HaoFengChenFu/X02X03X04_Casa_Domotica/README.md

# Proyecto de la Casa Domotica

***
**Pines usados**
***
| Pines | Funcionalidad |
|---|---|
| PE11  | Interrupción PIR |
| PD12  | Interrupción del mando a distancia 	|
| PC13  | Interrupción del botón de usuario |
| PC3 | ADC del LDR |
| PD15	| PWM LDR (TIM4_CH4)		|
| PB8 | SCL Temperatura y Humedad |
| PB9 | SDA Temperatura y Humedad |
| PC6	| Ventilador				|
| PB4 | Servomotor Ventilador 	|
| PF7  | Servomotor Puertas Garaje |
| PC0 | ADC Corriente |
| PA3 | ADC Sismo |

***
**Tareas pendientes**
***
Cuando se haya acabado una tarea hay que entrar en el README.md y añadir una x al [ ] --> [x]

| Tarea 	| Descripcion 							| Check	|
|---|---|---|
| Consumo LCD 	| Mostrar el consumo en el LCD 						|<ul><li>- [x] Acabado </li></ul>|
| Alimentacion	| Acabar la alimentacion de la placa y los sensores	|<ul><li>- [ ] Acabado </li></ul>|
| Servidor 	| Acabar el servidor 								|<ul><li>- [x] Acabado </li></ul>|
| Bajo consumo  | Gestionar el modo de bajo consumo					|<ul><li>- [ ] Acabado </li></ul>|
| Flash			| Gestionar el guardado de la Flash					|<ul><li>- [ ] Acabado </li></ul>|
