HaoFengChenFu/X02X03X04_Casa_Domotica/Memoria.docx

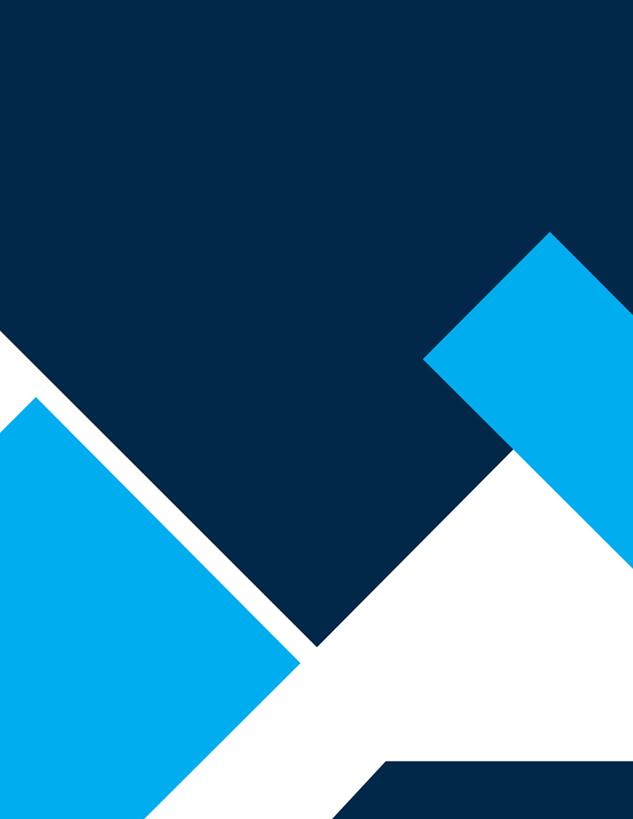
[picture p1: figure]

Ingeniería de Sistemas Electrónicos

Casa Domótica

Curso 2022-2023

Bloque 2

Autores:

Hao Feng Chen Fu

Álvaro Rodriguez Piñeiro

Jaime Ruiz López

Gonzalo Santa Cruz del Río

Valeriu Petre Stanca

# 1 Objetivos de la PRÁCTICA

T

## 1.1 Resumen de los objetivos de la práctica realizada

## 1.2 Acrónimos utilizados

PIR | Passive InfraRed
GPIO | General Purpose Input/Output
I2C | Inter-Integrated Circuit
SPI | Serial Peripherical Interface
ISR | Interrupt Service Routine
PWM | Pulse Width Modulation
LCD | Liquid Cristal Display
LED | Light-Emitting Diode
ADC | Analog-to-Digital Converter
SW | Software
HW | Hardware

## 1.3 Tiempo empleado en la realización de la práctica.

| [Tiempo empleado para realizar la práctica]: El tiempo total empleado ha sido de 400 horas aproximadamente.

## 1.4 Bibliografía utilizada

[RD1] Manual de usuario, Carmine Noviello – Mastering STM32
[RD2] Datasheet, SHT30
[RD3] Datasheet, HC-SR501
[RD4] Datasheet, HXYP-2S-A18 2S

## 1.5 Autoevaluación.

- Identificar en un documento de especificaciones técnicas de un sistema electrónico los requisitos técnicos necesarios para plantear diferentes alternativas tecnológicas para la implementación práctica del mismo.
- Desarrollar un sistema electrónico de mediana complejidad combinando diferentes tecnologías
- Construir sistemas electrónicos utilizando PCBs aplicando las técnicas de diseño adecuadas a la tipología del diseño
- Emplear la instrumentación de laboratorio, las herramientas de desarrollo y depuración comerciales para la integración y puesta a punto de circuitos y sistemas electrónicos.
- Saber generar documentación precisa y transferible sobre el sistema desarrollado.

EXPLICAR ALGUNA DIFICULTAD DEL PROYECTO

Una de las dificultades que hemos encontrado a la hora de realizar el proyecto es el tema de la alimentacion, ya que debiamos encontrar una manera de alimentar todos los subsistemas del proyecto haciendo uso de alimentacion externa. Para este proposito hemos elegido un par de baterias 18650 puestas en serie, ya que con esto obteniamos 7.4V de alimentacion (8.4V en vacio). Junto con esto hemos elgido una celula fotovoltaica para cargar dichas baterias, junto a un modulo de carga (HXYP-2S-A18 2S) para evitar tanto sobrecargas como sobredescargas. El problema real que encontramos es el de conseguir la tensión suficiente como para cargar dichas baterias, ya que la celula nos entregaba 5V y el modulo de carga demandaba 9V para cargar las baterias. Finalmente decidimos comprar un par de celulas mas y conectarlas en serie junto a la otra para conseguir la tensión minima necesaria.

Otra dificultad encontrada durante el desarrollo del proyecto ha sido a la hora del diseño y soldado de las placas de circuito impreso, ya que durante el diseño de estas se cometieron un par de errores como son el olvido a la hora de colocar un condensador en una placa y una pista necesaria en otra de las placas. Ambos errores fueron facilmente subsanables y no hubo mayor problema.

La mayor dificultad encontrada, por lo menos en la parte HW, fue el tema del acondicionamiento del sensor piezoelectrico, ya que era un componente poco trabajado y del que poseaimos pocos conocimientos. Tras unas intensas busquedas y despues de informarnos acerca del funcionamiento de estos, conseguimos acondicionarlo de manera adecuada y ponerlo a trabajar de la forma que queriamos.

# 2 RECURSOS UTILIZADOS DEL MICROCONTROLADOR

## 2.1 Diagrama de bloques hardware del sistema.

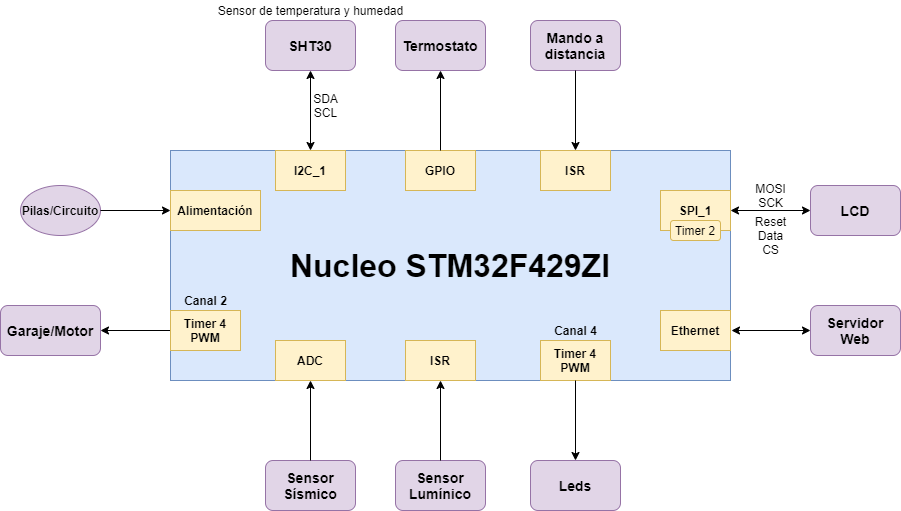
[picture p2: figure]

Figura 1: Conexión hardware

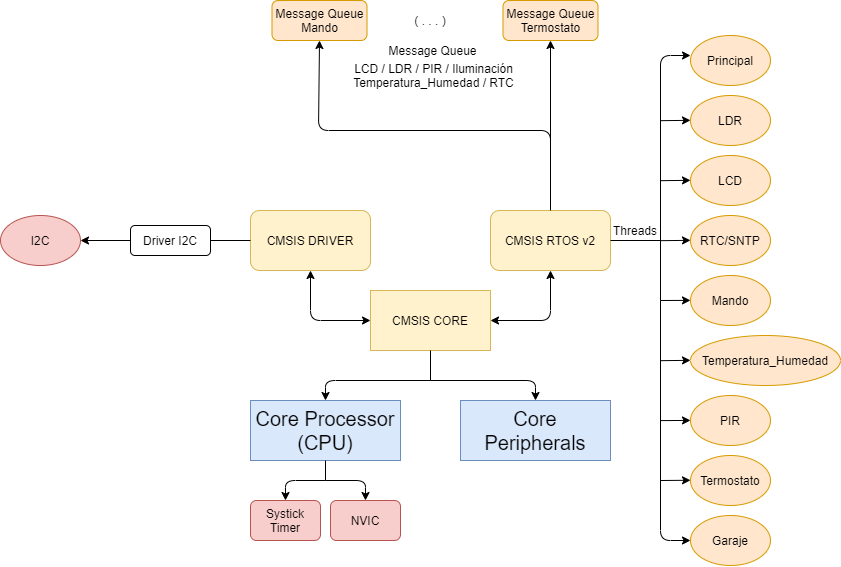
[picture p3: figure]

Figura 2: Conexiones del CMSIS

Pines STM32F429ZI | Funcionalidad
PE11 | Interrupción PIR
PD12 | Interrupción mando a distancia
PC13 | Interrupción del botón de usuario
PC3 | ADC del LDR
PD15 | Salida PWM para la iluminación
PB8 | Pin SCL para el sensor de temperatura y humedad
PB9 | Pin SDA para el sensor de temperatura y humedad
PC6 | Salida para encender el ventilador
PB4 | Servomotor del ventilador
PD13 | Servomotor de las puertas del garaje

Tabla 1: Conexión de los pines

Pines STM32F429ZI | Pines mbed | Funcionalidad
+ 3,3 V | DIP40 | Alimentación
GND | DIP1 | Masa
PB5 | DIP5 | MOSI
PA5 | DIP7 | SCK
PD14 | DIP11 | CS
PF13 | DIP8 | A0
PA6 | DIP6 | RESET

Tabla 2: Conexión entre la tarjeta NUCLEO STM32F429Zi y la mbed app board

AUMENTAR LA TABLA DE PINES

## 2.2 Cálculos realizados y justificación de la solución adoptada.

Módulo del sensor PIR:

El sensor PIR tiene 2 modos de funcionamiento: 1 solo disparo o disparos periodicos. Para el uso de la aplicación es mejor el modo de disparos periodicos.

A su vez, es posible configurar 2 parámetros con los potenciometros, uno para ajustar la distancia (3 metros a 7 metros) y otro para ajusta el tiempo de alarma activa (3 segundos a 5 minutos). Sin embargo, el ajuts de los potenciometros no importante para el resultado final.

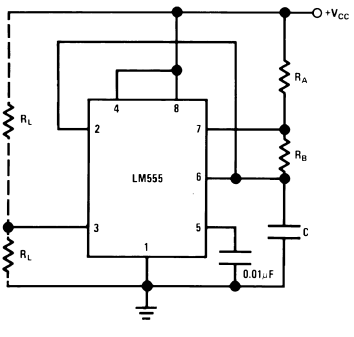
[picture p4: figure]

Módulo del mando a distancia: Frecuencia de funcionamiento del receptor

Módulo del LDR:

Módulo del Sensor Sísmico:

Módulo de Alimentación:

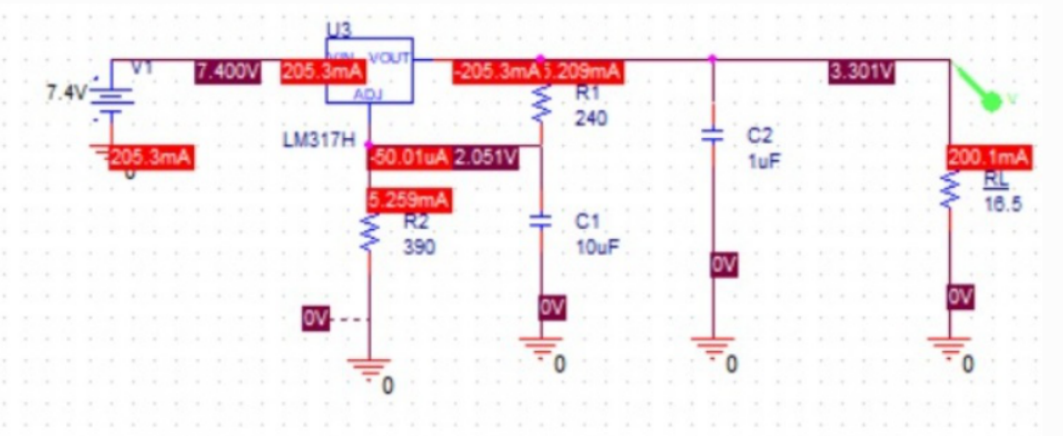
[picture p5: figure]

Para la tensión regulada de 3v3 se ha montado el anterior circuito utilizando un regulador LM317 y sus componentes indicados en la hoja de datos del fabricante. Se ha hecho uso de un potenciometro para regular la tensión de salida del circuito y poder asi llegar a la tensión deseada.

En dicho circuito, al pasar de una tensión de 8v4 a 3v3 considerabamos necesario al menos desarrollar los calculos de potencia para descartar o asegurar el uso de un disipador de calor para el regulador:

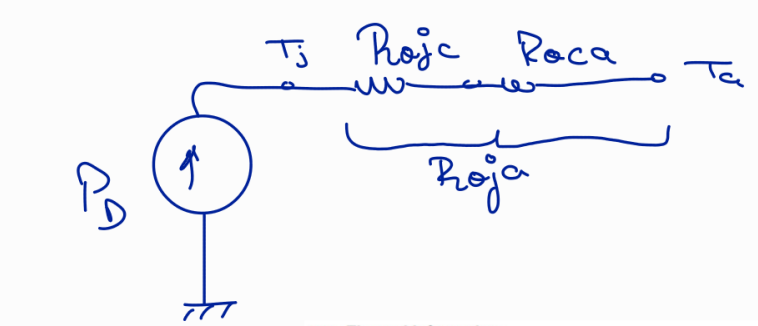
[picture p6: figure]

P_D =(V_(IN) -V_O )·I_O =(8-3.3)·0.2=0.94 W

Tj_(LM317) =P_D ·R_(θja) +T_a =0.94·23.5+30=52.09 ºC<Tj_(MAXLM317) (150ºC)→→No hay necesidad de disipador

# 3 SOFTWARE

## 3.1 Descripción de cada uno de los módulos del sistema

Módulo del sensor de temperatura y humedad:

Este módulo configura el sensor de temperatura y humedad relativa que funciona con el protocolo de comunicación I2C. Se configura en su modo de adquisición periodica para luego leer los datos de los registros de lectura. Tras eso, se realiza una conversión de los datos obtenidos, se envía a una cola de mensajes y espera 1 segundo para volver a leer los registros, esto se realiza sucesivamente.

Módulo del LCD:

Este módulo configura inicialmente el protocolo de comunicación SPI para poder usar el LCD, tras esa

configuración inicial se inicializa una cola donde a través de una estructura guardará la información de la temperatura, la humedad relativa, las horas y la fecha. Asimismo, con la pulsación del pulsador azul se muestra en el LCD el consumo de la aplicación.

Tras la captura de los datos en el display mostrará la información obtenida de la cola de mensajes y refrescará cada 1 segundo.

Módulo del sensor PIR:

Este módulo gestiona las interrupciones generadas por el sensor PIR. Cuando hay una interrupción se envía por una cola de mensajes si se ha detectado algún movimiento.

Módulo del mando a distancia:

Este módulo gestiona la activación de una señal de habilitación para el módulo del garaje. Está señal tendrá dos posibles valores, nivel alto y nivel bajo, dependiendo de si el receptor LED, recibe información del emisor a través de una frecuencia determinada, en nuestro caso, alrededor de 38 KHz.

Módulo del RTC:

Este módulo configura el RTC. Cada que pasa 1 segundo aumenta los segundos en una unidad, simulando de esta forma un reloj.

Módulo del SNTP:

Este módulo es el encargado de sincronizar el RTC con el tiempo real.

Módulo del LDR:

Módulo del Termostato:

Módulo del Garaje:

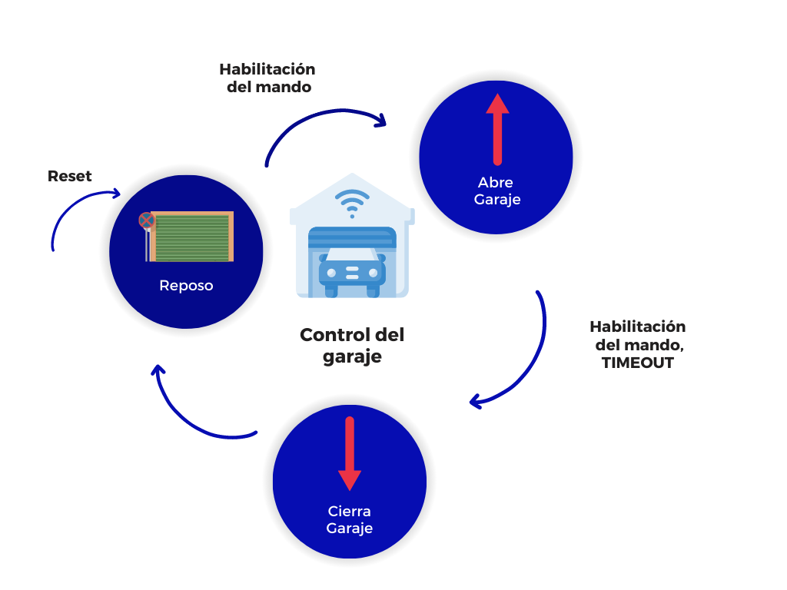
[picture p7: figure]

Una vez se ha recibido la señal de habilitación del módulo del mando a distancia, este bloque se encargar de manejar con un pwm la activación de un motor que abra o cierra la puerta de un garaje. Por defecto la puerta estará cerrada, ya que en caso de solo detectar una activación por parte del módulo mando a distancia (abrir), se cerrará sola con un cierto TIMEOUT. Después de la primera habilitación del módulo mando a distancia, sucesivas activaciones harán variar el estado de la puerta del garaje entre subir o bajar.

## 3.2 Descripción global del funcionamiento de la aplicación. Descripción del autómata y del diagrama con el comportamiento del software

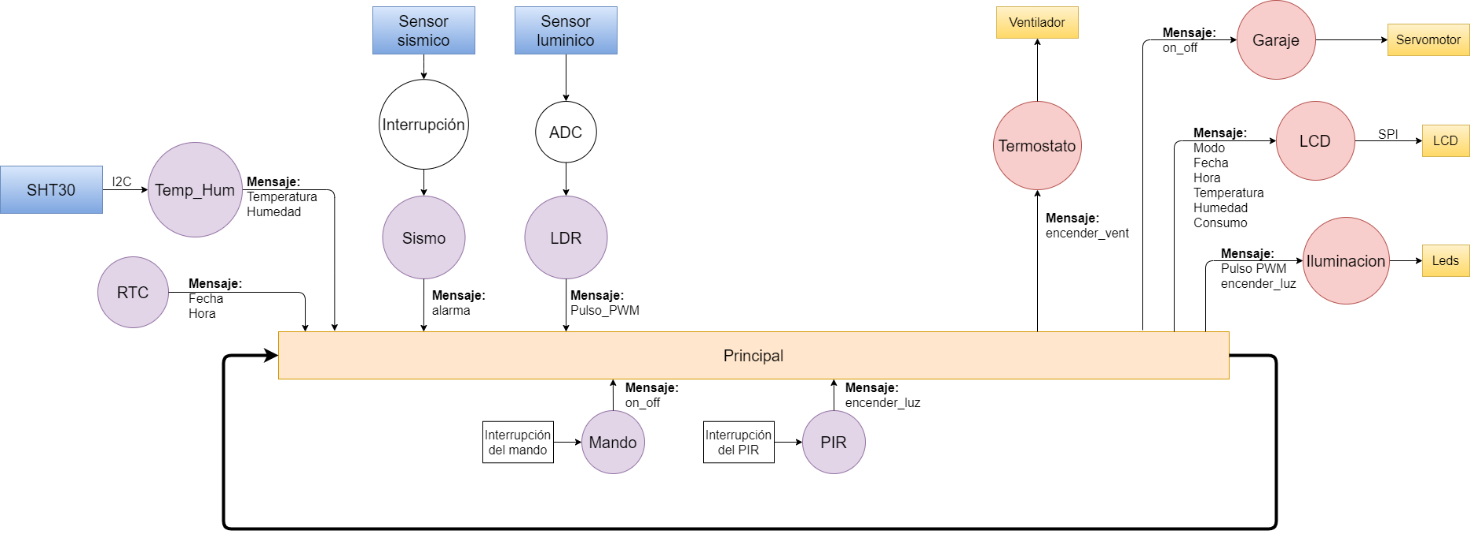
[picture p8: figure]

El funcionamiento de la aplicación es la siguiente:

Inicialmente, tras inicializar toda los hilos, las colas de mensajes y otros recursos, se obtiene información de los módulos de entrada del sistema. Esta información se envía a los módulos de salida, ya sea para representar información, encender las luces o abrir la puerta de un garaje.

La información que envía los módulos Temp_Hum y RTC son los representados en el LCD. Asimismo, el valor de la temperatura es usada para gestionar el encendido de ventilador en el hilo ThTermostato.

La información del LDR y de la interrupción del PIR son usados para gestionar la intensidad de iluminación y encendido de las luces de la casa.

La interrupción del mando es la encargada de abrir o cerrar las puertas del garaje.

## 3.3 Descripción de las rutinas más significativas que ha implementado.

Módulo | Funciones | Otras funciones que se llama | Más detalles
Principal.c | Init_ThPrincipal | osThreadNew() | Inicia el hilo principal.
| ThPrincipal | osMessageQueueGet() osMessageQueuePut() | Gestiona las colas de mensajes de diferentes módulos. Más información: Tabla 2: Entradas y Salidas del Principal
| Init_All_Pins | Init_PIR_Pin() Init_PWM_Pin() Init_Mando_Pin() | Inicia todos los pines de la aplicación
| Init_All_Threads | Init_ThThermostato() Init_ThLCD() Init_ThRTC() Init_ThSNTP() Init_ThTemp_Hum() Init_ThPIR() Init_ThLDR() Init_ThIluminacion() Init_ThMando() | Inicia todos los hilos de la aplicación
Lcd.c | Init_ThLCD | LCD_reset() LCD_Init() | Inicia el hilo del lcd.c y configura la comunicación SPI
| ThLCD | Init_MsgLCD() LCD_clear() LCD_update() osMessageQueueGet() Sprintf() LCD_symbolToLocalBuffer_L1() LCD_symbolToLocalBuffer_L2() osThreadYield() | Muestra información sobre la temperatura, la humedad relativa, las horas y la fecha en el LCD en función de los datos que recibe por la cola de mensajes.
| Init_MsgLCD | osMessageQueueNew() | Inicia la cola de mensajes del LCD
| LCD_reset | SPI_Init() HAL_GPIO_Init() HAL_GPIO_WritePin() Reset_Signal() | Inicia el SPI, configura los pines de datos, de reset y de CS, y genera una señal de reset
| LCD_Init | LCD_wr_cmd() | Envía comandos para configurar el LCD
| LCD_update | LCD_wr_cmd() LCD_wr_data() | Actualiza los pixeles del LCD en función del contenido de un buffer de tamaño 512
| LCD_clear | LCD_update() | Pone a 0 todos los elementos del buffer de tamaño 512 y actualiza los pixeles del LCD
| LCD_symbolToLocalBuffer_L1 | ------ | Escribe en las páginas 0 y 1 del LCD
| LCD_symbolToLocalBuffer_L2 | ------ | Escribe en las páginas 2 y 3 del LCD
Temp_Hum.c | Init_ThTemp | osThreadNew() I2C -> Initialize () I2C -> PowerControl () I2C -> Control (); | Inicia el hilo de la temperatura y humedad, y configura la comunicación I2C
| ThTemp | Init_MsgTemp() Init_timer_TempHum() Config_Communication() ReadSensorData() osMessageQueuePut() | Realiza las transacciones de escritura y lectura para obtener la temperatura y la humedad relativa. Se hace una conversión y se envía a la cola de mensajes. Inicia un timer virtual y espera a que se active un flag para volver a obtener valores de tempertura y humedad relativa.
| I2C_SignalEvent_TEMP_HUM | osThreadFlagsSet() | Activa un flag del hilo cuando se ha acabado una transferencia I2C.
| Init_MsgTemp | osMessageQueueNew() | Inicia la cola de mensajes del Temperatura.c
| Init_timer_TempHum | osTimerNew() | Inicia un timer para leer los registros cada 1 segundo
| Timer_TempHum_Callback | osThreadFlagsSet() | Callback del timer virtual, activa el flag 0x2 para indicar que puede volver a leer los registros del sensor.
| Config_Communication | Set_PeriodicAdq_Mode() SetSingleShotMode() I2C -> MasterTransmit () osThreadFlagsWait() | Elige el modo de adquisición de datos: 1 es para el modo periodico y 0 para obtener datos 1 vez. Realiza una transacción de escritura para configurar los regitros del sensor.
| Set_PeriodicAdq_Mode | ------ | Configura los comandos de escritura para que se modifiquen los registros de lectura periodicamente.
| SetSingleShotMode | ------ | Configura los comandos de escritura para que se modifiquen los registros de lectura una vez.
| ReadSensorData | I2C -> MasterReceive () osThreadFlagsWait() | Lee los registros del sensor, realiza la conversión de los datos y la información que se va a intrudir en la cola de mensajes.
PIR.c | Init_PIR_Pin | __HAL_RCC_GPIOE_CLK_ENABLE() HAL_GPIO_Init() HAL_NVIC_EnableIRQ() | Inicializa y habilita las interrupciones del PIN E11 tanto la bajada como la subida.
| Init_MsgPIR | osMessageQueueNew() | Inicializa la cola de mensajes del PIR
| EXTI15_10_IRQHandler | HAL_GPIO_EXTI_IRQHandler() | Maneja las solicitud de las interrupciones externas del pin 11
| HAL_GPIO_EXTI_Callback | HAL_GPIO_ReadPin() osMessageQueuePut() | Vigila si el pin está a nivel alto o bajo después de la interrupción, en función de eso indica si ha habido movimiento o no y lo envía a la cola de mensajes.
SNTP.c | Init_ThSNTP | osThreadNew() | Inicia el hilo del SNTP
| SNTP_Thread | Init_Timer_SNTP() osTimerStart() osThreadFlagWait() | Se encarga de sincronizar el RTC cada 5 minutos e inicializa el timer virtual.
| Init_Timer_SNTP | osTimerNew() | Función que inicializa el timer virtual.
| TimerSNTP_Callback | Get_SNTP_Time() osThreadFlagsSet() | Callback del timer virtual donde se obtiene el tiempo local que se usa para actualizar el RTC
| get_SNTP_Time | netSNTPc_GetTime() | Función encargada de enviar una petición SNTP
| time_callback | getLocalTime | Callback usado en la función netsSNTPc_GetTime, si la función ha devuelto un valor no nulo realiza una conversión de segundos al tiempo local.
| getLocalTime | strftime() *localtime() Set_RTC_Time() Set_RTC_Date() | Función encarga de actualizar el tiempo y la fecha del RTC al tiempo actual.
RTC.c | Init_ThRTC | osThreadNew() RTC_Init() | Inicia el hilo del RTC
| RTC_Thread | Init_timer_RTC() Init_MsgRTC() osTimerStart() osThreadFlagsWait() | Inicializa el timer virtual y la cola de mensajes del RTC. También se encarga de actualizar el RTC cada 1 segundo
| Init_timer_RTC | osTimerNew() | Función que inicializa el timer virtual.
| TimerRTC_Callback | Get_Date_Time() osMessageQueuePut() osThreadFlagsSet() | Callback del timer virtual donde se obtiene el tiempo y la fecha del RTC para enviarlo a una cola de mensajes.
| Init_MsgRTC | osMessageQueueNew() | Inicia la cola de mensajes del RTC.c
| Get_Date_Time | HAL_RTC_GetTime() HAL_RTC_GetDate() | Función que obtiene el tiempo y la fecha (En ese orden).
| RTC_Init | __HAL_RCC_RTC_ENABLE() HAL_PWR_EnableBkUpAccess() __HAL_RCC_PWR_CLK_ENABLE() HAL_NVIC_EnableIRQ() HAL_RTC_Init() | Inicializa y habilita el RTC
| Get_RTC_Time | HAL_RTC_GetTime() | Función que obtiene el tiempo del RTC
| Get_Date_RTC | HAL_RTC_GetDate() | Función que obtiene la fecha del RTC
| Set_RTC_Time | HAL_RTC_SetTime() | Función que configura el tiempo del RTC
| Set_RTC_Date | HAL_RTC_SetDate() | Función que configura la fecha del RTC
LDR.c | Init_ThLDR | osThreadNew() ADC1_pins_F429ZI_config() | Inicia el hilo del LDR y configura los pines del ADC
| ThLDR | Init_MsgLDR() ADC_getVoltage() osMessageQueuePut() | Se encarga de inicializar la cola de mensajes y obtiene la tensión a la salida del LDR. Cuando el porcentaje de la tensión actual es diferente al porcentaje anterior se envía el porcentaje del pulso a la cola de mensajes.
| Init_MsgLDR | osMessageQueueNew() | Inicia la cola de mensajes del LDR.c
Iluminacion.c | Init_ThIluminacion | osThreadNew() Init_PWM_Iluminacion_Pin() | Inicia el hilo de la Iluminacion y configura los pines
| ThIluminacion | Init_MsgIluminacion() osMessageQueueGet() Config_PWM_Pulse() | Se encarga de inicializar la colade mensajes y en función del dato recibido configura el PWM
| Init_PWM_Iluminacion_Pin | __HAL_RCC_GPIOD_CLK_ENABLE() __HAL_RCC_TIM4_CLK_ENABLE() HAL_GPIO_Init() HAL_TIM_PWM_ConfigChannel() | Función que inicializa y habilita el canal 4 del Timer 4 como PWM.
| Config_PWM_Pulse | HAL_TIM_PWM_DeInit() HAL_TIM_PWM_Stop() HAL_TIM_OC_Init() HAL_TIM_PWM_Init() HAL_TIM_PWM_ConfigChannel() HAL_TIM_PWM_Start() | Función que para el pulso del PWM, configura a un nuevo pulso y lo vuelve a iniciar.
| Init_MsgIluminacion | osMessageQueueNew() | Inicia la cola de mensajes del Iluminacion.c
ThTermostato.c | Init_ThThermostato | osThreadNew() | Inicia el hilo de la ThTermostato.c
| ThTermostato | Init_Ventilador_Msg() osMessageQueueGet() encender_ventilador() apagar_ventilador() | Se encarga de inicializar la cola de mensajes y en función del dato recibido enciendo o apaga el ventilador.
| init_ventilador | __HAL_RCC_GPIOC_CLK_ENABLE() HAL_GPIO_Init() HAL_GPIO_WritePin() | Función que inicializa el pin del Ventilador.
| Init_Ventilador_Msg | osMessageQueueNew() | Inicia la cola de mensajes del Termostato
| encender_ventilador | HAL_GPIO_WritePin() | Enciende el ventilador
| apagar_ventilador | HAL_GPIO_WritePin() | Apaga el ventilador
Mando.c | Init_ThMando | osThreadNew() | Inicializa el hilo de Mando.c
| Init_Mando_Pin | __HAL_RCC_GPIOD_CLK_ENABLE HAL_NVIC_EnableIRQ HAL_GPIO_Init | Configura el pin para que se pueda recibir interrupciones del mando
| Init_Timer_Rebotes | osTimerNew | Inicializa un timer para evitar rebotes
| Init_MsgQueue_Mando | osMessageQueueNew | Inicializa la cola de mensajes
| ThMando | Init_MsgQueue_Mando Init_Timer_Rebotes osThreadFlagsWait osTimerStart | Se encarga de inicializar el timer virtual y la cola de mensajes. Cuan hay una interrupción se arranca el timer virtual y se envía mensajes a la cola de mensajes.
Garaje.c | Init_ThGaraje | osThreadNew() Init_PWM_Garaje | Inicializa el hilo de garaje.c
| Init_PWM_Garaje | __HAL_RCC_GPIOD_CLK_ENABLE() __HAL_RCC_TIM4_CLK_ENABLE() HAL_TIM_PWM_ConfigChannel () | Configura el timer harware usado para mover la puerta del garaje con un servomotor
| ThGaraje | Init_MsgQueue_Garaje osMessageQueuGet | Se encarga de inicializar la cola de mensajes y en función del dato recibido abre o cierra el garaje.
| Init_MsgQueue_Garaje | osMessageQueueNew() | Inicia la colad e mensajes
| Config_PWM_Pulse_Garaje | HAL_TIM_PWM_DeInit() HAL_TIM_PWM_Stop() HAL_TIM_OC_Init() HAL_TIM_PWM_Init() HAL_TIM_PWM_Start() | Funcion usada para mover la puerta del garaje

Tabla 3: Rutinas de los módulos

Tabla de mensajes del Principal:

Mensajes de entrada
Entradas | Acciones | Salidas
mid_MsgPIR | Lleva el dato de encender las luces de la casa cuando hay movimiento | mid_MsgIluminacion
mid_MsgRTC | Lleva los valores de las horas y fechas que se van a mostrar en el LCD y la web | mid_MsgLCD
mid_MsgLDR | Lleva los valores de la intensisdad de la luz | mid_MsgIluminacion
mid_MsgTemp_Hum | Lleva los valores de la temperatura y humedad que se van a mostrar en el LCD y la web | mid_MsgLCD
mid_MsgMando | Lleva el dato que abre y cierra la puerta del garaje | mid_MsgGaraje

Tabla 4: Entradas y Salidas del Principal

# 4 DEPURACION Y TEST

## 4.1 Pruebas realizadas.

Prueba del sensor de temperatura y humedad:

La prueba del sensor de temperatura y humedad no se necesitan condiciones de entrada.

Esta prueba consiste en verificar el funcionamiento del módulo Temp_Hum.c, tales como los valores correspondientes de las medidas y el correcto funcionamiento de la cola de mensajes. Asimismo, sólo se necesita un módulo de test para comprobar el funcionamiento de la cola de mensajes y con las herramientas, Debugguer y Debug printf, ofrecidas por el entorno de desarrollo Keil permite observar los printf de forma que se puede comprobar los valores devueltos por el sensor.

Se espera que el módulo Temp_Hum cuando realice una medida cada 1 segundo para enviar los resultados a la cola de mensajes y con la ayuda de otro módulo, Test, extrae los resultados y los muestra los resultados obtenidos con un printf.

Los resultados obtenidos son los esperados, cuando se obtiene información del sensor esta se envía a la cola de mensajes y el módulo de test extrae la información y la representa en el terminal.

Prueba del sensor PIR:

La prueba del sensor PIR necesita condiciones de entrada, esta es la salida del sensor que puede ser un nivel alto o un nivel bajo.

Esta prueba consiste en verificar el funcionamiento del módulo PIR, se requiere de un módulo de leds porque el sensor PIR es la encargada de encender o apagar la iluminación de la casa.

Se espera que cuando haya algún movimiento se debe encender un led, mientras que cuando no haya movimiento el led debe estar apagado.

Los resultados obtenidos son los esperados porque cuando hay movimiento en frente del sensor PIR detecta el movimiento el led se enciende cuando ha dejado de haber moviemiento el led se apaga.

Prueba del sensor lumínico:

Prueba del sensor sísmico:

Prueba del LCD:

La prueba del LCD requiere de los siguientes módulos externos: Temp_Humc y RTC.c

La prueba consiste en comprobar la representación de la temperatura, la humedad relativa, las horas y la fecha en el LCD y el funcionamiento correcto de la cola de mensajes porque así es como este módulo va a obtener la informacion, por ello, se incluye un módulo Test que es la encargada de enviar la información a la cola de mensajes del módulo LCD. Con la pulsación del pulsador azul pasa a mostrar el valor del consumo.

Se espera que los valores de la temperatura, la humedad relativa, el consumo, las horas y la fecha varien cada segundo (Por lo menos debe variar las horas) en el LCD y que haya ningún problema con las colas de mensajes.

Los resultados son los esperados porque hay cambios en los valores de la información que representa el LCD cada 1 segundo.Además, cuando se pulsa el botón azul muestra el valor del consumo.

Prueba del mando a distancia:

Se ha montado la placa de circuito impreso del mando a distancia (Vcc=6v) y se ha conectado el receptor en la STM32. Al apretar el boton del mando a distancia, y enfocandolo hacia el receptor, se ha activado un led que simboliza que se ha detectado dicha señal. (DESARROLLAR LA PARTE SW)

Prueba del termostato:

Prueba del Garaje:

# 5 Otras informaciones sobre la aplicación

UN TEXTO IMPORTANTE

Lorem ipsum dolor sit amet consectetur adipiscing elit.

Lorem ipsum dolor sit amet consectetur adipiscing elit.
