HaoFengChenFu/X02X03X04_Casa_Domotica/Docu/Termostato/memoria termostato.docx

TERMOSTATO

1. OBJETIVO

El objetivo consiste en “regular” la temperatura de la casa, la cual esta recogida por un sensor de temperatura y humedad que se comunica con nuestro microprocesador por I2C. La temperatura, se consigue regular mediante un ventilador que funciona con 5V a 20 mA. Este ventilador se situará próximo al sensor de temperatura, de manera que sea más sencillo “regular” la temperatura. Además, utilizamos un servomotor que irá conectado directamente al ventilador para conseguir que se mueva lentamente el ventilador. De tal manera que conseguiremos el mismo efecto de movimiento que un ventilador casero. El servomotor, lo movemos aproximadamente 180º con una cadencia de 20 ms/grado para generar dicho efecto de movimiento.

2. ESPECIFICACIONES
- Circuito de control del ventilador:

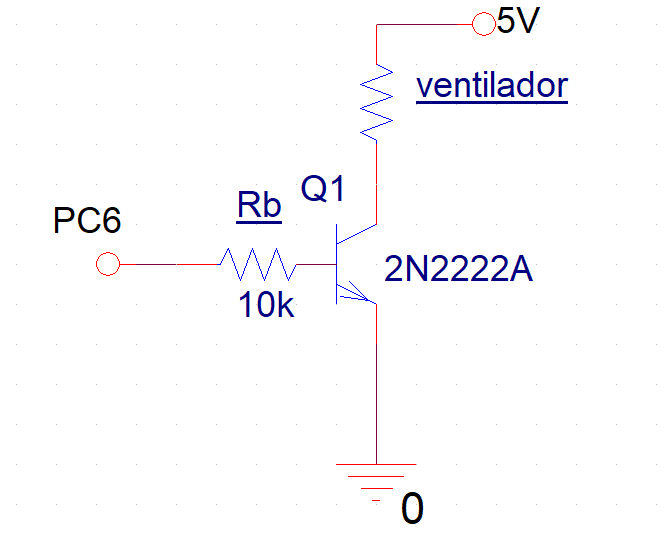
[picture p13: figure]

Como nuestro ventilador funciona a 5V, no podemos conectar directamente el ventilador a un pin digital de la placa ya que como máximo tendríamos una tensión de 3,3V. Esto no será suficiente para excitar a nuestro ventilador. Es por ello, que utilizamos este transistor en conmutación para excitar nuestro ventilador. Además, hemos incluido una resistencia en la base para limitar la corriente por el transistor. De esta manera con Rb=10KΩ, conseguimos limitar la corriente del colector a 56 mA. Con esta corriente, sabemos que la tensión que cae en el transistor Vce es de 50 mV como se puede ver en el datasheet:

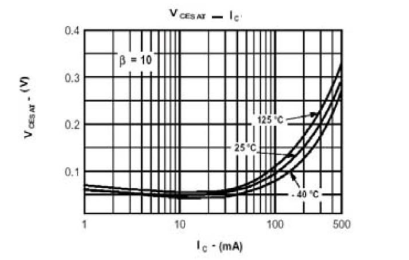
[picture p14: figure]

De tal manera que estamos saturando el transistor y permitiendo una mejora en el funcionamiento del ventilador. Ya que ahora si funciona con la tensión de funcionamiento del ventilador (5 V y una corriente por encima de los 20 mA ).

En base a esto, cuando pongamos un “1” en la base del transistor, el ventilador se activará y cuando pongamos un “0” el ventilador se apagará.

- Servomotor:

El servomotor que utilizamos funciona en base a una señal PWM, la cual en función del ancho del pulso controlaremos la posición del servo. Según lo que nos dice el datasheet el periodo de la señal debe de ser de 50 Hz. Por otra parte, el ancho del pulso ira desde 1 a 2 ms, para controlar la posición desde -90º a 90º.

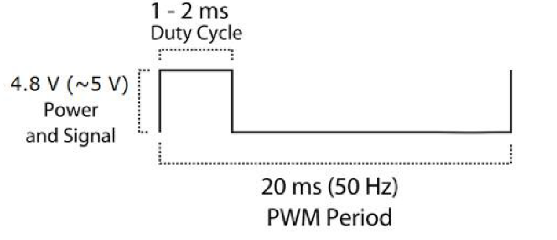
[picture p15: figure]

Algunos de los valores más significativos, son, por ejemplo:

mover a 0º= ancho de 1,5 ms (pulse=600)

mover a 90º= ancho de 2 ms (pulse=800)

mover a -90º= ancho de 1 ms (pulse=600)

3. MONTAJE
- Circuito de control del ventilador:
- Servomotor:

Según nos dice el datasheet:

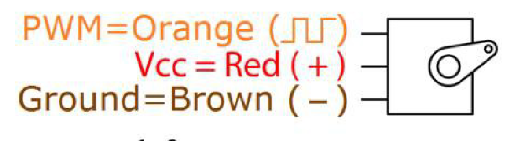
[picture p16: figure]

La señal PWM, la sacamos

4. PRUEBAS
5. ALIMENTACIÓN
6. BIBLIOGRAFÍA
