HaoFengChenFu/X02X03X04_Casa_Domotica/Docu/Alimentacion/Notes_230409_142933.pdf

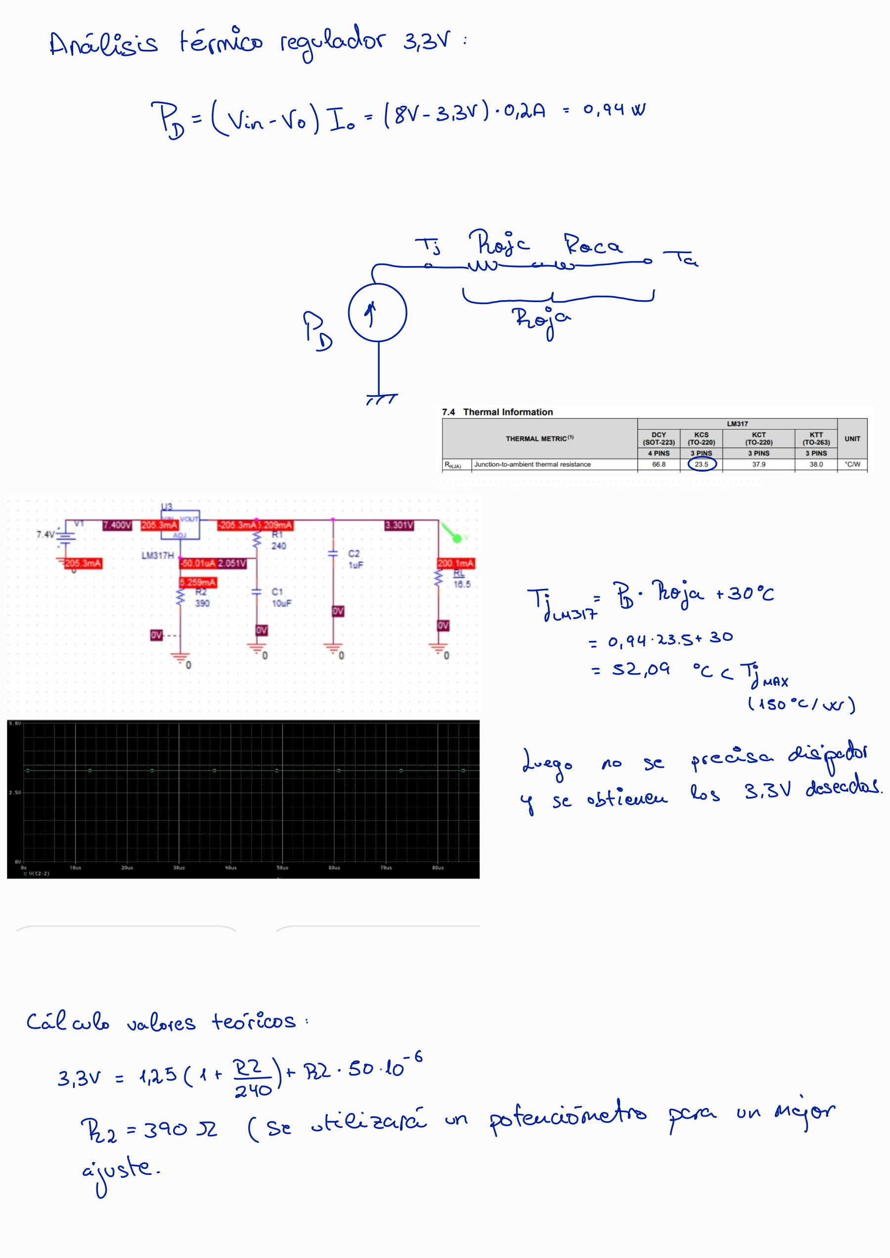
[picture p59: page 1]
