HaoFengChenFu/X02X03X04_Casa_Domotica/Presupuesto.xlsx

COMPRADOR | COMPONENTES | PRECIO | Total Gonzalo | 73.1
Gonzalo | Placa de topos fibra doble cara | 4.84 | Total Hao | 18.89
Gonzalo | Condensador cerámico 100 nF | 0.22 | Total Jaime | 24.07
Gonzalo | Condensador cerámico 220 nF | 0.36 | Total Valeriu | 1.44
Gonzalo | Circuito Integrado TL071 | 1.21
Gonzalo | 10 Resistencias 6,8 MOhm | 0.3 | Total | 117.5
Gonzalo | Portapilas | 2.42
Gonzalo | 2 Pilas Recargables 18650 | 9.9
Gonzalo | 2 Circuito Integrado L7805 | 1.1
Hao | Módulo Cargador de baterias | 2.52
Hao | 2 Leds emisores | 0.59
Hao | 3 Leds receptores | 3.08
Hao | 6 LDR | 2.59
Jaime | Panel Solar | 9.99
Jaime | 20 Piezoeléctricos | 6.99
Gonzalo | PLA | 10
Jaime | 10 Pilas boton 3V | 7.09
Valeriu | 2 Circuito Integrado LM555 | 1.44
Hao | PIR | 2.24
Hao | Sensor de temperatura y humedad | 7.87
Gonzalo | ultima compra | 8.85
Gonzalo | pcbs | 33.9
