HaoFengChenFu/X02X03X04_Casa_Domotica/Docu/Esquematicos/BOM_TODO_2023-04-20.csv

ID | Name | Designator | Quantity
1 | 1025 | BT1 | 1
2 | 0.01u | C | 1
3 | 0.1u | C1,C2,C4 | 3
4 | 470n | C3 | 1
5 | 1u | C5 | 1
6 | 330u | C6 | 1
7 | 100n | C7,C9,C11 | 3
8 | 330n | C8 | 1
9 | 10u | C10 | 1
10 | 10n | C12 | 1
11 | 1n | C13 | 1
12 | 503UOC | D1 | 1
13 | Vcc | JP1,JP6 | 2
14 | 3V3 | JP2,JP9 | 2
15 | PiezoIn | JP3 | 1
16 | PiezoOut | JP4 | 1
17 | HDR-F-2.54_1x3 | JP5 | 1
18 | 5V_1 | JP7 | 1
19 | 5V_2 | JP8 | 1
20 | Sens | JP10 | 1
21 | 9k2 | R1,R2,R3,RA_2 | 4
22 | 240 | R4,R9,RB_2 | 3
23 | POT 1k | R5 | 1
24 | 100k | R6,R7 | 2
25 | 1k | R8 | 1
26 | 4k99 | RA_1 | 1
27 | 3k3 | RB_1 | 1
28 | K4-6×6_TH | SW1 | 1
29 | LM555N | U1,U2 | 2
30 | TL071CP | U3 | 1
31 | LM317MTG | U4 | 1
32 | LM7805CT | U5,U6 | 2
33 | ACS712ELCTR-05B | U7 | 1
34 | LM321MF/NOPB | U8 | 1
