HaoFengChenFu/X02X03X04_Casa_Domotica/Prueba_termostato/Objects/Temp_Hum.htm

# Static Call Graph for image .\Objects\Temp_Hum.axf

#<CALLGRAPH># ARM Linker, 5060960: Last Updated: Wed Apr 19 10:20:23 2023

### Maximum Stack Usage = 324 bytes + Unknown(Functions without stacksize, Cycles, Untraceable Function Pointers)

### Call chain for Maximum Stack Depth:

_printf_f ⇒ _printf_fp_dec ⇒ _printf_fp_dec_real ⇒ _fp_digits ⇒ _btod_etento ⇒ _btod_emul ⇒ _e2e

### Functions with no stack information

- __user_initial_stackheap
- SVC_Handler
- PendSV_Handler
- SysTick_Handler

### Mutually Recursive functions

- ADC_IRQHandler ⇒ ADC_IRQHandler
- osRtxThreadListRoot ⇒ osRtxThreadListRoot

### Function Pointers

- ADC_IRQHandler from startup_stm32f429xx.o(.text) referenced from startup_stm32f429xx.o(RESET)
- BusFault_Handler from stm32f4xx_it.o(i.BusFault_Handler) referenced from startup_stm32f429xx.o(RESET)
- CAN1_RX0_IRQHandler from startup_stm32f429xx.o(.text) referenced from startup_stm32f429xx.o(RESET)
- CAN1_RX1_IRQHandler from startup_stm32f429xx.o(.text) referenced from startup_stm32f429xx.o(RESET)
- CAN1_SCE_IRQHandler from startup_stm32f429xx.o(.text) referenced from startup_stm32f429xx.o(RESET)
- CAN1_TX_IRQHandler from startup_stm32f429xx.o(.text) referenced from startup_stm32f429xx.o(RESET)
- CAN2_RX0_IRQHandler from startup_stm32f429xx.o(.text) referenced from startup_stm32f429xx.o(RESET)
- CAN2_RX1_IRQHandler from startup_stm32f429xx.o(.text) referenced from startup_stm32f429xx.o(RESET)
- CAN2_SCE_IRQHandler from startup_stm32f429xx.o(.text) referenced from startup_stm32f429xx.o(RESET)
- CAN2_TX_IRQHandler from startup_stm32f429xx.o(.text) referenced from startup_stm32f429xx.o(RESET)
- Callback_TimerServo from thtermostato.o(i.Callback_TimerServo) referenced from thtermostato.o(i.Init_servo_Timer_periodic)
- DCMI_IRQHandler from startup_stm32f429xx.o(.text) referenced from startup_stm32f429xx.o(RESET)
- DMA1_Stream0_IRQHandler from startup_stm32f429xx.o(.text) referenced from startup_stm32f429xx.o(RESET)
- DMA1_Stream1_IRQHandler from startup_stm32f429xx.o(.text) referenced from startup_stm32f429xx.o(RESET)
- DMA1_Stream2_IRQHandler from startup_stm32f429xx.o(.text) referenced from startup_stm32f429xx.o(RESET)
- DMA1_Stream3_IRQHandler from startup_stm32f429xx.o(.text) referenced from startup_stm32f429xx.o(RESET)
- DMA1_Stream4_IRQHandler from startup_stm32f429xx.o(.text) referenced from startup_stm32f429xx.o(RESET)
- DMA1_Stream5_IRQHandler from startup_stm32f429xx.o(.text) referenced from startup_stm32f429xx.o(RESET)
- DMA1_Stream6_IRQHandler from startup_stm32f429xx.o(.text) referenced from startup_stm32f429xx.o(RESET)
- DMA1_Stream7_IRQHandler from startup_stm32f429xx.o(.text) referenced from startup_stm32f429xx.o(RESET)
- DMA2D_IRQHandler from startup_stm32f429xx.o(.text) referenced from startup_stm32f429xx.o(RESET)
- DMA2_Stream0_IRQHandler from startup_stm32f429xx.o(.text) referenced from startup_stm32f429xx.o(RESET)
- DMA2_Stream1_IRQHandler from startup_stm32f429xx.o(.text) referenced from startup_stm32f429xx.o(RESET)
- DMA2_Stream2_IRQHandler from startup_stm32f429xx.o(.text) referenced from startup_stm32f429xx.o(RESET)
- DMA2_Stream3_IRQHandler from startup_stm32f429xx.o(.text) referenced from startup_stm32f429xx.o(RESET)
- DMA2_Stream4_IRQHandler from startup_stm32f429xx.o(.text) referenced from startup_stm32f429xx.o(RESET)
- DMA2_Stream5_IRQHandler from startup_stm32f429xx.o(.text) referenced from startup_stm32f429xx.o(RESET)
- DMA2_Stream6_IRQHandler from startup_stm32f429xx.o(.text) referenced from startup_stm32f429xx.o(RESET)
- DMA2_Stream7_IRQHandler from startup_stm32f429xx.o(.text) referenced from startup_stm32f429xx.o(RESET)
- DebugMon_Handler from stm32f4xx_it.o(i.DebugMon_Handler) referenced from startup_stm32f429xx.o(RESET)
- ETH_IRQHandler from startup_stm32f429xx.o(.text) referenced from startup_stm32f429xx.o(RESET)
- ETH_WKUP_IRQHandler from startup_stm32f429xx.o(.text) referenced from startup_stm32f429xx.o(RESET)
- EXTI0_IRQHandler from startup_stm32f429xx.o(.text) referenced from startup_stm32f429xx.o(RESET)
- EXTI15_10_IRQHandler from startup_stm32f429xx.o(.text) referenced from startup_stm32f429xx.o(RESET)
- EXTI1_IRQHandler from startup_stm32f429xx.o(.text) referenced from startup_stm32f429xx.o(RESET)
- EXTI2_IRQHandler from startup_stm32f429xx.o(.text) referenced from startup_stm32f429xx.o(RESET)
- EXTI3_IRQHandler from startup_stm32f429xx.o(.text) referenced from startup_stm32f429xx.o(RESET)
- EXTI4_IRQHandler from startup_stm32f429xx.o(.text) referenced from startup_stm32f429xx.o(RESET)
- EXTI9_5_IRQHandler from startup_stm32f429xx.o(.text) referenced from startup_stm32f429xx.o(RESET)
- FLASH_IRQHandler from startup_stm32f429xx.o(.text) referenced from startup_stm32f429xx.o(RESET)
- FMC_IRQHandler from startup_stm32f429xx.o(.text) referenced from startup_stm32f429xx.o(RESET)
- FPU_IRQHandler from startup_stm32f429xx.o(.text) referenced from startup_stm32f429xx.o(RESET)
- HASH_RNG_IRQHandler from startup_stm32f429xx.o(.text) referenced from startup_stm32f429xx.o(RESET)
- HardFault_Handler from stm32f4xx_it.o(i.HardFault_Handler) referenced from startup_stm32f429xx.o(RESET)
- I2C1_Control from i2c_stm32f4xx.o(i.I2C1_Control) referenced from i2c_stm32f4xx.o(.constdata)
- I2C1_ER_IRQHandler from i2c_stm32f4xx.o(i.I2C1_ER_IRQHandler) referenced from startup_stm32f429xx.o(RESET)
- I2C1_EV_IRQHandler from i2c_stm32f4xx.o(i.I2C1_EV_IRQHandler) referenced from startup_stm32f429xx.o(RESET)
- I2C1_GetDataCount from i2c_stm32f4xx.o(i.I2C1_GetDataCount) referenced from i2c_stm32f4xx.o(.constdata)
- I2C1_GetStatus from i2c_stm32f4xx.o(i.I2C1_GetStatus) referenced from i2c_stm32f4xx.o(.constdata)
- I2C1_Initialize from i2c_stm32f4xx.o(i.I2C1_Initialize) referenced from i2c_stm32f4xx.o(.constdata)
- I2C1_MasterReceive from i2c_stm32f4xx.o(i.I2C1_MasterReceive) referenced from i2c_stm32f4xx.o(.constdata)
- I2C1_MasterTransmit from i2c_stm32f4xx.o(i.I2C1_MasterTransmit) referenced from i2c_stm32f4xx.o(.constdata)
- I2C1_PowerControl from i2c_stm32f4xx.o(i.I2C1_PowerControl) referenced from i2c_stm32f4xx.o(.constdata)
- I2C1_SlaveReceive from i2c_stm32f4xx.o(i.I2C1_SlaveReceive) referenced from i2c_stm32f4xx.o(.constdata)
- I2C1_SlaveTransmit from i2c_stm32f4xx.o(i.I2C1_SlaveTransmit) referenced from i2c_stm32f4xx.o(.constdata)
- I2C1_Uninitialize from i2c_stm32f4xx.o(i.I2C1_Uninitialize) referenced from i2c_stm32f4xx.o(.constdata)
- I2C2_ER_IRQHandler from startup_stm32f429xx.o(.text) referenced from startup_stm32f429xx.o(RESET)
- I2C2_EV_IRQHandler from startup_stm32f429xx.o(.text) referenced from startup_stm32f429xx.o(RESET)
- I2C3_ER_IRQHandler from startup_stm32f429xx.o(.text) referenced from startup_stm32f429xx.o(RESET)
- I2C3_EV_IRQHandler from startup_stm32f429xx.o(.text) referenced from startup_stm32f429xx.o(RESET)
- I2CX_GetCapabilities from i2c_stm32f4xx.o(i.I2CX_GetCapabilities) referenced from i2c_stm32f4xx.o(.constdata)
- I2CX_GetVersion from i2c_stm32f4xx.o(i.I2CX_GetVersion) referenced from i2c_stm32f4xx.o(.constdata)
- I2C_SignalEvent_TEMP_HUM from temp_hum.o(i.I2C_SignalEvent_TEMP_HUM) referenced from temp_hum.o(i.Init_ThTemp_Hum)
- LTDC_ER_IRQHandler from startup_stm32f429xx.o(.text) referenced from startup_stm32f429xx.o(RESET)
- LTDC_IRQHandler from startup_stm32f429xx.o(.text) referenced from startup_stm32f429xx.o(RESET)
- MemManage_Handler from stm32f4xx_it.o(i.MemManage_Handler) referenced from startup_stm32f429xx.o(RESET)
- NMI_Handler from stm32f4xx_it.o(i.NMI_Handler) referenced from startup_stm32f429xx.o(RESET)
- OTG_FS_IRQHandler from startup_stm32f429xx.o(.text) referenced from startup_stm32f429xx.o(RESET)
- OTG_FS_WKUP_IRQHandler from startup_stm32f429xx.o(.text) referenced from startup_stm32f429xx.o(RESET)
- OTG_HS_EP1_IN_IRQHandler from startup_stm32f429xx.o(.text) referenced from startup_stm32f429xx.o(RESET)
- OTG_HS_EP1_OUT_IRQHandler from startup_stm32f429xx.o(.text) referenced from startup_stm32f429xx.o(RESET)
- OTG_HS_IRQHandler from startup_stm32f429xx.o(.text) referenced from startup_stm32f429xx.o(RESET)
- OTG_HS_WKUP_IRQHandler from startup_stm32f429xx.o(.text) referenced from startup_stm32f429xx.o(RESET)
- PVD_IRQHandler from startup_stm32f429xx.o(.text) referenced from startup_stm32f429xx.o(RESET)
- PendSV_Handler from irq_armv7m.o(.text) referenced from startup_stm32f429xx.o(RESET)
- RCC_IRQHandler from startup_stm32f429xx.o(.text) referenced from startup_stm32f429xx.o(RESET)
- RTC_Alarm_IRQHandler from startup_stm32f429xx.o(.text) referenced from startup_stm32f429xx.o(RESET)
- RTC_WKUP_IRQHandler from startup_stm32f429xx.o(.text) referenced from startup_stm32f429xx.o(RESET)
- Reset_Handler from startup_stm32f429xx.o(.text) referenced from startup_stm32f429xx.o(RESET)
- SAI1_IRQHandler from startup_stm32f429xx.o(.text) referenced from startup_stm32f429xx.o(RESET)
- SDIO_IRQHandler from startup_stm32f429xx.o(.text) referenced from startup_stm32f429xx.o(RESET)
- SPI1_IRQHandler from startup_stm32f429xx.o(.text) referenced from startup_stm32f429xx.o(RESET)
- SPI2_IRQHandler from startup_stm32f429xx.o(.text) referenced from startup_stm32f429xx.o(RESET)
- SPI3_IRQHandler from startup_stm32f429xx.o(.text) referenced from startup_stm32f429xx.o(RESET)
- SPI4_IRQHandler from startup_stm32f429xx.o(.text) referenced from startup_stm32f429xx.o(RESET)
- SPI5_IRQHandler from startup_stm32f429xx.o(.text) referenced from startup_stm32f429xx.o(RESET)
- SPI6_IRQHandler from startup_stm32f429xx.o(.text) referenced from startup_stm32f429xx.o(RESET)
- SVC_Handler from irq_armv7m.o(.text) referenced from startup_stm32f429xx.o(RESET)
- SysTick_Handler from irq_armv7m.o(.text) referenced from rtx_kernel.o(.text.svcRtxKernelStart)
- SysTick_Handler from irq_armv7m.o(.text) referenced from startup_stm32f429xx.o(RESET)
- SystemInit from system_stm32f4xx.o(i.SystemInit) referenced from startup_stm32f429xx.o(.text)
- TAMP_STAMP_IRQHandler from startup_stm32f429xx.o(.text) referenced from startup_stm32f429xx.o(RESET)
- TIM1_BRK_TIM9_IRQHandler from startup_stm32f429xx.o(.text) referenced from startup_stm32f429xx.o(RESET)
- TIM1_CC_IRQHandler from startup_stm32f429xx.o(.text) referenced from startup_stm32f429xx.o(RESET)
- TIM1_TRG_COM_TIM11_IRQHandler from startup_stm32f429xx.o(.text) referenced from startup_stm32f429xx.o(RESET)
- TIM1_UP_TIM10_IRQHandler from startup_stm32f429xx.o(.text) referenced from startup_stm32f429xx.o(RESET)
- TIM2_IRQHandler from startup_stm32f429xx.o(.text) referenced from startup_stm32f429xx.o(RESET)
- TIM3_IRQHandler from startup_stm32f429xx.o(.text) referenced from startup_stm32f429xx.o(RESET)
- TIM4_IRQHandler from startup_stm32f429xx.o(.text) referenced from startup_stm32f429xx.o(RESET)
- TIM5_IRQHandler from startup_stm32f429xx.o(.text) referenced from startup_stm32f429xx.o(RESET)
- TIM6_DAC_IRQHandler from startup_stm32f429xx.o(.text) referenced from startup_stm32f429xx.o(RESET)
- TIM7_IRQHandler from startup_stm32f429xx.o(.text) referenced from startup_stm32f429xx.o(RESET)
- TIM8_BRK_TIM12_IRQHandler from startup_stm32f429xx.o(.text) referenced from startup_stm32f429xx.o(RESET)
- TIM8_CC_IRQHandler from startup_stm32f429xx.o(.text) referenced from startup_stm32f429xx.o(RESET)
- TIM8_TRG_COM_TIM14_IRQHandler from startup_stm32f429xx.o(.text) referenced from startup_stm32f429xx.o(RESET)
- TIM8_UP_TIM13_IRQHandler from startup_stm32f429xx.o(.text) referenced from startup_stm32f429xx.o(RESET)
- ThTemp_Hum from temp_hum.o(i.ThTemp_Hum) referenced from temp_hum.o(i.Init_ThTemp_Hum)
- ThTermostato from thtermostato.o(i.ThTermostato) referenced from thtermostato.o(i.Init_ThThermostato)
- Thread from testtemphum.o(i.Thread) referenced from testtemphum.o(i.Init_Thread)
- Timer_TempHum_Callback from temp_hum.o(i.Timer_TempHum_Callback) referenced from temp_hum.o(i.Init_timer_TempHum)
- UART4_IRQHandler from startup_stm32f429xx.o(.text) referenced from startup_stm32f429xx.o(RESET)
- UART5_IRQHandler from startup_stm32f429xx.o(.text) referenced from startup_stm32f429xx.o(RESET)
- UART7_IRQHandler from startup_stm32f429xx.o(.text) referenced from startup_stm32f429xx.o(RESET)
- UART8_IRQHandler from startup_stm32f429xx.o(.text) referenced from startup_stm32f429xx.o(RESET)
- USART1_IRQHandler from startup_stm32f429xx.o(.text) referenced from startup_stm32f429xx.o(RESET)
- USART2_IRQHandler from startup_stm32f429xx.o(.text) referenced from startup_stm32f429xx.o(RESET)
- USART3_IRQHandler from startup_stm32f429xx.o(.text) referenced from startup_stm32f429xx.o(RESET)
- USART6_IRQHandler from startup_stm32f429xx.o(.text) referenced from startup_stm32f429xx.o(RESET)
- UsageFault_Handler from stm32f4xx_it.o(i.UsageFault_Handler) referenced from startup_stm32f429xx.o(RESET)
- WWDG_IRQHandler from startup_stm32f429xx.o(.text) referenced from startup_stm32f429xx.o(RESET)
- __main from __main.o(!!!main) referenced from startup_stm32f429xx.o(.text)
- _fputc$unlocked from fputc.o(i.fputc) referenced from _printf_char_file_locked.o(.text)
- _printf_input_char from _printf_char_common.o(.text) referenced from _printf_char_common.o(.text)
- osRtxIdleThread from rtx_config.o(i.osRtxIdleThread) referenced from rtx_thread.o(.text.osRtxThreadStartup)
- osRtxMemoryInit from rtx_memory.o(.text.osRtxMemoryInit) referenced from rtx_kernel.o(.text.svcRtxKernelInitialize)
- osRtxMessageQueuePostProcess from rtx_msgqueue.o(.text.osRtxMessageQueuePostProcess) referenced from rtx_msgqueue.o(.text.svcRtxMessageQueueNew)
- osRtxThreadPostProcess from rtx_thread.o(.text.osRtxThreadPostProcess) referenced from rtx_thread.o(.text.svcRtxThreadNew)
- osRtxTimerSetup from rtx_timer.o(.text.osRtxTimerSetup) referenced from rtx_lib.o(.rodata)
- osRtxTimerThread from rtx_timer.o(.text.osRtxTimerThread) referenced from rtx_lib.o(.rodata)
- osRtxTimerTick from rtx_timer.o(.text.osRtxTimerTick) referenced from rtx_timer.o(.text.osRtxTimerSetup)
- osThreadExit from rtx_thread.o(.text.osThreadExit) referenced from rtx_thread.o(.text.svcRtxThreadNew)
- svcRtxDelay from rtx_delay.o(.text.svcRtxDelay) referenced from rtx_delay.o(.text.osDelay)
- svcRtxKernelGetState from rtx_kernel.o(.text.svcRtxKernelGetState) referenced from rtx_kernel.o(.text.osKernelGetState)
- svcRtxKernelGetTickCount from rtx_kernel.o(.text.svcRtxKernelGetTickCount) referenced from rtx_kernel.o(.text.osKernelGetTickCount)
- svcRtxKernelInitialize from rtx_kernel.o(.text.svcRtxKernelInitialize) referenced from rtx_kernel.o(.text.osKernelInitialize)
- svcRtxKernelStart from rtx_kernel.o(.text.svcRtxKernelStart) referenced from rtx_kernel.o(.text.osKernelStart)
- svcRtxMessageQueueGet from rtx_msgqueue.o(.text.svcRtxMessageQueueGet) referenced from rtx_msgqueue.o(.text.osMessageQueueGet)
- svcRtxMessageQueueGetCount from rtx_msgqueue.o(.text.svcRtxMessageQueueGetCount) referenced from rtx_msgqueue.o(.text.osMessageQueueGetCount)
- svcRtxMessageQueueNew from rtx_msgqueue.o(.text.svcRtxMessageQueueNew) referenced from rtx_msgqueue.o(.text.osMessageQueueNew)
- svcRtxMessageQueuePut from rtx_msgqueue.o(.text.svcRtxMessageQueuePut) referenced from rtx_msgqueue.o(.text.osMessageQueuePut)
- svcRtxMutexAcquire from rtx_mutex.o(.text.svcRtxMutexAcquire) referenced from rtx_mutex.o(.text.osMutexAcquire)
- svcRtxMutexDelete from rtx_mutex.o(.text.svcRtxMutexDelete) referenced from rtx_mutex.o(.text.osMutexDelete)
- svcRtxMutexNew from rtx_mutex.o(.text.svcRtxMutexNew) referenced from rtx_mutex.o(.text.osMutexNew)
- svcRtxMutexRelease from rtx_mutex.o(.text.svcRtxMutexRelease) referenced from rtx_mutex.o(.text.osMutexRelease)
- svcRtxThreadExit from rtx_thread.o(.text.svcRtxThreadExit) referenced from rtx_thread.o(.text.osThreadExit)
- svcRtxThreadFlagsSet from rtx_thread.o(.text.svcRtxThreadFlagsSet) referenced from rtx_thread.o(.text.osThreadFlagsSet)
- svcRtxThreadFlagsWait from rtx_thread.o(.text.svcRtxThreadFlagsWait) referenced from rtx_thread.o(.text.osThreadFlagsWait)
- svcRtxThreadGetId from rtx_thread.o(.text.svcRtxThreadGetId) referenced from rtx_thread.o(.text.osThreadGetId)
- svcRtxThreadNew from rtx_thread.o(.text.svcRtxThreadNew) referenced from rtx_thread.o(.text.osThreadNew)
- svcRtxThreadYield from rtx_thread.o(.text.svcRtxThreadYield) referenced from rtx_thread.o(.text.osThreadYield)
- svcRtxTimerNew from rtx_timer.o(.text.svcRtxTimerNew) referenced from rtx_timer.o(.text.osTimerNew)
- svcRtxTimerStart from rtx_timer.o(.text.svcRtxTimerStart) referenced from rtx_timer.o(.text.osTimerStart)
- svcRtxTimerStop from rtx_timer.o(.text.svcRtxTimerStop) referenced from rtx_timer.o(.text.osTimerStop)

### Global Symbols

__main (Thumb, 8 bytes, Stack size 0 bytes, __main.o(!!!main))

[Calls]

- >> __scatterload
- >> __rt_entry

__scatterload (Thumb, 0 bytes, Stack size unknown bytes, __scatter.o(!!!scatter))

[Called By]

- >> __main

__scatterload_rt2 (Thumb, 44 bytes, Stack size unknown bytes, __scatter.o(!!!scatter), UNUSED)

[Calls]

- >> __rt_entry

__scatterload_rt2_thumb_only (Thumb, 0 bytes, Stack size unknown bytes, __scatter.o(!!!scatter), UNUSED)

__scatterload_null (Thumb, 0 bytes, Stack size unknown bytes, __scatter.o(!!!scatter), UNUSED)

__decompress (Thumb, 90 bytes, Stack size unknown bytes, __dczerorl2.o(!!dczerorl2), UNUSED)

__decompress1 (Thumb, 0 bytes, Stack size unknown bytes, __dczerorl2.o(!!dczerorl2), UNUSED)

__scatterload_zeroinit (Thumb, 28 bytes, Stack size unknown bytes, __scatter_zi.o(!!handler_zi), UNUSED)

_printf_f (Thumb, 0 bytes, Stack size unknown bytes, _printf_f.o(.ARM.Collect$$_printf_percent$$00000003))

[Stack]

- Max Depth = 324 + Unknown Stack Size
- Call Chain = _printf_f ⇒ _printf_fp_dec ⇒ _printf_fp_dec_real ⇒ _fp_digits ⇒ _btod_etento ⇒ _btod_emul ⇒ _e2e

[Calls]

- >> _printf_fp_dec

_printf_percent (Thumb, 0 bytes, Stack size unknown bytes, _printf_percent.o(.ARM.Collect$$_printf_percent$$00000000))

[Called By]

- >> __printf

_printf_percent_end (Thumb, 0 bytes, Stack size unknown bytes, _printf_percent_end.o(.ARM.Collect$$_printf_percent$$00000017))

__rt_lib_init (Thumb, 0 bytes, Stack size unknown bytes, libinit.o(.ARM.Collect$$libinit$$00000000))

[Called By]

- >> __rt_entry_li

__rt_lib_init_fp_1 (Thumb, 0 bytes, Stack size unknown bytes, libinit2.o(.ARM.Collect$$libinit$$00000002))

__rt_lib_init_heap_2 (Thumb, 0 bytes, Stack size unknown bytes, libinit2.o(.ARM.Collect$$libinit$$00000005))

[Stack]

- Max Depth = 64 + Unknown Stack Size
- Call Chain = __rt_lib_init_heap_2 ⇒ _init_alloc ⇒ __rt_SIGRTMEM ⇒ __rt_SIGRTMEM_inner ⇒ __default_signal_display ⇒ _ttywrch

[Calls]

- >> _init_alloc

__rt_lib_init_preinit_1 (Thumb, 0 bytes, Stack size unknown bytes, libinit2.o(.ARM.Collect$$libinit$$00000004))

__rt_lib_init_heap_1 (Thumb, 0 bytes, Stack size unknown bytes, libinit2.o(.ARM.Collect$$libinit$$0000000A))

__rt_lib_init_lc_common (Thumb, 0 bytes, Stack size unknown bytes, libinit2.o(.ARM.Collect$$libinit$$0000000F))

[Stack]

- Max Depth = 8 + Unknown Stack Size
- Call Chain = __rt_lib_init_lc_common ⇒ __rt_locale

[Calls]

- >> __rt_locale

__rt_lib_init_rand_1 (Thumb, 0 bytes, Stack size unknown bytes, libinit2.o(.ARM.Collect$$libinit$$0000000E))

__rt_lib_init_user_alloc_1 (Thumb, 0 bytes, Stack size unknown bytes, libinit2.o(.ARM.Collect$$libinit$$0000000C))

__rt_lib_init_lc_collate_1 (Thumb, 0 bytes, Stack size unknown bytes, libinit2.o(.ARM.Collect$$libinit$$00000011))

__rt_lib_init_lc_ctype_1 (Thumb, 0 bytes, Stack size unknown bytes, libinit2.o(.ARM.Collect$$libinit$$00000013))

__rt_lib_init_lc_monetary_1 (Thumb, 0 bytes, Stack size unknown bytes, libinit2.o(.ARM.Collect$$libinit$$00000015))

__rt_lib_init_lc_numeric_2 (Thumb, 0 bytes, Stack size unknown bytes, libinit2.o(.ARM.Collect$$libinit$$00000016))

[Stack]

- Max Depth = 8 + Unknown Stack Size
- Call Chain = __rt_lib_init_lc_numeric_2 ⇒ _get_lc_numeric

[Calls]

- >> _get_lc_numeric

__rt_lib_init_atexit_1 (Thumb, 0 bytes, Stack size unknown bytes, libinit2.o(.ARM.Collect$$libinit$$0000001B))

__rt_lib_init_clock_1 (Thumb, 0 bytes, Stack size unknown bytes, libinit2.o(.ARM.Collect$$libinit$$00000021))

__rt_lib_init_fp_trap_1 (Thumb, 0 bytes, Stack size unknown bytes, libinit2.o(.ARM.Collect$$libinit$$0000001F))

__rt_lib_init_getenv_1 (Thumb, 0 bytes, Stack size unknown bytes, libinit2.o(.ARM.Collect$$libinit$$00000023))

__rt_lib_init_lc_numeric_1 (Thumb, 0 bytes, Stack size unknown bytes, libinit2.o(.ARM.Collect$$libinit$$00000017))

__rt_lib_init_lc_time_1 (Thumb, 0 bytes, Stack size unknown bytes, libinit2.o(.ARM.Collect$$libinit$$00000019))

__rt_lib_init_signal_1 (Thumb, 0 bytes, Stack size unknown bytes, libinit2.o(.ARM.Collect$$libinit$$0000001D))

__rt_lib_init_stdio_2 (Thumb, 0 bytes, Stack size unknown bytes, libinit2.o(.ARM.Collect$$libinit$$00000024))

[Stack]

- Max Depth = 172 + Unknown Stack Size
- Call Chain = __rt_lib_init_stdio_2 ⇒ _initio ⇒ freopen ⇒ _freopen_locked ⇒ _fclose_internal ⇒ _fflush ⇒ _writebuf ⇒ _sys_write ⇒ stdout_putchar

[Calls]

- >> _initio

__rt_lib_init_alloca_1 (Thumb, 0 bytes, Stack size unknown bytes, libinit2.o(.ARM.Collect$$libinit$$0000002E))

__rt_lib_init_argv_1 (Thumb, 0 bytes, Stack size unknown bytes, libinit2.o(.ARM.Collect$$libinit$$0000002C))

__rt_lib_init_cpp_1 (Thumb, 0 bytes, Stack size unknown bytes, libinit2.o(.ARM.Collect$$libinit$$00000032))

__rt_lib_init_exceptions_1 (Thumb, 0 bytes, Stack size unknown bytes, libinit2.o(.ARM.Collect$$libinit$$00000030))

__rt_lib_init_return (Thumb, 0 bytes, Stack size unknown bytes, libinit2.o(.ARM.Collect$$libinit$$00000033))

__rt_lib_init_stdio_1 (Thumb, 0 bytes, Stack size unknown bytes, libinit2.o(.ARM.Collect$$libinit$$00000025))

__rt_lib_shutdown (Thumb, 0 bytes, Stack size unknown bytes, libshutdown.o(.ARM.Collect$$libshutdown$$00000000))

[Called By]

- >> __rt_exit_ls

__rt_lib_shutdown_cpp_1 (Thumb, 0 bytes, Stack size unknown bytes, libshutdown2.o(.ARM.Collect$$libshutdown$$00000004))

__rt_lib_shutdown_fini_1 (Thumb, 0 bytes, Stack size unknown bytes, libshutdown2.o(.ARM.Collect$$libshutdown$$00000002))

__rt_lib_shutdown_stdio_2 (Thumb, 0 bytes, Stack size unknown bytes, libshutdown2.o(.ARM.Collect$$libshutdown$$00000005))

[Stack]

- Max Depth = 132 + Unknown Stack Size
- Call Chain = __rt_lib_shutdown_stdio_2 ⇒ _terminateio ⇒ _fclose_internal ⇒ _fflush ⇒ _writebuf ⇒ _sys_write ⇒ stdout_putchar

[Calls]

- >> _terminateio

__rt_lib_shutdown_fp_trap_1 (Thumb, 0 bytes, Stack size unknown bytes, libshutdown2.o(.ARM.Collect$$libshutdown$$00000009))

__rt_lib_shutdown_heap_2 (Thumb, 0 bytes, Stack size unknown bytes, libshutdown2.o(.ARM.Collect$$libshutdown$$0000000F))

[Stack]

- Max Depth = 24 + Unknown Stack Size
- Call Chain = __rt_lib_shutdown_heap_2 ⇒ _terminate_alloc ⇒ __Heap_Finalize ⇒ _mutex_free

[Calls]

- >> _terminate_alloc

__rt_lib_shutdown_signal_1 (Thumb, 0 bytes, Stack size unknown bytes, libshutdown2.o(.ARM.Collect$$libshutdown$$0000000C))

__rt_lib_shutdown_stdio_1 (Thumb, 0 bytes, Stack size unknown bytes, libshutdown2.o(.ARM.Collect$$libshutdown$$00000006))

__rt_lib_shutdown_user_alloc_1 (Thumb, 0 bytes, Stack size unknown bytes, libshutdown2.o(.ARM.Collect$$libshutdown$$0000000E))

__rt_lib_shutdown_heap_1 (Thumb, 0 bytes, Stack size unknown bytes, libshutdown2.o(.ARM.Collect$$libshutdown$$00000011))

__rt_lib_shutdown_return (Thumb, 0 bytes, Stack size unknown bytes, libshutdown2.o(.ARM.Collect$$libshutdown$$00000012))

__rt_entry (Thumb, 0 bytes, Stack size unknown bytes, __rtentry.o(.ARM.Collect$$rtentry$$00000000))

[Called By]

- >> __scatterload_rt2
- >> __main

__rt_entry_presh_1 (Thumb, 0 bytes, Stack size unknown bytes, __rtentry2.o(.ARM.Collect$$rtentry$$00000002))

__rt_entry_sh (Thumb, 0 bytes, Stack size unknown bytes, __rtentry4.o(.ARM.Collect$$rtentry$$00000004))

[Stack]

- Max Depth = 8 + Unknown Stack Size
- Call Chain = __rt_entry_sh ⇒ __user_setup_stackheap

[Calls]

- >> __user_setup_stackheap

__rt_entry_postsh_1 (Thumb, 0 bytes, Stack size unknown bytes, __rtentry2.o(.ARM.Collect$$rtentry$$00000008))

[Stack]

- Max Depth = 16 + Unknown Stack Size
- Call Chain = __rt_entry_postsh_1 ⇒ _platform_post_stackheap_init ⇒ osKernelInitialize

[Calls]

- >> _platform_post_stackheap_init

__rt_entry_li (Thumb, 0 bytes, Stack size unknown bytes, __rtentry2.o(.ARM.Collect$$rtentry$$0000000A))

[Calls]

- >> __rt_lib_init

__rt_entry_main (Thumb, 0 bytes, Stack size unknown bytes, __rtentry2.o(.ARM.Collect$$rtentry$$0000000D))

[Stack]

- Max Depth = 176 + Unknown Stack Size
- Call Chain = __rt_entry_main ⇒ main ⇒ SystemClock_Config ⇒ HAL_RCC_ClockConfig ⇒ HAL_RCC_GetSysClockFreq ⇒ __aeabi_uldivmod

[Calls]

- >> main
- >> exit

__rt_entry_postli_1 (Thumb, 0 bytes, Stack size unknown bytes, __rtentry2.o(.ARM.Collect$$rtentry$$0000000C))

__rt_exit (Thumb, 0 bytes, Stack size unknown bytes, rtexit.o(.ARM.Collect$$rtexit$$00000000))

[Called By]

- >> exit

__rt_exit_ls (Thumb, 0 bytes, Stack size unknown bytes, rtexit2.o(.ARM.Collect$$rtexit$$00000003))

[Calls]

- >> __rt_lib_shutdown

__rt_exit_prels_1 (Thumb, 0 bytes, Stack size unknown bytes, rtexit2.o(.ARM.Collect$$rtexit$$00000002))

__rt_exit_exit (Thumb, 0 bytes, Stack size unknown bytes, rtexit2.o(.ARM.Collect$$rtexit$$00000004))

[Calls]

- >> _sys_exit

Reset_Handler (Thumb, 8 bytes, Stack size 0 bytes, startup_stm32f429xx.o(.text))
[Address Reference Count : 1]

- startup_stm32f429xx.o(RESET)

_maybe_terminate_alloc (Thumb, 0 bytes, Stack size 0 bytes, maybetermalloc2.o(.emb_text), UNUSED)

ADC_IRQHandler (Thumb, 0 bytes, Stack size 0 bytes, startup_stm32f429xx.o(.text))

[Calls]

- >> ADC_IRQHandler

[Called By]

- >> ADC_IRQHandler

[Address Reference Count : 1]

- startup_stm32f429xx.o(RESET)

CAN1_RX0_IRQHandler (Thumb, 0 bytes, Stack size 0 bytes, startup_stm32f429xx.o(.text))
[Address Reference Count : 1]

- startup_stm32f429xx.o(RESET)

CAN1_RX1_IRQHandler (Thumb, 0 bytes, Stack size 0 bytes, startup_stm32f429xx.o(.text))
[Address Reference Count : 1]

- startup_stm32f429xx.o(RESET)

CAN1_SCE_IRQHandler (Thumb, 0 bytes, Stack size 0 bytes, startup_stm32f429xx.o(.text))
[Address Reference Count : 1]

- startup_stm32f429xx.o(RESET)

CAN1_TX_IRQHandler (Thumb, 0 bytes, Stack size 0 bytes, startup_stm32f429xx.o(.text))
[Address Reference Count : 1]

- startup_stm32f429xx.o(RESET)

CAN2_RX0_IRQHandler (Thumb, 0 bytes, Stack size 0 bytes, startup_stm32f429xx.o(.text))
[Address Reference Count : 1]

- startup_stm32f429xx.o(RESET)

CAN2_RX1_IRQHandler (Thumb, 0 bytes, Stack size 0 bytes, startup_stm32f429xx.o(.text))
[Address Reference Count : 1]

- startup_stm32f429xx.o(RESET)

CAN2_SCE_IRQHandler (Thumb, 0 bytes, Stack size 0 bytes, startup_stm32f429xx.o(.text))
[Address Reference Count : 1]

- startup_stm32f429xx.o(RESET)

CAN2_TX_IRQHandler (Thumb, 0 bytes, Stack size 0 bytes, startup_stm32f429xx.o(.text))
[Address Reference Count : 1]

- startup_stm32f429xx.o(RESET)

DCMI_IRQHandler (Thumb, 0 bytes, Stack size 0 bytes, startup_stm32f429xx.o(.text))
[Address Reference Count : 1]

- startup_stm32f429xx.o(RESET)

DMA1_Stream0_IRQHandler (Thumb, 0 bytes, Stack size 0 bytes, startup_stm32f429xx.o(.text))
[Address Reference Count : 1]

- startup_stm32f429xx.o(RESET)

DMA1_Stream1_IRQHandler (Thumb, 0 bytes, Stack size 0 bytes, startup_stm32f429xx.o(.text))
[Address Reference Count : 1]

- startup_stm32f429xx.o(RESET)

DMA1_Stream2_IRQHandler (Thumb, 0 bytes, Stack size 0 bytes, startup_stm32f429xx.o(.text))
[Address Reference Count : 1]

- startup_stm32f429xx.o(RESET)

DMA1_Stream3_IRQHandler (Thumb, 0 bytes, Stack size 0 bytes, startup_stm32f429xx.o(.text))
[Address Reference Count : 1]

- startup_stm32f429xx.o(RESET)

DMA1_Stream4_IRQHandler (Thumb, 0 bytes, Stack size 0 bytes, startup_stm32f429xx.o(.text))
[Address Reference Count : 1]

- startup_stm32f429xx.o(RESET)

DMA1_Stream5_IRQHandler (Thumb, 0 bytes, Stack size 0 bytes, startup_stm32f429xx.o(.text))
[Address Reference Count : 1]

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

- startup_stm32f429xx.o(RESET)

USART1_IRQHandler (Thumb, 0 bytes, Stack size 0 bytes, startup_stm32f429xx.o(.text))
[Address Reference Count : 1]

- startup_stm32f429xx.o(RESET)

USART2_IRQHandler (Thumb, 0 bytes, Stack size 0 bytes, startup_stm32f429xx.o(.text))
[Address Reference Count : 1]

- startup_stm32f429xx.o(RESET)

USART3_IRQHandler (Thumb, 0 bytes, Stack size 0 bytes, startup_stm32f429xx.o(.text))
[Address Reference Count : 1]

- startup_stm32f429xx.o(RESET)

USART6_IRQHandler (Thumb, 0 bytes, Stack size 0 bytes, startup_stm32f429xx.o(.text))
[Address Reference Count : 1]

- startup_stm32f429xx.o(RESET)

WWDG_IRQHandler (Thumb, 0 bytes, Stack size 0 bytes, startup_stm32f429xx.o(.text))
[Address Reference Count : 1]

- startup_stm32f429xx.o(RESET)

__user_initial_stackheap (Thumb, 0 bytes, Stack size unknown bytes, startup_stm32f429xx.o(.text))

[Called By]

- >> __user_setup_stackheap

SVC_Handler (Thumb, 108 bytes, Stack size unknown bytes, irq_armv7m.o(.text))
[Address Reference Count : 1]

- startup_stm32f429xx.o(RESET)

PendSV_Handler (Thumb, 16 bytes, Stack size unknown bytes, irq_armv7m.o(.text))

[Stack]

- Max Depth = 40 + Unknown Stack Size
- Call Chain = PendSV_Handler ⇒ osRtxPendSV_Handler ⇒ osRtxThreadDispatch ⇒ osRtxThreadReadyPut ⇒ osRtxThreadListPut

[Calls]

- >> osRtxPendSV_Handler

[Address Reference Count : 1]

- startup_stm32f429xx.o(RESET)

SysTick_Handler (Thumb, 16 bytes, Stack size unknown bytes, irq_armv7m.o(.text))

[Stack]

- Max Depth = 72 + Unknown Stack Size
- Call Chain = SysTick_Handler ⇒ osRtxTick_Handler ⇒ osRtxThreadDelayTick ⇒ osRtxMutexOwnerRestore ⇒ osRtxThreadListSort ⇒ osRtxThreadListPut

[Calls]

- >> osRtxTick_Handler

[Address Reference Count : 2]

- rtx_kernel.o(.text.svcRtxKernelStart)
- startup_stm32f429xx.o(RESET)

__aeabi_uldivmod (Thumb, 0 bytes, Stack size 48 bytes, lludivv7m.o(.text))

[Stack]

- Max Depth = 48
- Call Chain = __aeabi_uldivmod

[Called By]

- >> HAL_RCC_GetSysClockFreq

_ll_udiv (Thumb, 238 bytes, Stack size 48 bytes, lludivv7m.o(.text), UNUSED)

__2printf (Thumb, 20 bytes, Stack size 24 bytes, noretval__2printf.o(.text))

[Stack]

- Max Depth = 144 + Unknown Stack Size
- Call Chain = __2printf ⇒ _printf_char_file ⇒ _printf_char_common ⇒ __printf

[Calls]

- >> _printf_char_file

[Called By]

- >> Init_servo_Timer_periodic
- >> Thread
- >> I2C_SignalEvent_TEMP_HUM
- >> Config_Communication

__printf (Thumb, 270 bytes, Stack size 32 bytes, __printf_wp.o(.text))

[Stack]

- Max Depth = 32 + Unknown Stack Size
- Call Chain = __printf

[Calls]

- >> _printf_percent
- >> _is_digit

[Called By]

- >> _printf_char_common

__aeabi_memcpy (Thumb, 0 bytes, Stack size 0 bytes, rt_memcpy_v6.o(.text))

[Called By]

- >> osMessageQueueGet
- >> osMessageQueuePut
- >> svcRtxMessageQueuePut
- >> svcRtxMessageQueueGet
- >> osRtxMessageQueuePostProcess

__rt_memcpy (Thumb, 138 bytes, Stack size 0 bytes, rt_memcpy_v6.o(.text), UNUSED)

[Calls]

- >> __aeabi_memcpy4

_memcpy_lastbytes (Thumb, 0 bytes, Stack size unknown bytes, rt_memcpy_v6.o(.text), UNUSED)

__aeabi_memclr (Thumb, 0 bytes, Stack size 0 bytes, rt_memclr.o(.text))

[Called By]

- >> svcRtxMessageQueueNew

__rt_memclr (Thumb, 68 bytes, Stack size 0 bytes, rt_memclr.o(.text), UNUSED)

[Calls]

- >> _memset_w

_memset (Thumb, 0 bytes, Stack size unknown bytes, rt_memclr.o(.text), UNUSED)

__aeabi_memclr4 (Thumb, 0 bytes, Stack size 4 bytes, rt_memclr_w.o(.text))

[Stack]

- Max Depth = 4
- Call Chain = __aeabi_memclr4

[Called By]

- >> I2C_Initialize
- >> _fopen$locked
- >> _fclose_internal
- >> _initio
- >> svcRtxMutexNew
- >> svcRtxThreadNew

__aeabi_memclr8 (Thumb, 0 bytes, Stack size 4 bytes, rt_memclr_w.o(.text), UNUSED)

__rt_memclr_w (Thumb, 78 bytes, Stack size 4 bytes, rt_memclr_w.o(.text), UNUSED)

_memset_w (Thumb, 0 bytes, Stack size unknown bytes, rt_memclr_w.o(.text), UNUSED)

[Called By]

- >> __rt_memclr

strcmp (Thumb, 128 bytes, Stack size 0 bytes, strcmpv7m.o(.text))

[Called By]

- >> _sys_open
- >> _get_lc_numeric

__use_two_region_memory (Thumb, 2 bytes, Stack size 0 bytes, heapauxi.o(.text), UNUSED)

__rt_heap_escrow (Thumb, 2 bytes, Stack size 0 bytes, heapauxi.o(.text), UNUSED)

__rt_heap_expand (Thumb, 2 bytes, Stack size 0 bytes, heapauxi.o(.text), UNUSED)

__lib_sel_fp_printf (Thumb, 2 bytes, Stack size 0 bytes, _printf_fp_dec.o(.text), UNUSED)

_printf_fp_dec_real (Thumb, 620 bytes, Stack size 104 bytes, _printf_fp_dec.o(.text))

[Stack]

- Max Depth = 324
- Call Chain = _printf_fp_dec_real ⇒ _fp_digits ⇒ _btod_etento ⇒ _btod_emul ⇒ _e2e

[Calls]

- >> __ARM_fpclassify
- >> _printf_fp_infnan
- >> __rt_locale
- >> _fp_digits

[Called By]

- >> _printf_fp_dec

__aeabi_memcpy4 (Thumb, 0 bytes, Stack size 8 bytes, rt_memcpy_w.o(.text), UNUSED)

[Called By]

- >> __rt_memcpy

__aeabi_memcpy8 (Thumb, 0 bytes, Stack size 8 bytes, rt_memcpy_w.o(.text), UNUSED)

__rt_memcpy_w (Thumb, 100 bytes, Stack size 8 bytes, rt_memcpy_w.o(.text), UNUSED)

_memcpy_lastbytes_aligned (Thumb, 0 bytes, Stack size unknown bytes, rt_memcpy_w.o(.text), UNUSED)

__rt_locale (Thumb, 10 bytes, Stack size 8 bytes, rt_locale_twolibspace.o(.text))

[Stack]

- Max Depth = 8
- Call Chain = __rt_locale

[Calls]

- >> __user_perproc_libspace

[Called By]

- >> __rt_lib_init_lc_common
- >> _printf_fp_dec_real

_ll_udiv10 (Thumb, 138 bytes, Stack size 12 bytes, lludiv10.o(.text))

[Stack]

- Max Depth = 12
- Call Chain = _ll_udiv10

[Called By]

- >> _fp_digits

_printf_char_common (Thumb, 32 bytes, Stack size 64 bytes, _printf_char_common.o(.text))

[Stack]

- Max Depth = 96 + Unknown Stack Size
- Call Chain = _printf_char_common ⇒ __printf

[Calls]

- >> __printf

[Called By]

- >> _printf_char_file

_printf_fp_infnan (Thumb, 112 bytes, Stack size 24 bytes, _printf_fp_infnan.o(.text))

[Stack]

- Max Depth = 24
- Call Chain = _printf_fp_infnan

[Called By]

- >> _printf_fp_dec_real

_btod_etento (Thumb, 224 bytes, Stack size 72 bytes, bigflt0.o(.text))

[Stack]

- Max Depth = 124
- Call Chain = _btod_etento ⇒ _btod_emul ⇒ _e2e

[Calls]

- >> _btod_emul
- >> _btod_ediv

[Called By]

- >> _fp_digits

_initio (Thumb, 240 bytes, Stack size 8 bytes, initio_locked.o(.text))

[Stack]

- Max Depth = 172
- Call Chain = _initio ⇒ freopen ⇒ _freopen_locked ⇒ _fclose_internal ⇒ _fflush ⇒ _writebuf ⇒ _sys_write ⇒ stdout_putchar

[Calls]

- >> _mutex_initialize
- >> __rt_SIGRTRED
- >> freopen
- >> setvbuf
- >> __aeabi_memclr4

[Called By]

- >> __rt_lib_init_stdio_2

_terminateio (Thumb, 168 bytes, Stack size 24 bytes, initio_locked.o(.text))

[Stack]

- Max Depth = 132
- Call Chain = _terminateio ⇒ _fclose_internal ⇒ _fflush ⇒ _writebuf ⇒ _sys_write ⇒ stdout_putchar

[Calls]

- >> _mutex_release
- >> _mutex_free
- >> _mutex_acquire
- >> _fclose_internal
- >> free

[Called By]

- >> __rt_lib_shutdown_stdio_2

__user_libspace (Thumb, 8 bytes, Stack size 0 bytes, libspace.o(.text), UNUSED)

__user_perproc_libspace (Thumb, 0 bytes, Stack size 0 bytes, libspace.o(.text))

[Called By]

- >> __rt_heap_descriptor
- >> __user_setup_stackheap
- >> __rt_locale

__user_setup_stackheap (Thumb, 74 bytes, Stack size 8 bytes, sys_stackheap_outer.o(.text))

[Stack]

- Max Depth = 8 + Unknown Stack Size
- Call Chain = __user_setup_stackheap

[Calls]

- >> __user_perproc_libspace
- >> __user_initial_stackheap

[Called By]

- >> __rt_entry_sh

_free_internal (Thumb, 98 bytes, Stack size 16 bytes, h1_free_mt.o(.text))

[Stack]

- Max Depth = 32
- Call Chain = _free_internal ⇒ _mutex_release ⇒ os_kernel_is_active

[Calls]

- >> _mutex_release
- >> _mutex_acquire

[Called By]

- >> __Heap_ProvideMemory
- >> free

free (Thumb, 20 bytes, Stack size 8 bytes, h1_free_mt.o(.text))

[Stack]

- Max Depth = 40
- Call Chain = free ⇒ _free_internal ⇒ _mutex_release ⇒ os_kernel_is_active

[Calls]

- >> __rt_heap_descriptor
- >> _free_internal

[Called By]

- >> _fclose_internal
- >> _terminateio

__flsbuf (Thumb, 470 bytes, Stack size 32 bytes, flsbuf.o(.text), UNUSED)

[Calls]

- >> _sys_istty
- >> _sys_flen
- >> _deferredlazyseek
- >> _writebuf
- >> _seterr
- >> malloc

__flsbuf_byte (Thumb, 0 bytes, Stack size 32 bytes, flsbuf.o(.text))

[Stack]

- Max Depth = 32
- Call Chain = __flsbuf_byte

[Called By]

- >> _fputc$unlocked

__flsbuf_wide (Thumb, 0 bytes, Stack size 32 bytes, flsbuf.o(.text), UNUSED)

_fclose_internal (Thumb, 76 bytes, Stack size 32 bytes, fclose.o(.text))

[Stack]

- Max Depth = 108
- Call Chain = _fclose_internal ⇒ _fflush ⇒ _writebuf ⇒ _sys_write ⇒ stdout_putchar

[Calls]

- >> _sys_close
- >> _fflush
- >> free
- >> __aeabi_memclr4

[Called By]

- >> _freopen_locked
- >> _terminateio

fclose (Thumb, 0 bytes, Stack size 32 bytes, fclose.o(.text), UNUSED)

setvbuf (Thumb, 104 bytes, Stack size 32 bytes, setvbuf_locked.o(.text))

[Stack]

- Max Depth = 48
- Call Chain = setvbuf ⇒ _mutex_release ⇒ os_kernel_is_active

[Calls]

- >> _mutex_release
- >> _mutex_acquire

[Called By]

- >> _initio

freopen (Thumb, 42 bytes, Stack size 24 bytes, fopen_locked.o(.text))

[Stack]

- Max Depth = 164
- Call Chain = freopen ⇒ _freopen_locked ⇒ _fclose_internal ⇒ _fflush ⇒ _writebuf ⇒ _sys_write ⇒ stdout_putchar

[Calls]

- >> _mutex_release
- >> _mutex_acquire
- >> _freopen_locked

[Called By]

- >> _initio

_fopen$locked (Thumb, 100 bytes, Stack size 24 bytes, fopen_locked.o(.text), UNUSED)

[Calls]

- >> _mutex_release
- >> _mutex_initialize
- >> _mutex_acquire
- >> malloc
- >> _freopen_locked
- >> __aeabi_memclr4

exit (Thumb, 18 bytes, Stack size 8 bytes, exit.o(.text))

[Stack]

- Max Depth = 8 + Unknown Stack Size
- Call Chain = exit

[Calls]

- >> __rt_exit

[Called By]

- >> __rt_entry_main

__rt_SIGRTRED (Thumb, 14 bytes, Stack size 8 bytes, defsig_rtred_outer.o(.text))

[Stack]

- Max Depth = 40
- Call Chain = __rt_SIGRTRED ⇒ __rt_SIGRTRED_inner ⇒ __default_signal_display ⇒ _ttywrch

[Calls]

- >> __rt_SIGRTRED_inner
- >> __sig_exit

[Called By]

- >> _initio

__rt_heap_descriptor (Thumb, 10 bytes, Stack size 8 bytes, rt_heap_descriptor_twolibspace.o(.text))

[Stack]

- Max Depth = 8
- Call Chain = __rt_heap_descriptor

[Calls]

- >> __user_perproc_libspace

[Called By]

- >> _terminate_alloc
- >> malloc
- >> _init_alloc
- >> free

__use_no_heap (Thumb, 2 bytes, Stack size 0 bytes, hguard.o(.text), UNUSED)

__heap$guard (Thumb, 2 bytes, Stack size 0 bytes, hguard.o(.text), UNUSED)

_terminate_user_alloc (Thumb, 2 bytes, Stack size 0 bytes, init_alloc.o(.text), UNUSED)

_init_user_alloc (Thumb, 2 bytes, Stack size 0 bytes, init_alloc.o(.text), UNUSED)

__Heap_Full (Thumb, 34 bytes, Stack size 16 bytes, init_alloc.o(.text), UNUSED)

[Calls]

- >> __Heap_ProvideMemory

[Called By]

- >> _malloc_internal

__Heap_Broken (Thumb, 6 bytes, Stack size 0 bytes, init_alloc.o(.text), UNUSED)

[Calls]

- >> __rt_SIGRTMEM

_init_alloc (Thumb, 94 bytes, Stack size 24 bytes, init_alloc.o(.text))

[Stack]

- Max Depth = 64
- Call Chain = _init_alloc ⇒ __rt_SIGRTMEM ⇒ __rt_SIGRTMEM_inner ⇒ __default_signal_display ⇒ _ttywrch

[Calls]

- >> __rt_SIGRTMEM
- >> __Heap_ProvideMemory
- >> __Heap_Initialize
- >> __rt_heap_descriptor

[Called By]

- >> __rt_lib_init_heap_2

_malloc_internal (Thumb, 130 bytes, Stack size 24 bytes, h1_alloc_mt.o(.text), UNUSED)

[Calls]

- >> _mutex_release
- >> _mutex_acquire
- >> Heap1_SizeAdjust
- >> __Heap_Full

[Called By]

- >> malloc

malloc (Thumb, 20 bytes, Stack size 8 bytes, h1_alloc_mt.o(.text), UNUSED)

[Calls]

- >> _malloc_internal
- >> __rt_heap_descriptor

[Called By]

- >> _fopen$locked
- >> __flsbuf

_printf_char_file (Thumb, 58 bytes, Stack size 24 bytes, _printf_char_file_locked.o(.text))

[Stack]

- Max Depth = 120 + Unknown Stack Size
- Call Chain = _printf_char_file ⇒ _printf_char_common ⇒ __printf

[Calls]

- >> _mutex_release
- >> _mutex_acquire
- >> _printf_char_common

[Called By]

- >> __2printf

_fseek (Thumb, 242 bytes, Stack size 24 bytes, fseek.o(.text))

[Stack]

- Max Depth = 56
- Call Chain = _fseek ⇒ _ftell_internal ⇒ __aeabi_errno_addr ⇒ __user_perthread_libspace ⇒ os_kernel_is_active

[Calls]

- >> _sys_istty
- >> _sys_flen
- >> _ftell_internal
- >> _seterr

[Called By]

- >> _freopen_locked

fseek (Thumb, 0 bytes, Stack size 24 bytes, fseek.o(.text), UNUSED)

_seterr (Thumb, 20 bytes, Stack size 0 bytes, stdio.o(.text))

[Called By]

- >> _writebuf
- >> _fseek
- >> __flsbuf

_writebuf (Thumb, 84 bytes, Stack size 32 bytes, stdio.o(.text))

[Stack]

- Max Depth = 60
- Call Chain = _writebuf ⇒ _sys_write ⇒ stdout_putchar

[Calls]

- >> _sys_write
- >> _sys_seek
- >> _seterr

[Called By]

- >> _fflush
- >> __flsbuf

_fflush (Thumb, 70 bytes, Stack size 16 bytes, stdio.o(.text))

[Stack]

- Max Depth = 76
- Call Chain = _fflush ⇒ _writebuf ⇒ _sys_write ⇒ stdout_putchar

[Calls]

- >> _writebuf

[Called By]

- >> _deferredlazyseek
- >> _fclose_internal

_deferredlazyseek (Thumb, 60 bytes, Stack size 8 bytes, stdio.o(.text), UNUSED)

[Calls]

- >> _fflush

[Called By]

- >> __flsbuf

__sig_exit (Thumb, 10 bytes, Stack size 0 bytes, defsig_exit.o(.text))

[Calls]

- >> _sys_exit

[Called By]

- >> __rt_SIGRTMEM
- >> __rt_SIGRTRED

__rt_SIGRTRED_inner (Thumb, 14 bytes, Stack size 8 bytes, defsig_rtred_inner.o(.text))

[Stack]

- Max Depth = 32
- Call Chain = __rt_SIGRTRED_inner ⇒ __default_signal_display ⇒ _ttywrch

[Calls]

- >> __default_signal_display

[Called By]

- >> __rt_SIGRTRED

_sys_exit (Thumb, 8 bytes, Stack size 0 bytes, sys_exit.o(.text))

[Called By]

- >> __rt_exit_exit
- >> __sig_exit

__Heap_Initialize (Thumb, 14 bytes, Stack size 0 bytes, h1_init_mt.o(.text))

[Stack]

- Max Depth = 16
- Call Chain = __Heap_Initialize ⇒ _mutex_initialize

[Calls]

- >> _mutex_initialize

[Called By]

- >> _init_alloc

__Heap_DescSize (Thumb, 4 bytes, Stack size 0 bytes, h1_init_mt.o(.text), UNUSED)

__Heap_ProvideMemory (Thumb, 62 bytes, Stack size 8 bytes, h1_extend_mt.o(.text))

[Stack]

- Max Depth = 40
- Call Chain = __Heap_ProvideMemory ⇒ _free_internal ⇒ _mutex_release ⇒ os_kernel_is_active

[Calls]

- >> _free_internal

[Called By]

- >> _init_alloc
- >> __Heap_Full

_ftell_internal (Thumb, 66 bytes, Stack size 8 bytes, ftell.o(.text))

[Stack]

- Max Depth = 32
- Call Chain = _ftell_internal ⇒ __aeabi_errno_addr ⇒ __user_perthread_libspace ⇒ os_kernel_is_active

[Calls]

- >> __aeabi_errno_addr

[Called By]

- >> _fseek

ftell (Thumb, 0 bytes, Stack size 8 bytes, ftell.o(.text), UNUSED)

__default_signal_display (Thumb, 50 bytes, Stack size 16 bytes, defsig_general.o(.text))

[Stack]

- Max Depth = 24
- Call Chain = __default_signal_display ⇒ _ttywrch

[Calls]

- >> _ttywrch

[Called By]

- >> __rt_SIGRTMEM_inner
- >> __rt_SIGRTRED_inner

__rt_SIGRTMEM (Thumb, 14 bytes, Stack size 8 bytes, defsig_rtmem_outer.o(.text))

[Stack]

- Max Depth = 40
- Call Chain = __rt_SIGRTMEM ⇒ __rt_SIGRTMEM_inner ⇒ __default_signal_display ⇒ _ttywrch

[Calls]

- >> __rt_SIGRTMEM_inner
- >> __sig_exit

[Called By]

- >> _init_alloc
- >> __Heap_Broken

_ttywrch (Thumb, 14 bytes, Stack size 8 bytes, sys_wrch.o(.text))

[Stack]

- Max Depth = 8
- Call Chain = _ttywrch

[Called By]

- >> __default_signal_display

__I$use$semihosting (Thumb, 0 bytes, Stack size 0 bytes, use_no_semi.o(.text), UNUSED)

__use_no_semihosting_swi (Thumb, 2 bytes, Stack size 0 bytes, use_no_semi.o(.text), UNUSED)

__aeabi_errno_addr (Thumb, 4 bytes, Stack size 0 bytes, rt_errno_addr_twolibspace.o(.text))

[Stack]

- Max Depth = 24
- Call Chain = __aeabi_errno_addr ⇒ __user_perthread_libspace ⇒ os_kernel_is_active

[Calls]

- >> __user_perthread_libspace

[Called By]

- >> _ftell_internal

__errno$twolibspace (Thumb, 0 bytes, Stack size 0 bytes, rt_errno_addr_twolibspace.o(.text), UNUSED)

__rt_errno_addr$twolibspace (Thumb, 0 bytes, Stack size 0 bytes, rt_errno_addr_twolibspace.o(.text), UNUSED)

__semihosting_library_function (Thumb, 0 bytes, Stack size 0 bytes, indicate_semi.o(.text), UNUSED)

_terminate_alloc (Thumb, 16 bytes, Stack size 8 bytes, term_alloc.o(.text))

[Stack]

- Max Depth = 24
- Call Chain = _terminate_alloc ⇒ __Heap_Finalize ⇒ _mutex_free

[Calls]

- >> __Heap_Finalize
- >> __rt_heap_descriptor

[Called By]

- >> __rt_lib_shutdown_heap_2

__rt_SIGRTMEM_inner (Thumb, 22 bytes, Stack size 8 bytes, defsig_rtmem_inner.o(.text))

[Stack]

- Max Depth = 32
- Call Chain = __rt_SIGRTMEM_inner ⇒ __default_signal_display ⇒ _ttywrch

[Calls]

- >> __default_signal_display

[Called By]

- >> __rt_SIGRTMEM

__Heap_Finalize (Thumb, 10 bytes, Stack size 8 bytes, h1_final_mt.o(.text))

[Stack]

- Max Depth = 16
- Call Chain = __Heap_Finalize ⇒ _mutex_free

[Calls]

- >> _mutex_free

[Called By]

- >> _terminate_alloc

OS_Tick_AcknowledgeIRQ (Thumb, 8 bytes, Stack size 0 bytes, os_systick.o(.text.OS_Tick_AcknowledgeIRQ))

[Called By]

- >> osRtxTick_Handler

OS_Tick_Enable (Thumb, 32 bytes, Stack size 0 bytes, os_systick.o(.text.OS_Tick_Enable))

[Called By]

- >> svcRtxKernelStart

OS_Tick_GetIRQn (Thumb, 6 bytes, Stack size 0 bytes, os_systick.o(.text.OS_Tick_GetIRQn))

[Called By]

- >> svcRtxKernelStart

OS_Tick_Setup (Thumb, 48 bytes, Stack size 0 bytes, os_systick.o(.text.OS_Tick_Setup))

[Called By]

- >> svcRtxKernelStart

osDelay (Thumb, 32 bytes, Stack size 0 bytes, rtx_delay.o(.text.osDelay))

[Called By]

- >> ThTemp_Hum

osKernelGetState (Thumb, 40 bytes, Stack size 0 bytes, rtx_kernel.o(.text.osKernelGetState))

[Called By]

- >> os_kernel_is_active
- >> HAL_GetTick

osKernelGetTickCount (Thumb, 32 bytes, Stack size 0 bytes, rtx_kernel.o(.text.osKernelGetTickCount))

[Called By]

- >> HAL_GetTick

osKernelInitialize (Thumb, 40 bytes, Stack size 8 bytes, rtx_kernel.o(.text.osKernelInitialize))

[Stack]

- Max Depth = 8
- Call Chain = osKernelInitialize

[Calls]

- >> osRtxKernelPreInit

[Called By]

- >> _platform_post_stackheap_init
- >> main

osKernelStart (Thumb, 32 bytes, Stack size 0 bytes, rtx_kernel.o(.text.osKernelStart))

[Calls]

- >> OUTLINED_FUNCTION_1

[Called By]

- >> main

osMessageQueueGet (Thumb, 108 bytes, Stack size 24 bytes, rtx_msgqueue.o(.text.osMessageQueueGet))

[Stack]

- Max Depth = 40
- Call Chain = osMessageQueueGet ⇒ osRtxPostProcess

[Calls]

- >> __aeabi_memcpy
- >> MessageQueueGet
- >> osRtxPostProcess

[Called By]

- >> osRtxTimerThread
- >> ThTermostato
- >> Thread

osMessageQueueGetCount (Thumb, 44 bytes, Stack size 0 bytes, rtx_msgqueue.o(.text.osMessageQueueGetCount))

[Called By]

- >> Thread

osMessageQueueNew (Thumb, 32 bytes, Stack size 0 bytes, rtx_msgqueue.o(.text.osMessageQueueNew))

[Called By]

- >> Init_Ventilador_MsgTemp_Hum
- >> Init_MsgTemp_Hum

osMessageQueuePut (Thumb, 124 bytes, Stack size 24 bytes, rtx_msgqueue.o(.text.osMessageQueuePut))

[Stack]

- Max Depth = 40
- Call Chain = osMessageQueuePut ⇒ osRtxPostProcess

[Calls]

- >> __aeabi_memcpy
- >> osRtxPostProcess
- >> osRtxMemoryPoolAlloc

[Called By]

- >> Thread
- >> ThTemp_Hum
- >> osRtxTimerTick

osMutexAcquire (Thumb, 32 bytes, Stack size 0 bytes, rtx_mutex.o(.text.osMutexAcquire))

[Called By]

- >> _mutex_acquire

osMutexDelete (Thumb, 32 bytes, Stack size 0 bytes, rtx_mutex.o(.text.osMutexDelete))

[Called By]

- >> _mutex_free

osMutexNew (Thumb, 32 bytes, Stack size 0 bytes, rtx_mutex.o(.text.osMutexNew))

[Called By]

- >> _mutex_initialize

osMutexRelease (Thumb, 32 bytes, Stack size 0 bytes, rtx_mutex.o(.text.osMutexRelease))

[Called By]

- >> _mutex_release

osRtxKernelErrorNotify (Thumb, 4 bytes, Stack size 0 bytes, rtx_kernel.o(.text.osRtxKernelErrorNotify))

[Calls]

- >> osRtxErrorNotify

[Called By]

- >> _mutex_initialize
- >> __user_perthread_libspace
- >> osRtxTimerTick
- >> osRtxPostProcess

osRtxKernelPreInit (Thumb, 2 bytes, Stack size 0 bytes, rtx_kernel.o(.text.osRtxKernelPreInit))

[Called By]

- >> osKernelInitialize

osRtxMemoryAlloc (Thumb, 108 bytes, Stack size 20 bytes, rtx_memory.o(.text.osRtxMemoryAlloc))

[Stack]

- Max Depth = 20
- Call Chain = osRtxMemoryAlloc

[Called By]

- >> svcRtxMessageQueueNew
- >> svcRtxMutexNew
- >> svcRtxTimerNew
- >> svcRtxThreadNew

osRtxMemoryFree (Thumb, 66 bytes, Stack size 16 bytes, rtx_memory.o(.text.osRtxMemoryFree))

[Stack]

- Max Depth = 16
- Call Chain = osRtxMemoryFree

[Called By]

- >> svcRtxMessageQueueNew
- >> svcRtxMutexDelete
- >> svcRtxThreadNew
- >> osRtxThreadFree

osRtxMemoryInit (Thumb, 54 bytes, Stack size 8 bytes, rtx_memory.o(.text.osRtxMemoryInit))

[Stack]

- Max Depth = 8
- Call Chain = osRtxMemoryInit

[Called By]

- >> svcRtxKernelInitialize

[Address Reference Count : 1]

- rtx_kernel.o(.text.svcRtxKernelInitialize)

osRtxMemoryPoolAlloc (Thumb, 58 bytes, Stack size 8 bytes, rtx_mempool.o(.text.osRtxMemoryPoolAlloc))

[Stack]

- Max Depth = 8
- Call Chain = osRtxMemoryPoolAlloc

[Called By]

- >> osMessageQueuePut
- >> svcRtxMessageQueuePut
- >> svcRtxMessageQueueNew
- >> svcRtxMessageQueueGet
- >> osRtxMessageQueuePostProcess
- >> svcRtxMutexNew
- >> svcRtxTimerNew
- >> svcRtxThreadNew

osRtxMemoryPoolFree (Thumb, 74 bytes, Stack size 16 bytes, rtx_mempool.o(.text.osRtxMemoryPoolFree))

[Stack]

- Max Depth = 16
- Call Chain = osRtxMemoryPoolFree

[Called By]

- >> svcRtxMessageQueueNew
- >> svcRtxMessageQueueGet
- >> osRtxMessageQueuePostProcess
- >> svcRtxMutexDelete
- >> svcRtxThreadNew
- >> osRtxThreadFree

osRtxMemoryPoolInit (Thumb, 56 bytes, Stack size 16 bytes, rtx_mempool.o(.text.osRtxMemoryPoolInit))

[Stack]

- Max Depth = 16
- Call Chain = osRtxMemoryPoolInit

[Called By]

- >> svcRtxMessageQueueNew
- >> OUTLINED_FUNCTION_0

osRtxMessageQueueTimerSetup (Thumb, 32 bytes, Stack size 8 bytes, rtx_msgqueue.o(.text.osRtxMessageQueueTimerSetup))

[Stack]

- Max Depth = 68
- Call Chain = osRtxMessageQueueTimerSetup ⇒ svcRtxMessageQueueNew ⇒ osRtxMemoryAlloc

[Calls]

- >> svcRtxMessageQueueNew

[Called By]

- >> osRtxTimerSetup

osRtxMutexOwnerRelease (Thumb, 72 bytes, Stack size 24 bytes, rtx_mutex.o(.text.osRtxMutexOwnerRelease))

[Stack]

- Max Depth = 64
- Call Chain = osRtxMutexOwnerRelease ⇒ osRtxThreadWaitExit ⇒ osRtxThreadDispatch ⇒ osRtxThreadReadyPut ⇒ osRtxThreadListPut

[Calls]

- >> osRtxThreadWaitExit
- >> osRtxThreadListGet

[Called By]

- >> svcRtxThreadExit

osRtxMutexOwnerRestore (Thumb, 66 bytes, Stack size 16 bytes, rtx_mutex.o(.text.osRtxMutexOwnerRestore))

[Stack]

- Max Depth = 40
- Call Chain = osRtxMutexOwnerRestore ⇒ osRtxThreadListSort ⇒ osRtxThreadListPut

[Calls]

- >> osRtxThreadListSort

[Called By]

- >> osRtxThreadDelayTick

osRtxPendSV_Handler (Thumb, 136 bytes, Stack size 16 bytes, rtx_system.o(.text.osRtxPendSV_Handler))

[Stack]

- Max Depth = 40
- Call Chain = osRtxPendSV_Handler ⇒ osRtxThreadDispatch ⇒ osRtxThreadReadyPut ⇒ osRtxThreadListPut

[Calls]

- >> osRtxThreadDispatch

[Called By]

- >> PendSV_Handler

osRtxPostProcess (Thumb, 108 bytes, Stack size 16 bytes, rtx_system.o(.text.osRtxPostProcess))

[Stack]

- Max Depth = 16
- Call Chain = osRtxPostProcess

[Calls]

- >> osRtxKernelErrorNotify

[Called By]

- >> osMessageQueueGet
- >> osThreadFlagsSet
- >> osMessageQueuePut

osRtxThreadDelayTick (Thumb, 72 bytes, Stack size 16 bytes, rtx_thread.o(.text.osRtxThreadDelayTick))

[Stack]

- Max Depth = 56
- Call Chain = osRtxThreadDelayTick ⇒ osRtxMutexOwnerRestore ⇒ osRtxThreadListSort ⇒ osRtxThreadListPut

[Calls]

- >> osRtxThreadReadyPut
- >> osRtxThreadListRemove
- >> osRtxMutexOwnerRestore
- >> osRtxThreadListRoot

[Called By]

- >> osRtxTick_Handler

osRtxThreadDispatch (Thumb, 80 bytes, Stack size 16 bytes, rtx_thread.o(.text.osRtxThreadDispatch))

[Stack]

- Max Depth = 24
- Call Chain = osRtxThreadDispatch ⇒ osRtxThreadReadyPut ⇒ osRtxThreadListPut

[Calls]

- >> osRtxThreadReadyPut
- >> osRtxThreadListRemove
- >> osRtxThreadBlock

[Called By]

- >> osRtxTick_Handler
- >> osRtxPendSV_Handler
- >> svcRtxMutexRelease
- >> svcRtxMutexDelete
- >> osRtxThreadWaitExit
- >> svcRtxThreadNew

osRtxThreadListGet (Thumb, 18 bytes, Stack size 0 bytes, rtx_thread.o(.text.osRtxThreadListGet))

[Called By]

- >> svcRtxMessageQueuePut
- >> svcRtxMessageQueueGet
- >> osRtxMessageQueuePostProcess
- >> svcRtxMutexRelease
- >> svcRtxMutexDelete
- >> osRtxMutexOwnerRelease
- >> svcRtxKernelStart

osRtxThreadListPut (Thumb, 44 bytes, Stack size 8 bytes, rtx_thread.o(.text.osRtxThreadListPut))

[Stack]

- Max Depth = 8
- Call Chain = osRtxThreadListPut

[Called By]

- >> svcRtxMessageQueuePut
- >> svcRtxMessageQueueGet
- >> svcRtxMutexAcquire
- >> osRtxThreadReadyPut
- >> osRtxThreadListSort

osRtxThreadListRemove (Thumb, 20 bytes, Stack size 0 bytes, rtx_thread.o(.text.osRtxThreadListRemove))

[Called By]

- >> osRtxTick_Handler
- >> osRtxThreadListSort
- >> svcRtxThreadYield
- >> osRtxThreadDispatch
- >> osRtxThreadDelayTick

osRtxThreadListSort (Thumb, 38 bytes, Stack size 16 bytes, rtx_thread.o(.text.osRtxThreadListSort))

[Stack]

- Max Depth = 24
- Call Chain = osRtxThreadListSort ⇒ osRtxThreadListPut

[Calls]

- >> osRtxThreadListRemove
- >> osRtxThreadListPut

[Called By]

- >> svcRtxMutexDelete
- >> svcRtxMutexAcquire
- >> osRtxMutexOwnerRestore

osRtxThreadReadyPut (Thumb, 16 bytes, Stack size 0 bytes, rtx_thread.o(.text.osRtxThreadReadyPut))

[Stack]

- Max Depth = 8
- Call Chain = osRtxThreadReadyPut ⇒ osRtxThreadListPut

[Calls]

- >> osRtxThreadListPut

[Called By]

- >> osRtxTick_Handler
- >> osRtxThreadWaitExit
- >> svcRtxThreadYield
- >> osRtxThreadDispatch
- >> osRtxThreadDelayTick

osRtxThreadRegPtr (Thumb, 6 bytes, Stack size 0 bytes, rtx_thread.o(.text.osRtxThreadRegPtr))

[Called By]

- >> svcRtxMessageQueuePut
- >> svcRtxMessageQueueGet
- >> osRtxMessageQueuePostProcess

osRtxThreadStartup (Thumb, 48 bytes, Stack size 16 bytes, rtx_thread.o(.text.osRtxThreadStartup))

[Stack]

- Max Depth = 88
- Call Chain = osRtxThreadStartup ⇒ svcRtxThreadNew ⇒ osRtxThreadDispatch ⇒ osRtxThreadReadyPut ⇒ osRtxThreadListPut

[Calls]

- >> svcRtxThreadNew

[Called By]

- >> svcRtxKernelStart

osRtxThreadSwitch (Thumb, 12 bytes, Stack size 0 bytes, rtx_thread.o(.text.osRtxThreadSwitch))

[Called By]

- >> osRtxTick_Handler
- >> svcRtxKernelStart

osRtxThreadWaitEnter (Thumb, 56 bytes, Stack size 8 bytes, rtx_thread.o(.text.osRtxThreadWaitEnter))

[Stack]

- Max Depth = 24
- Call Chain = osRtxThreadWaitEnter ⇒ osRtxThreadDelayInsert

[Calls]

- >> osRtxThreadDelayInsert

[Called By]

- >> svcRtxMessageQueuePut
- >> svcRtxMessageQueueGet
- >> svcRtxMutexAcquire
- >> svcRtxDelay
- >> svcRtxThreadFlagsWait

osRtxThreadWaitExit (Thumb, 34 bytes, Stack size 16 bytes, rtx_thread.o(.text.osRtxThreadWaitExit))

[Stack]

- Max Depth = 40
- Call Chain = osRtxThreadWaitExit ⇒ osRtxThreadDispatch ⇒ osRtxThreadReadyPut ⇒ osRtxThreadListPut

[Calls]

- >> osRtxThreadReadyPut
- >> osRtxThreadDelayRemove
- >> osRtxThreadDispatch

[Called By]

- >> svcRtxMessageQueuePut
- >> svcRtxMessageQueueGet
- >> OUTLINED_FUNCTION_0
- >> svcRtxMutexRelease
- >> svcRtxMutexDelete
- >> osRtxMutexOwnerRelease
- >> svcRtxThreadFlagsSet
- >> osRtxThreadPostProcess
- >> osRtxThreadJoinWakeup

osRtxTick_Handler (Thumb, 116 bytes, Stack size 16 bytes, rtx_system.o(.text.osRtxTick_Handler))

[Stack]

- Max Depth = 72
- Call Chain = osRtxTick_Handler ⇒ osRtxThreadDelayTick ⇒ osRtxMutexOwnerRestore ⇒ osRtxThreadListSort ⇒ osRtxThreadListPut

[Calls]

- >> OS_Tick_AcknowledgeIRQ
- >> osRtxThreadReadyPut
- >> osRtxThreadListRemove
- >> osRtxThreadSwitch
- >> osRtxThreadDispatch
- >> osRtxThreadDelayTick

[Called By]

- >> SysTick_Handler

osRtxTimerSetup (Thumb, 24 bytes, Stack size 8 bytes, rtx_timer.o(.text.osRtxTimerSetup))

[Stack]

- Max Depth = 76
- Call Chain = osRtxTimerSetup ⇒ osRtxMessageQueueTimerSetup ⇒ svcRtxMessageQueueNew ⇒ osRtxMemoryAlloc

[Calls]

- >> osRtxMessageQueueTimerSetup

[Address Reference Count : 1]

- rtx_lib.o(.rodata)

osRtxTimerThread (Thumb, 32 bytes, Stack size 8 bytes, rtx_timer.o(.text.osRtxTimerThread))

[Stack]

- Max Depth = 48
- Call Chain = osRtxTimerThread ⇒ osMessageQueueGet ⇒ osRtxPostProcess

[Calls]

- >> osMessageQueueGet

[Address Reference Count : 1]

- rtx_lib.o(.rodata)

osThreadExit (Thumb, 8 bytes, Stack size 0 bytes, rtx_thread.o(.text.osThreadExit))
[Address Reference Count : 1]

- rtx_thread.o(.text.svcRtxThreadNew)

osThreadFlagsSet (Thumb, 84 bytes, Stack size 16 bytes, rtx_thread.o(.text.osThreadFlagsSet))

[Stack]

- Max Depth = 32
- Call Chain = osThreadFlagsSet ⇒ osRtxPostProcess

[Calls]

- >> osRtxPostProcess

[Called By]

- >> I2C_SignalEvent_TEMP_HUM
- >> Timer_TempHum_Callback

osThreadFlagsWait (Thumb, 32 bytes, Stack size 0 bytes, rtx_thread.o(.text.osThreadFlagsWait))

[Calls]

- >> OUTLINED_FUNCTION_0

[Called By]

- >> ThTemp_Hum
- >> ReadSensorData
- >> Config_Communication

osThreadGetId (Thumb, 32 bytes, Stack size 0 bytes, rtx_thread.o(.text.osThreadGetId))

[Called By]

- >> __user_perthread_libspace

osThreadNew (Thumb, 32 bytes, Stack size 0 bytes, rtx_thread.o(.text.osThreadNew))

[Called By]

- >> Init_Thread
- >> Init_ThThermostato
- >> Init_ThTemp_Hum

osThreadYield (Thumb, 32 bytes, Stack size 0 bytes, rtx_thread.o(.text.osThreadYield))

[Calls]

- >> OUTLINED_FUNCTION_0

[Called By]

- >> ThTermostato
- >> ThTemp_Hum

osTimerNew (Thumb, 32 bytes, Stack size 8 bytes, rtx_timer.o(.text.osTimerNew))

[Stack]

- Max Depth = 8
- Call Chain = osTimerNew

[Called By]

- >> Init_servo_Timer_periodic
- >> Init_timer_TempHum

osTimerStart (Thumb, 32 bytes, Stack size 0 bytes, rtx_timer.o(.text.osTimerStart))

[Called By]

- >> move_servo
- >> ThTemp_Hum

osTimerStop (Thumb, 32 bytes, Stack size 0 bytes, rtx_timer.o(.text.osTimerStop))

[Called By]

- >> stop_servo

_btod_d2e (Thumb, 62 bytes, Stack size 0 bytes, btod.o(CL$$btod_d2e))

[Calls]

- >> _d2e_norm_op1

[Called By]

- >> _fp_digits

_d2e_denorm_low (Thumb, 70 bytes, Stack size 0 bytes, btod.o(CL$$btod_d2e_denorm_low))

[Called By]

- >> _d2e_norm_op1

_d2e_norm_op1 (Thumb, 96 bytes, Stack size 0 bytes, btod.o(CL$$btod_d2e_norm_op1))

[Calls]

- >> _d2e_denorm_low

[Called By]

- >> _btod_d2e

__btod_div_common (Thumb, 696 bytes, Stack size 24 bytes, btod.o(CL$$btod_div_common))

[Stack]

- Max Depth = 24
- Call Chain = __btod_div_common

[Called By]

- >> _btod_ediv

_e2e (Thumb, 220 bytes, Stack size 24 bytes, btod.o(CL$$btod_e2e))

[Stack]

- Max Depth = 24
- Call Chain = _e2e

[Called By]

- >> _btod_emul
- >> _btod_ediv

_btod_ediv (Thumb, 42 bytes, Stack size 28 bytes, btod.o(CL$$btod_ediv))

[Stack]

- Max Depth = 52
- Call Chain = _btod_ediv ⇒ _e2e

[Calls]

- >> _e2e
- >> __btod_div_common

[Called By]

- >> _btod_etento
- >> _fp_digits

_btod_emul (Thumb, 42 bytes, Stack size 28 bytes, btod.o(CL$$btod_emul))

[Stack]

- Max Depth = 52
- Call Chain = _btod_emul ⇒ _e2e

[Calls]

- >> __btod_mult_common
- >> _e2e

[Called By]

- >> _btod_etento
- >> _fp_digits

__btod_mult_common (Thumb, 580 bytes, Stack size 16 bytes, btod.o(CL$$btod_mult_common))

[Stack]

- Max Depth = 16
- Call Chain = __btod_mult_common

[Called By]

- >> _btod_emul

BusFault_Handler (Thumb, 4 bytes, Stack size 0 bytes, stm32f4xx_it.o(i.BusFault_Handler))
[Address Reference Count : 1]

- startup_stm32f429xx.o(RESET)

Config_Communication (Thumb, 54 bytes, Stack size 16 bytes, temp_hum.o(i.Config_Communication))

[Stack]

- Max Depth = 160 + Unknown Stack Size
- Call Chain = Config_Communication ⇒ __2printf ⇒ _printf_char_file ⇒ _printf_char_common ⇒ __printf

[Calls]

- >> osThreadFlagsWait
- >> Set_SingleShot_Mode
- >> Set_PeriodicAdq_Mode
- >> __2printf

[Called By]

- >> ThTemp_Hum

DebugMon_Handler (Thumb, 2 bytes, Stack size 0 bytes, stm32f4xx_it.o(i.DebugMon_Handler))
[Address Reference Count : 1]

- startup_stm32f429xx.o(RESET)

HAL_DMA_Abort (Thumb, 170 bytes, Stack size 16 bytes, stm32f4xx_hal_dma.o(i.HAL_DMA_Abort))

[Stack]

- Max Depth = 24
- Call Chain = HAL_DMA_Abort ⇒ HAL_GetTick

[Calls]

- >> HAL_GetTick

[Called By]

- >> I2C_PowerControl
- >> I2C_ER_IRQHandler
- >> I2C_Control

HAL_DMA_Init (Thumb, 232 bytes, Stack size 24 bytes, stm32f4xx_hal_dma.o(i.HAL_DMA_Init))

[Stack]

- Max Depth = 32
- Call Chain = HAL_DMA_Init ⇒ HAL_GetTick

[Calls]

- >> HAL_GetTick
- >> DMA_CheckFifoParam
- >> DMA_CalcBaseAndBitshift

[Called By]

- >> I2C_Initialize

HAL_DMA_Start_IT (Thumb, 146 bytes, Stack size 32 bytes, stm32f4xx_hal_dma.o(i.HAL_DMA_Start_IT))

[Stack]

- Max Depth = 44
- Call Chain = HAL_DMA_Start_IT ⇒ DMA_SetConfig

[Calls]

- >> DMA_SetConfig

[Called By]

- >> I2C_SlaveTransmit
- >> I2C_SlaveReceive
- >> I2C_MasterTransmit
- >> I2C_MasterReceive

HAL_Delay (Thumb, 36 bytes, Stack size 16 bytes, stm32f4xx_hal.o(i.HAL_Delay))

[Stack]

- Max Depth = 24
- Call Chain = HAL_Delay ⇒ HAL_GetTick

[Calls]

- >> HAL_GetTick

[Called By]

- >> I2C_Control

HAL_GPIO_DeInit (Thumb, 336 bytes, Stack size 20 bytes, stm32f4xx_hal_gpio.o(i.HAL_GPIO_DeInit))

[Stack]

- Max Depth = 20
- Call Chain = HAL_GPIO_DeInit

[Called By]

- >> I2C_Uninitialize

HAL_GPIO_Init (Thumb, 486 bytes, Stack size 24 bytes, stm32f4xx_hal_gpio.o(i.HAL_GPIO_Init))

[Stack]

- Max Depth = 24
- Call Chain = HAL_GPIO_Init

[Called By]

- >> I2C_Initialize
- >> I2C_Control
- >> init_ventilador
- >> init_servo

HAL_GPIO_ReadPin (Thumb, 16 bytes, Stack size 0 bytes, stm32f4xx_hal_gpio.o(i.HAL_GPIO_ReadPin))

[Called By]

- >> I2C_Control

HAL_GPIO_WritePin (Thumb, 12 bytes, Stack size 0 bytes, stm32f4xx_hal_gpio.o(i.HAL_GPIO_WritePin))

[Called By]

- >> I2C_Control
- >> init_ventilador
- >> encender_ventilador
- >> apagar_ventilador

HAL_GetREVID (Thumb, 8 bytes, Stack size 0 bytes, stm32f4xx_hal.o(i.HAL_GetREVID))

[Called By]

- >> SystemClock_Config

HAL_GetTick (Thumb, 66 bytes, Stack size 8 bytes, main.o(i.HAL_GetTick))

[Stack]

- Max Depth = 8
- Call Chain = HAL_GetTick

[Calls]

- >> osKernelGetTickCount
- >> osKernelGetState

[Called By]

- >> I2C_MasterTransmit
- >> I2C_MasterReceive
- >> HAL_RCC_OscConfig
- >> HAL_RCC_ClockConfig
- >> HAL_Delay
- >> HAL_DMA_Init
- >> HAL_DMA_Abort

HAL_Init (Thumb, 44 bytes, Stack size 8 bytes, stm32f4xx_hal.o(i.HAL_Init))

[Stack]

- Max Depth = 8
- Call Chain = HAL_Init

[Calls]

- >> HAL_InitTick
- >> HAL_MspInit
- >> HAL_NVIC_SetPriorityGrouping

[Called By]

- >> main

HAL_InitTick (Thumb, 6 bytes, Stack size 0 bytes, main.o(i.HAL_InitTick))

[Called By]

- >> HAL_RCC_ClockConfig
- >> HAL_Init

HAL_MspInit (Thumb, 2 bytes, Stack size 0 bytes, stm32f4xx_hal.o(i.HAL_MspInit))

[Called By]

- >> HAL_Init

HAL_NVIC_ClearPendingIRQ (Thumb, 30 bytes, Stack size 8 bytes, stm32f4xx_hal_cortex.o(i.HAL_NVIC_ClearPendingIRQ))

[Stack]

- Max Depth = 8
- Call Chain = HAL_NVIC_ClearPendingIRQ

[Called By]

- >> I2C_PowerControl

HAL_NVIC_DisableIRQ (Thumb, 38 bytes, Stack size 8 bytes, stm32f4xx_hal_cortex.o(i.HAL_NVIC_DisableIRQ))

[Stack]

- Max Depth = 8
- Call Chain = HAL_NVIC_DisableIRQ

[Called By]

- >> I2C_PowerControl

HAL_NVIC_EnableIRQ (Thumb, 40 bytes, Stack size 0 bytes, stm32f4xx_hal_cortex.o(i.HAL_NVIC_EnableIRQ))

[Called By]

- >> I2C_PowerControl

HAL_NVIC_SetPriorityGrouping (Thumb, 32 bytes, Stack size 0 bytes, stm32f4xx_hal_cortex.o(i.HAL_NVIC_SetPriorityGrouping))

[Called By]

- >> HAL_Init

HAL_RCC_ClockConfig (Thumb, 368 bytes, Stack size 16 bytes, stm32f4xx_hal_rcc.o(i.HAL_RCC_ClockConfig))

[Stack]

- Max Depth = 96
- Call Chain = HAL_RCC_ClockConfig ⇒ HAL_RCC_GetSysClockFreq ⇒ __aeabi_uldivmod

[Calls]

- >> HAL_InitTick
- >> HAL_GetTick
- >> HAL_RCC_GetSysClockFreq

[Called By]

- >> SystemClock_Config

HAL_RCC_GetHCLKFreq (Thumb, 6 bytes, Stack size 0 bytes, stm32f4xx_hal_rcc.o(i.HAL_RCC_GetHCLKFreq))

[Called By]

- >> HAL_RCC_GetPCLK1Freq

HAL_RCC_GetPCLK1Freq (Thumb, 22 bytes, Stack size 4 bytes, stm32f4xx_hal_rcc.o(i.HAL_RCC_GetPCLK1Freq))

[Stack]

- Max Depth = 4
- Call Chain = HAL_RCC_GetPCLK1Freq

[Calls]

- >> HAL_RCC_GetHCLKFreq

[Called By]

- >> I2C_Control

HAL_RCC_GetSysClockFreq (Thumb, 162 bytes, Stack size 32 bytes, stm32f4xx_hal_rcc.o(i.HAL_RCC_GetSysClockFreq))

[Stack]

- Max Depth = 80
- Call Chain = HAL_RCC_GetSysClockFreq ⇒ __aeabi_uldivmod

[Calls]

- >> __aeabi_uldivmod

[Called By]

- >> HAL_RCC_ClockConfig

HAL_RCC_OscConfig (Thumb, 1152 bytes, Stack size 24 bytes, stm32f4xx_hal_rcc.o(i.HAL_RCC_OscConfig))

[Stack]

- Max Depth = 32
- Call Chain = HAL_RCC_OscConfig ⇒ HAL_GetTick

[Calls]

- >> HAL_GetTick

[Called By]

- >> SystemClock_Config

HAL_TIM_PWM_ConfigChannel (Thumb, 264 bytes, Stack size 16 bytes, stm32f4xx_hal_tim.o(i.HAL_TIM_PWM_ConfigChannel))

[Stack]

- Max Depth = 28
- Call Chain = HAL_TIM_PWM_ConfigChannel ⇒ TIM_OC4_SetConfig

[Calls]

- >> TIM_OC4_SetConfig
- >> TIM_OC3_SetConfig
- >> TIM_OC1_SetConfig
- >> TIM_OC2_SetConfig

[Called By]

- >> Callback_TimerServo

HAL_TIM_PWM_DeInit (Thumb, 70 bytes, Stack size 8 bytes, stm32f4xx_hal_tim.o(i.HAL_TIM_PWM_DeInit))

[Stack]

- Max Depth = 8
- Call Chain = HAL_TIM_PWM_DeInit

[Calls]

- >> HAL_TIM_PWM_MspDeInit

[Called By]

- >> stop_servo

HAL_TIM_PWM_Init (Thumb, 52 bytes, Stack size 8 bytes, stm32f4xx_hal_tim.o(i.HAL_TIM_PWM_Init))

[Stack]

- Max Depth = 16
- Call Chain = HAL_TIM_PWM_Init ⇒ TIM_Base_SetConfig

[Calls]

- >> HAL_TIM_PWM_MspInit
- >> TIM_Base_SetConfig

[Called By]

- >> Callback_TimerServo

HAL_TIM_PWM_MspDeInit (Thumb, 2 bytes, Stack size 0 bytes, stm32f4xx_hal_tim.o(i.HAL_TIM_PWM_MspDeInit))

[Called By]

- >> HAL_TIM_PWM_DeInit

HAL_TIM_PWM_MspInit (Thumb, 2 bytes, Stack size 0 bytes, stm32f4xx_hal_tim.o(i.HAL_TIM_PWM_MspInit))

[Called By]

- >> HAL_TIM_PWM_Init

HAL_TIM_PWM_Start (Thumb, 80 bytes, Stack size 16 bytes, stm32f4xx_hal_tim.o(i.HAL_TIM_PWM_Start))

[Stack]

- Max Depth = 28
- Call Chain = HAL_TIM_PWM_Start ⇒ TIM_CCxChannelCmd

[Calls]

- >> TIM_CCxChannelCmd

[Called By]

- >> Callback_TimerServo

HAL_TIM_PWM_Stop (Thumb, 126 bytes, Stack size 12 bytes, stm32f4xx_hal_tim.o(i.HAL_TIM_PWM_Stop))

[Stack]

- Max Depth = 24
- Call Chain = HAL_TIM_PWM_Stop ⇒ TIM_CCxChannelCmd

[Calls]

- >> TIM_CCxChannelCmd

[Called By]

- >> stop_servo

HardFault_Handler (Thumb, 4 bytes, Stack size 0 bytes, stm32f4xx_it.o(i.HardFault_Handler))
[Address Reference Count : 1]

- startup_stm32f429xx.o(RESET)

I2C1_ER_IRQHandler (Thumb, 10 bytes, Stack size 8 bytes, i2c_stm32f4xx.o(i.I2C1_ER_IRQHandler))

[Stack]

- Max Depth = 56
- Call Chain = I2C1_ER_IRQHandler ⇒ I2C_ER_IRQHandler ⇒ HAL_DMA_Abort ⇒ HAL_GetTick

[Calls]

- >> I2C_ER_IRQHandler

[Address Reference Count : 1]

- startup_stm32f429xx.o(RESET)

I2C1_EV_IRQHandler (Thumb, 10 bytes, Stack size 8 bytes, i2c_stm32f4xx.o(i.I2C1_EV_IRQHandler))

[Stack]

- Max Depth = 48
- Call Chain = I2C1_EV_IRQHandler ⇒ I2C_EV_IRQHandler

[Calls]

- >> I2C_EV_IRQHandler

[Address Reference Count : 1]

- startup_stm32f429xx.o(RESET)

I2C_SignalEvent_TEMP_HUM (Thumb, 30 bytes, Stack size 16 bytes, temp_hum.o(i.I2C_SignalEvent_TEMP_HUM))

[Stack]

- Max Depth = 160 + Unknown Stack Size
- Call Chain = I2C_SignalEvent_TEMP_HUM ⇒ __2printf ⇒ _printf_char_file ⇒ _printf_char_common ⇒ __printf

[Calls]

- >> osThreadFlagsSet
- >> __2printf

[Address Reference Count : 1]

- temp_hum.o(i.Init_ThTemp_Hum)

ITM_SendChar (Thumb, 42 bytes, Stack size 0 bytes, retarget_io.o(i.ITM_SendChar))

[Called By]

- >> stdout_putchar

Init_MsgTemp_Hum (Thumb, 34 bytes, Stack size 8 bytes, temp_hum.o(i.Init_MsgTemp_Hum))

[Stack]

- Max Depth = 8
- Call Chain = Init_MsgTemp_Hum

[Calls]

- >> osMessageQueueNew

[Called By]

- >> ThTemp_Hum

Init_ThTemp_Hum (Thumb, 76 bytes, Stack size 8 bytes, temp_hum.o(i.Init_ThTemp_Hum))

[Stack]

- Max Depth = 8
- Call Chain = Init_ThTemp_Hum

[Calls]

- >> osThreadNew

[Called By]

- >> main

Init_ThThermostato (Thumb, 36 bytes, Stack size 8 bytes, thtermostato.o(i.Init_ThThermostato))

[Stack]

- Max Depth = 40
- Call Chain = Init_ThThermostato ⇒ init_ventilador ⇒ HAL_GPIO_Init

[Calls]

- >> init_ventilador
- >> osThreadNew

[Called By]

- >> main

Init_Thread (Thumb, 32 bytes, Stack size 8 bytes, testtemphum.o(i.Init_Thread))

[Stack]

- Max Depth = 8
- Call Chain = Init_Thread

[Calls]

- >> osThreadNew

[Called By]

- >> main

Init_Ventilador_MsgTemp_Hum (Thumb, 34 bytes, Stack size 8 bytes, thtermostato.o(i.Init_Ventilador_MsgTemp_Hum))

[Stack]

- Max Depth = 8
- Call Chain = Init_Ventilador_MsgTemp_Hum

[Calls]

- >> osMessageQueueNew

[Called By]

- >> ThTermostato

Init_timer_TempHum (Thumb, 46 bytes, Stack size 8 bytes, temp_hum.o(i.Init_timer_TempHum))

[Stack]

- Max Depth = 16
- Call Chain = Init_timer_TempHum ⇒ osTimerNew

[Calls]

- >> osTimerNew

[Called By]

- >> ThTemp_Hum

MemManage_Handler (Thumb, 4 bytes, Stack size 0 bytes, stm32f4xx_it.o(i.MemManage_Handler))
[Address Reference Count : 1]

- startup_stm32f429xx.o(RESET)

NMI_Handler (Thumb, 2 bytes, Stack size 0 bytes, stm32f4xx_it.o(i.NMI_Handler))
[Address Reference Count : 1]

- startup_stm32f429xx.o(RESET)

ReadSensorData (Thumb, 128 bytes, Stack size 16 bytes, temp_hum.o(i.ReadSensorData))

[Stack]

- Max Depth = 32
- Call Chain = ReadSensorData ⇒ __aeabi_fmul

[Calls]

- >> osThreadFlagsWait
- >> __aeabi_fmul
- >> __aeabi_ui2f
- >> __aeabi_fdiv
- >> __aeabi_fsub

[Called By]

- >> ThTemp_Hum

Set_PeriodicAdq_Mode (Thumb, 12 bytes, Stack size 0 bytes, temp_hum.o(i.Set_PeriodicAdq_Mode))

[Called By]

- >> Config_Communication

Set_SingleShot_Mode (Thumb, 12 bytes, Stack size 0 bytes, temp_hum.o(i.Set_SingleShot_Mode))

[Called By]

- >> Config_Communication

SystemCoreClockUpdate (Thumb, 170 bytes, Stack size 16 bytes, system_stm32f4xx.o(i.SystemCoreClockUpdate))

[Stack]

- Max Depth = 16
- Call Chain = SystemCoreClockUpdate

[Called By]

- >> main

SystemInit (Thumb, 2 bytes, Stack size 0 bytes, system_stm32f4xx.o(i.SystemInit))
[Address Reference Count : 1]

- startup_stm32f429xx.o(.text)

TIM_Base_SetConfig (Thumb, 170 bytes, Stack size 8 bytes, stm32f4xx_hal_tim.o(i.TIM_Base_SetConfig))

[Stack]

- Max Depth = 8
- Call Chain = TIM_Base_SetConfig

[Called By]

- >> HAL_TIM_PWM_Init

TIM_CCxChannelCmd (Thumb, 34 bytes, Stack size 12 bytes, stm32f4xx_hal_tim.o(i.TIM_CCxChannelCmd))

[Stack]

- Max Depth = 12
- Call Chain = TIM_CCxChannelCmd

[Called By]

- >> HAL_TIM_PWM_Stop
- >> HAL_TIM_PWM_Start

TIM_OC2_SetConfig (Thumb, 114 bytes, Stack size 12 bytes, stm32f4xx_hal_tim.o(i.TIM_OC2_SetConfig))

[Stack]

- Max Depth = 12
- Call Chain = TIM_OC2_SetConfig

[Called By]

- >> HAL_TIM_PWM_ConfigChannel

ThTemp_Hum (Thumb, 70 bytes, Stack size 0 bytes, temp_hum.o(i.ThTemp_Hum))

[Stack]

- Max Depth = 160 + Unknown Stack Size
- Call Chain = ThTemp_Hum ⇒ Config_Communication ⇒ __2printf ⇒ _printf_char_file ⇒ _printf_char_common ⇒ __printf

[Calls]

- >> osTimerStart
- >> osThreadYield
- >> osThreadFlagsWait
- >> osMessageQueuePut
- >> osDelay
- >> ReadSensorData
- >> Init_timer_TempHum
- >> Init_MsgTemp_Hum
- >> Config_Communication

[Address Reference Count : 1]

- temp_hum.o(i.Init_ThTemp_Hum)

ThTermostato (Thumb, 86 bytes, Stack size 0 bytes, thtermostato.o(i.ThTermostato))

[Stack]

- Max Depth = 160 + Unknown Stack Size
- Call Chain = ThTermostato ⇒ move_servo ⇒ Init_servo_Timer_periodic ⇒ __2printf ⇒ _printf_char_file ⇒ _printf_char_common ⇒ __printf

[Calls]

- >> stop_servo
- >> move_servo
- >> init_servo
- >> encender_ventilador
- >> apagar_ventilador
- >> Init_Ventilador_MsgTemp_Hum
- >> osMessageQueueGet
- >> osThreadYield
- >> __aeabi_cfrcmple
- >> __aeabi_cfcmple

[Address Reference Count : 1]

- thtermostato.o(i.Init_ThThermostato)

Thread (Thumb, 80 bytes, Stack size 16 bytes, testtemphum.o(i.Thread))

[Stack]

- Max Depth = 160 + Unknown Stack Size
- Call Chain = Thread ⇒ __2printf ⇒ _printf_char_file ⇒ _printf_char_common ⇒ __printf

[Calls]

- >> osMessageQueueGetCount
- >> osMessageQueueGet
- >> osMessageQueuePut
- >> __aeabi_f2d
- >> __2printf

[Address Reference Count : 1]

- testtemphum.o(i.Init_Thread)

UsageFault_Handler (Thumb, 4 bytes, Stack size 0 bytes, stm32f4xx_it.o(i.UsageFault_Handler))
[Address Reference Count : 1]

- startup_stm32f429xx.o(RESET)

__ARM_fpclassify (Thumb, 40 bytes, Stack size 0 bytes, fpclassify.o(i.__ARM_fpclassify))

[Called By]

- >> _printf_fp_dec_real

__user_perthread_libspace (Thumb, 80 bytes, Stack size 16 bytes, rtx_lib.o(i.__user_perthread_libspace))

[Stack]

- Max Depth = 24
- Call Chain = __user_perthread_libspace ⇒ os_kernel_is_active

[Calls]

- >> osThreadGetId
- >> osRtxKernelErrorNotify
- >> os_kernel_is_active

[Called By]

- >> __aeabi_errno_addr

_is_digit (Thumb, 14 bytes, Stack size 0 bytes, __printf_wp.o(i._is_digit))

[Called By]

- >> __printf

_mutex_acquire (Thumb, 22 bytes, Stack size 8 bytes, rtx_lib.o(i._mutex_acquire))

[Stack]

- Max Depth = 16
- Call Chain = _mutex_acquire ⇒ os_kernel_is_active

[Calls]

- >> osMutexAcquire
- >> os_kernel_is_active

[Called By]

- >> _printf_char_file
- >> _malloc_internal
- >> _fopen$locked
- >> freopen
- >> _freopen_locked
- >> setvbuf
- >> _free_internal
- >> _terminateio

_mutex_free (Thumb, 12 bytes, Stack size 8 bytes, rtx_lib.o(i._mutex_free))

[Stack]

- Max Depth = 8
- Call Chain = _mutex_free

[Calls]

- >> osMutexDelete

[Called By]

- >> __Heap_Finalize
- >> _terminateio

_mutex_initialize (Thumb, 34 bytes, Stack size 16 bytes, rtx_lib.o(i._mutex_initialize))

[Stack]

- Max Depth = 16
- Call Chain = _mutex_initialize

[Calls]

- >> osRtxKernelErrorNotify
- >> osMutexNew

[Called By]

- >> __Heap_Initialize
- >> _fopen$locked
- >> _initio

_mutex_release (Thumb, 18 bytes, Stack size 8 bytes, rtx_lib.o(i._mutex_release))

[Stack]

- Max Depth = 16
- Call Chain = _mutex_release ⇒ os_kernel_is_active

[Calls]

- >> osMutexRelease
- >> os_kernel_is_active

[Called By]

- >> _printf_char_file
- >> _malloc_internal
- >> _fopen$locked
- >> freopen
- >> _freopen_locked
- >> setvbuf
- >> _free_internal
- >> _terminateio

_platform_post_stackheap_init (Thumb, 8 bytes, Stack size 8 bytes, rtx_lib.o(i._platform_post_stackheap_init))

[Stack]

- Max Depth = 16
- Call Chain = _platform_post_stackheap_init ⇒ osKernelInitialize

[Calls]

- >> osKernelInitialize

[Called By]

- >> __rt_entry_postsh_1

_sys_close (Thumb, 38 bytes, Stack size 0 bytes, retarget_io.o(i._sys_close))

[Called By]

- >> _fclose_internal

_sys_flen (Thumb, 36 bytes, Stack size 0 bytes, retarget_io.o(i._sys_flen))

[Called By]

- >> _fseek
- >> __flsbuf

_sys_istty (Thumb, 36 bytes, Stack size 0 bytes, retarget_io.o(i._sys_istty))

[Called By]

- >> _fseek
- >> __flsbuf

_sys_open (Thumb, 80 bytes, Stack size 16 bytes, retarget_io.o(i._sys_open))

[Stack]

- Max Depth = 16
- Call Chain = _sys_open

[Calls]

- >> strcmp

[Called By]

- >> _freopen_locked

_sys_seek (Thumb, 44 bytes, Stack size 0 bytes, retarget_io.o(i._sys_seek))

[Called By]

- >> _writebuf

_sys_write (Thumb, 70 bytes, Stack size 24 bytes, retarget_io.o(i._sys_write))

[Stack]

- Max Depth = 28
- Call Chain = _sys_write ⇒ stdout_putchar

[Calls]

- >> stdout_putchar

[Called By]

- >> _writebuf

apagar_ventilador (Thumb, 20 bytes, Stack size 8 bytes, thtermostato.o(i.apagar_ventilador))

[Stack]

- Max Depth = 8
- Call Chain = apagar_ventilador

[Calls]

- >> HAL_GPIO_WritePin

[Called By]

- >> ThTermostato

encender_ventilador (Thumb, 20 bytes, Stack size 8 bytes, thtermostato.o(i.encender_ventilador))

[Stack]

- Max Depth = 8
- Call Chain = encender_ventilador

[Calls]

- >> HAL_GPIO_WritePin

[Called By]

- >> ThTermostato

_fputc$unlocked (Thumb, 26 bytes, Stack size 0 bytes, fputc.o(i.fputc))

[Stack]

- Max Depth = 32
- Call Chain = _fputc$unlocked ⇒ __flsbuf_byte

[Calls]

- >> __flsbuf_byte

[Address Reference Count : 1]

- _printf_char_file_locked.o(.text)

init_servo (Thumb, 94 bytes, Stack size 8 bytes, thtermostato.o(i.init_servo))

[Stack]

- Max Depth = 32
- Call Chain = init_servo ⇒ HAL_GPIO_Init

[Calls]

- >> HAL_GPIO_Init

[Called By]

- >> ThTermostato

init_ventilador (Thumb, 70 bytes, Stack size 8 bytes, thtermostato.o(i.init_ventilador))

[Stack]

- Max Depth = 32
- Call Chain = init_ventilador ⇒ HAL_GPIO_Init

[Calls]

- >> HAL_GPIO_WritePin
- >> HAL_GPIO_Init

[Called By]

- >> Init_ThThermostato

main (Thumb, 36 bytes, Stack size 0 bytes, main.o(i.main))

[Stack]

- Max Depth = 176
- Call Chain = main ⇒ SystemClock_Config ⇒ HAL_RCC_ClockConfig ⇒ HAL_RCC_GetSysClockFreq ⇒ __aeabi_uldivmod

[Calls]

- >> osKernelStart
- >> osKernelInitialize
- >> SystemCoreClockUpdate
- >> Init_Thread
- >> Init_ThThermostato
- >> Init_ThTemp_Hum
- >> HAL_Init
- >> SystemClock_Config

[Called By]

- >> __rt_entry_main

move_servo (Thumb, 24 bytes, Stack size 8 bytes, thtermostato.o(i.move_servo))

[Stack]

- Max Depth = 160 + Unknown Stack Size
- Call Chain = move_servo ⇒ Init_servo_Timer_periodic ⇒ __2printf ⇒ _printf_char_file ⇒ _printf_char_common ⇒ __printf

[Calls]

- >> Init_servo_Timer_periodic
- >> osTimerStart

[Called By]

- >> ThTermostato

osRtxErrorNotify (Thumb, 32 bytes, Stack size 0 bytes, rtx_config.o(i.osRtxErrorNotify))

[Called By]

- >> osRtxKernelErrorNotify

osRtxIdleThread (Thumb, 4 bytes, Stack size 0 bytes, rtx_config.o(i.osRtxIdleThread))
[Address Reference Count : 1]

- rtx_thread.o(.text.osRtxThreadStartup)

stop_servo (Thumb, 32 bytes, Stack size 8 bytes, thtermostato.o(i.stop_servo))

[Stack]

- Max Depth = 32
- Call Chain = stop_servo ⇒ HAL_TIM_PWM_Stop ⇒ TIM_CCxChannelCmd

[Calls]

- >> osTimerStop
- >> HAL_TIM_PWM_Stop
- >> HAL_TIM_PWM_DeInit

[Called By]

- >> ThTermostato

_get_lc_numeric (Thumb, 44 bytes, Stack size 8 bytes, lc_numeric_c.o(locale$$code))

[Stack]

- Max Depth = 8
- Call Chain = _get_lc_numeric

[Calls]

- >> strcmp

[Called By]

- >> __rt_lib_init_lc_numeric_2

__fpl_dretinf (Thumb, 12 bytes, Stack size 0 bytes, dretinf.o(x$fpl$dretinf), UNUSED)

[Called By]

- >> _f2d

__aeabi_f2d (Thumb, 0 bytes, Stack size 16 bytes, f2d.o(x$fpl$f2d))

[Stack]

- Max Depth = 16
- Call Chain = __aeabi_f2d

[Called By]

- >> Thread

_f2d (Thumb, 86 bytes, Stack size 16 bytes, f2d.o(x$fpl$f2d), UNUSED)

[Calls]

- >> __fpl_fnaninf
- >> __fpl_dretinf

__aeabi_fadd (Thumb, 0 bytes, Stack size 16 bytes, faddsub_clz.o(x$fpl$fadd), UNUSED)

_fadd (Thumb, 196 bytes, Stack size 16 bytes, faddsub_clz.o(x$fpl$fadd), UNUSED)

[Calls]

- >> __fpl_fretinf
- >> __fpl_fnaninf
- >> _fsub1

__fpl_fcmp_Inf (Thumb, 24 bytes, Stack size 0 bytes, fcmpi.o(x$fpl$fcmpinf), UNUSED)

[Called By]

- >> _fcmple

__aeabi_fdiv (Thumb, 0 bytes, Stack size 16 bytes, fdiv.o(x$fpl$fdiv))

[Stack]

- Max Depth = 16
- Call Chain = __aeabi_fdiv

[Called By]

- >> ReadSensorData

_fdiv (Thumb, 384 bytes, Stack size 16 bytes, fdiv.o(x$fpl$fdiv), UNUSED)

[Calls]

- >> __fpl_fretinf
- >> __fpl_fnaninf

__aeabi_ui2f (Thumb, 0 bytes, Stack size 0 bytes, fflt_clz.o(x$fpl$ffltu))

[Called By]

- >> ReadSensorData

_ffltu (Thumb, 38 bytes, Stack size 0 bytes, fflt_clz.o(x$fpl$ffltu), UNUSED)

__aeabi_cfcmple (Thumb, 0 bytes, Stack size 16 bytes, fleqf.o(x$fpl$fleqf))

[Stack]

- Max Depth = 16
- Call Chain = __aeabi_cfcmple

[Called By]

- >> ThTermostato

_fcmple (Thumb, 104 bytes, Stack size 16 bytes, fleqf.o(x$fpl$fleqf), UNUSED)

[Calls]

- >> __fpl_fnaninf
- >> __fpl_fcmp_Inf

__fpl_fcmple_InfNaN (Thumb, 0 bytes, Stack size unknown bytes, fleqf.o(x$fpl$fleqf), UNUSED)

[Called By]

- >> _frcmple

__aeabi_fmul (Thumb, 0 bytes, Stack size 16 bytes, fmul.o(x$fpl$fmul))

[Stack]

- Max Depth = 16
- Call Chain = __aeabi_fmul

[Called By]

- >> ReadSensorData

_fmul (Thumb, 258 bytes, Stack size 16 bytes, fmul.o(x$fpl$fmul), UNUSED)

[Calls]

- >> __fpl_fretinf
- >> __fpl_fnaninf

__fpl_fnaninf (Thumb, 140 bytes, Stack size 8 bytes, fnaninf.o(x$fpl$fnaninf), UNUSED)

[Called By]

- >> _fmul
- >> _fcmple
- >> _fdiv
- >> _fsub
- >> _fadd
- >> _f2d

__fpl_fretinf (Thumb, 10 bytes, Stack size 0 bytes, fretinf.o(x$fpl$fretinf), UNUSED)

[Called By]

- >> _fmul
- >> _fdiv
- >> _fadd

__aeabi_cfrcmple (Thumb, 0 bytes, Stack size 0 bytes, frleqf.o(x$fpl$frleqf))

[Called By]

- >> ThTermostato

_frcmple (Thumb, 98 bytes, Stack size 0 bytes, frleqf.o(x$fpl$frleqf), UNUSED)

[Calls]

- >> __fpl_fcmple_InfNaN

__aeabi_fsub (Thumb, 0 bytes, Stack size 16 bytes, faddsub_clz.o(x$fpl$fsub))

[Stack]

- Max Depth = 16
- Call Chain = __aeabi_fsub

[Called By]

- >> ReadSensorData

_fsub (Thumb, 234 bytes, Stack size 16 bytes, faddsub_clz.o(x$fpl$fsub), UNUSED)

[Calls]

- >> __fpl_fnaninf
- >> _fadd1

_printf_fp_dec (Thumb, 4 bytes, Stack size 0 bytes, printf1.o(x$fpl$printf1))

[Stack]

- Max Depth = 324
- Call Chain = _printf_fp_dec ⇒ _printf_fp_dec_real ⇒ _fp_digits ⇒ _btod_etento ⇒ _btod_emul ⇒ _e2e

[Calls]

- >> _printf_fp_dec_real

[Called By]

- >> _printf_f

### Local Symbols

Error_Handler (Thumb, 4 bytes, Stack size 0 bytes, main.o(i.Error_Handler))

[Called By]

- >> SystemClock_Config

SystemClock_Config (Thumb, 180 bytes, Stack size 80 bytes, main.o(i.SystemClock_Config))

[Stack]

- Max Depth = 176
- Call Chain = SystemClock_Config ⇒ HAL_RCC_ClockConfig ⇒ HAL_RCC_GetSysClockFreq ⇒ __aeabi_uldivmod

[Calls]

- >> HAL_RCC_OscConfig
- >> HAL_RCC_ClockConfig
- >> HAL_GetREVID
- >> Error_Handler

[Called By]

- >> main

Timer_TempHum_Callback (Thumb, 16 bytes, Stack size 8 bytes, temp_hum.o(i.Timer_TempHum_Callback))

[Stack]

- Max Depth = 40
- Call Chain = Timer_TempHum_Callback ⇒ osThreadFlagsSet ⇒ osRtxPostProcess

[Calls]

- >> osThreadFlagsSet

[Address Reference Count : 1]

- temp_hum.o(i.Init_timer_TempHum)

Callback_TimerServo (Thumb, 130 bytes, Stack size 8 bytes, thtermostato.o(i.Callback_TimerServo))

[Stack]

- Max Depth = 36
- Call Chain = Callback_TimerServo ⇒ HAL_TIM_PWM_Start ⇒ TIM_CCxChannelCmd

[Calls]

- >> HAL_TIM_PWM_Start
- >> HAL_TIM_PWM_Init
- >> HAL_TIM_PWM_ConfigChannel

[Address Reference Count : 1]

- thtermostato.o(i.Init_servo_Timer_periodic)

Init_servo_Timer_periodic (Thumb, 36 bytes, Stack size 8 bytes, thtermostato.o(i.Init_servo_Timer_periodic))

[Stack]

- Max Depth = 152 + Unknown Stack Size
- Call Chain = Init_servo_Timer_periodic ⇒ __2printf ⇒ _printf_char_file ⇒ _printf_char_common ⇒ __printf

[Calls]

- >> osTimerNew
- >> __2printf

[Called By]

- >> move_servo

os_kernel_is_active (Thumb, 28 bytes, Stack size 8 bytes, rtx_lib.o(i.os_kernel_is_active))

[Stack]

- Max Depth = 8
- Call Chain = os_kernel_is_active

[Calls]

- >> osKernelGetState

[Called By]

- >> _mutex_release
- >> _mutex_acquire
- >> __user_perthread_libspace

Enable_GPIO_Clock (Thumb, 422 bytes, Stack size 8 bytes, i2c_stm32f4xx.o(i.Enable_GPIO_Clock))

[Stack]

- Max Depth = 8
- Call Chain = Enable_GPIO_Clock

[Called By]

- >> I2C_Initialize

I2C1_Control (Thumb, 18 bytes, Stack size 16 bytes, i2c_stm32f4xx.o(i.I2C1_Control))

[Stack]

- Max Depth = 96
- Call Chain = I2C1_Control ⇒ I2C_Control ⇒ HAL_GPIO_Init

[Calls]

- >> I2C_Control

[Address Reference Count : 1]

- i2c_stm32f4xx.o(.constdata)

I2C1_GetDataCount (Thumb, 10 bytes, Stack size 8 bytes, i2c_stm32f4xx.o(i.I2C1_GetDataCount))

[Stack]

- Max Depth = 8
- Call Chain = I2C1_GetDataCount

[Calls]

- >> I2C_GetDataCount

[Address Reference Count : 1]

- i2c_stm32f4xx.o(.constdata)

I2C1_GetStatus (Thumb, 12 bytes, Stack size 8 bytes, i2c_stm32f4xx.o(i.I2C1_GetStatus))

[Stack]

- Max Depth = 8
- Call Chain = I2C1_GetStatus

[Calls]

- >> I2C_GetStatus

[Address Reference Count : 1]

- i2c_stm32f4xx.o(.constdata)

I2C1_Initialize (Thumb, 14 bytes, Stack size 8 bytes, i2c_stm32f4xx.o(i.I2C1_Initialize))

[Stack]

- Max Depth = 80
- Call Chain = I2C1_Initialize ⇒ I2C_Initialize ⇒ HAL_DMA_Init ⇒ HAL_GetTick

[Calls]

- >> I2C_Initialize

[Address Reference Count : 1]

- i2c_stm32f4xx.o(.constdata)

I2C1_MasterReceive (Thumb, 28 bytes, Stack size 24 bytes, i2c_stm32f4xx.o(i.I2C1_MasterReceive))

[Stack]

- Max Depth = 100
- Call Chain = I2C1_MasterReceive ⇒ I2C_MasterReceive ⇒ HAL_DMA_Start_IT ⇒ DMA_SetConfig

[Calls]

- >> I2C_MasterReceive

[Address Reference Count : 1]

- i2c_stm32f4xx.o(.constdata)

I2C1_MasterTransmit (Thumb, 28 bytes, Stack size 24 bytes, i2c_stm32f4xx.o(i.I2C1_MasterTransmit))

[Stack]

- Max Depth = 100
- Call Chain = I2C1_MasterTransmit ⇒ I2C_MasterTransmit ⇒ HAL_DMA_Start_IT ⇒ DMA_SetConfig

[Calls]

- >> I2C_MasterTransmit

[Address Reference Count : 1]

- i2c_stm32f4xx.o(.constdata)

I2C1_PowerControl (Thumb, 14 bytes, Stack size 8 bytes, i2c_stm32f4xx.o(i.I2C1_PowerControl))

[Stack]

- Max Depth = 48
- Call Chain = I2C1_PowerControl ⇒ I2C_PowerControl ⇒ HAL_DMA_Abort ⇒ HAL_GetTick

[Calls]

- >> I2C_PowerControl

[Address Reference Count : 1]

- i2c_stm32f4xx.o(.constdata)

I2C1_SlaveReceive (Thumb, 18 bytes, Stack size 16 bytes, i2c_stm32f4xx.o(i.I2C1_SlaveReceive))

[Stack]

- Max Depth = 76
- Call Chain = I2C1_SlaveReceive ⇒ I2C_SlaveReceive ⇒ HAL_DMA_Start_IT ⇒ DMA_SetConfig

[Calls]

- >> I2C_SlaveReceive

[Address Reference Count : 1]

- i2c_stm32f4xx.o(.constdata)

I2C1_SlaveTransmit (Thumb, 18 bytes, Stack size 16 bytes, i2c_stm32f4xx.o(i.I2C1_SlaveTransmit))

[Stack]

- Max Depth = 76
- Call Chain = I2C1_SlaveTransmit ⇒ I2C_SlaveTransmit ⇒ HAL_DMA_Start_IT ⇒ DMA_SetConfig

[Calls]

- >> I2C_SlaveTransmit

[Address Reference Count : 1]

- i2c_stm32f4xx.o(.constdata)

I2C1_Uninitialize (Thumb, 10 bytes, Stack size 8 bytes, i2c_stm32f4xx.o(i.I2C1_Uninitialize))

[Stack]

- Max Depth = 36
- Call Chain = I2C1_Uninitialize ⇒ I2C_Uninitialize ⇒ HAL_GPIO_DeInit

[Calls]

- >> I2C_Uninitialize

[Address Reference Count : 1]

- i2c_stm32f4xx.o(.constdata)

I2CX_GetCapabilities (Thumb, 6 bytes, Stack size 0 bytes, i2c_stm32f4xx.o(i.I2CX_GetCapabilities))
[Address Reference Count : 1]

- i2c_stm32f4xx.o(.constdata)

I2CX_GetVersion (Thumb, 10 bytes, Stack size 8 bytes, i2c_stm32f4xx.o(i.I2CX_GetVersion))

[Stack]

- Max Depth = 8
- Call Chain = I2CX_GetVersion

[Address Reference Count : 1]

- i2c_stm32f4xx.o(.constdata)

I2C_Control (Thumb, 816 bytes, Stack size 56 bytes, i2c_stm32f4xx.o(i.I2C_Control))

[Stack]

- Max Depth = 80
- Call Chain = I2C_Control ⇒ HAL_GPIO_Init

[Calls]

- >> HAL_GPIO_WritePin
- >> HAL_GPIO_Init
- >> HAL_RCC_GetPCLK1Freq
- >> HAL_GPIO_ReadPin
- >> HAL_Delay
- >> HAL_DMA_Abort

[Called By]

- >> I2C1_Control

I2C_ER_IRQHandler (Thumb, 518 bytes, Stack size 24 bytes, i2c_stm32f4xx.o(i.I2C_ER_IRQHandler))

[Stack]

- Max Depth = 48
- Call Chain = I2C_ER_IRQHandler ⇒ HAL_DMA_Abort ⇒ HAL_GetTick

[Calls]

- >> HAL_DMA_Abort

[Called By]

- >> I2C1_ER_IRQHandler

I2C_EV_IRQHandler (Thumb, 1724 bytes, Stack size 40 bytes, i2c_stm32f4xx.o(i.I2C_EV_IRQHandler))

[Stack]

- Max Depth = 40
- Call Chain = I2C_EV_IRQHandler

[Called By]

- >> I2C1_EV_IRQHandler

I2C_GetDataCount (Thumb, 52 bytes, Stack size 0 bytes, i2c_stm32f4xx.o(i.I2C_GetDataCount))

[Called By]

- >> I2C1_GetDataCount

I2C_GetStatus (Thumb, 8 bytes, Stack size 0 bytes, i2c_stm32f4xx.o(i.I2C_GetStatus))

[Called By]

- >> I2C1_GetStatus

I2C_Initialize (Thumb, 444 bytes, Stack size 40 bytes, i2c_stm32f4xx.o(i.I2C_Initialize))

[Stack]

- Max Depth = 72
- Call Chain = I2C_Initialize ⇒ HAL_DMA_Init ⇒ HAL_GetTick

[Calls]

- >> Enable_GPIO_Clock
- >> HAL_GPIO_Init
- >> HAL_DMA_Init
- >> __aeabi_memclr4

[Called By]

- >> I2C1_Initialize

I2C_MasterReceive (Thumb, 324 bytes, Stack size 32 bytes, i2c_stm32f4xx.o(i.I2C_MasterReceive))

[Stack]

- Max Depth = 76
- Call Chain = I2C_MasterReceive ⇒ HAL_DMA_Start_IT ⇒ DMA_SetConfig

[Calls]

- >> HAL_GetTick
- >> HAL_DMA_Start_IT

[Called By]

- >> I2C1_MasterReceive

I2C_MasterTransmit (Thumb, 298 bytes, Stack size 32 bytes, i2c_stm32f4xx.o(i.I2C_MasterTransmit))

[Stack]

- Max Depth = 76
- Call Chain = I2C_MasterTransmit ⇒ HAL_DMA_Start_IT ⇒ DMA_SetConfig

[Calls]

- >> HAL_GetTick
- >> HAL_DMA_Start_IT

[Called By]

- >> I2C1_MasterTransmit

I2C_PowerControl (Thumb, 650 bytes, Stack size 16 bytes, i2c_stm32f4xx.o(i.I2C_PowerControl))

[Stack]

- Max Depth = 40
- Call Chain = I2C_PowerControl ⇒ HAL_DMA_Abort ⇒ HAL_GetTick

[Calls]

- >> HAL_NVIC_EnableIRQ
- >> HAL_NVIC_DisableIRQ
- >> HAL_NVIC_ClearPendingIRQ
- >> HAL_DMA_Abort

[Called By]

- >> I2C1_PowerControl

I2C_SlaveReceive (Thumb, 136 bytes, Stack size 16 bytes, i2c_stm32f4xx.o(i.I2C_SlaveReceive))

[Stack]

- Max Depth = 60
- Call Chain = I2C_SlaveReceive ⇒ HAL_DMA_Start_IT ⇒ DMA_SetConfig

[Calls]

- >> HAL_DMA_Start_IT

[Called By]

- >> I2C1_SlaveReceive

I2C_SlaveTransmit (Thumb, 136 bytes, Stack size 16 bytes, i2c_stm32f4xx.o(i.I2C_SlaveTransmit))

[Stack]

- Max Depth = 60
- Call Chain = I2C_SlaveTransmit ⇒ HAL_DMA_Start_IT ⇒ DMA_SetConfig

[Calls]

- >> HAL_DMA_Start_IT

[Called By]

- >> I2C1_SlaveTransmit

I2C_Uninitialize (Thumb, 52 bytes, Stack size 8 bytes, i2c_stm32f4xx.o(i.I2C_Uninitialize))

[Stack]

- Max Depth = 28
- Call Chain = I2C_Uninitialize ⇒ HAL_GPIO_DeInit

[Calls]

- >> HAL_GPIO_DeInit

[Called By]

- >> I2C1_Uninitialize

stdout_putchar (Thumb, 12 bytes, Stack size 4 bytes, retarget_io.o(i.stdout_putchar))

[Stack]

- Max Depth = 4
- Call Chain = stdout_putchar

[Calls]

- >> ITM_SendChar

[Called By]

- >> _sys_write

DMA_CalcBaseAndBitshift (Thumb, 46 bytes, Stack size 0 bytes, stm32f4xx_hal_dma.o(i.DMA_CalcBaseAndBitshift))

[Called By]

- >> HAL_DMA_Init

DMA_CheckFifoParam (Thumb, 170 bytes, Stack size 0 bytes, stm32f4xx_hal_dma.o(i.DMA_CheckFifoParam))

[Called By]

- >> HAL_DMA_Init

DMA_SetConfig (Thumb, 44 bytes, Stack size 12 bytes, stm32f4xx_hal_dma.o(i.DMA_SetConfig))

[Stack]

- Max Depth = 12
- Call Chain = DMA_SetConfig

[Called By]

- >> HAL_DMA_Start_IT

TIM_OC1_SetConfig (Thumb, 104 bytes, Stack size 12 bytes, stm32f4xx_hal_tim.o(i.TIM_OC1_SetConfig))

[Stack]

- Max Depth = 12
- Call Chain = TIM_OC1_SetConfig

[Called By]

- >> HAL_TIM_PWM_ConfigChannel

TIM_OC3_SetConfig (Thumb, 112 bytes, Stack size 12 bytes, stm32f4xx_hal_tim.o(i.TIM_OC3_SetConfig))

[Stack]

- Max Depth = 12
- Call Chain = TIM_OC3_SetConfig

[Called By]

- >> HAL_TIM_PWM_ConfigChannel

TIM_OC4_SetConfig (Thumb, 74 bytes, Stack size 12 bytes, stm32f4xx_hal_tim.o(i.TIM_OC4_SetConfig))

[Stack]

- Max Depth = 12
- Call Chain = TIM_OC4_SetConfig

[Called By]

- >> HAL_TIM_PWM_ConfigChannel

OUTLINED_FUNCTION_0 (Thumb, 12 bytes, Stack size 0 bytes, rtx_kernel.o(.text.OUTLINED_FUNCTION_0))

[Stack]

- Max Depth = 16
- Call Chain = OUTLINED_FUNCTION_0 ⇒ osRtxMemoryPoolInit

[Calls]

- >> osRtxMemoryPoolInit

[Called By]

- >> svcRtxKernelInitialize

OUTLINED_FUNCTION_1 (Thumb, 6 bytes, Stack size 0 bytes, rtx_kernel.o(.text.OUTLINED_FUNCTION_1))

[Called By]

- >> osKernelStart

svcRtxKernelGetState (Thumb, 8 bytes, Stack size 0 bytes, rtx_kernel.o(.text.svcRtxKernelGetState))
[Address Reference Count : 1]

- rtx_kernel.o(.text.osKernelGetState)

svcRtxKernelGetTickCount (Thumb, 8 bytes, Stack size 0 bytes, rtx_kernel.o(.text.svcRtxKernelGetTickCount))
[Address Reference Count : 1]

- rtx_kernel.o(.text.osKernelGetTickCount)

svcRtxKernelInitialize (Thumb, 244 bytes, Stack size 32 bytes, rtx_kernel.o(.text.svcRtxKernelInitialize))

[Stack]

- Max Depth = 48
- Call Chain = svcRtxKernelInitialize ⇒ OUTLINED_FUNCTION_0 ⇒ osRtxMemoryPoolInit

[Calls]

- >> osRtxMemoryInit
- >> OUTLINED_FUNCTION_0

[Address Reference Count : 1]

- rtx_kernel.o(.text.osKernelInitialize)

svcRtxKernelStart (Thumb, 120 bytes, Stack size 16 bytes, rtx_kernel.o(.text.svcRtxKernelStart))

[Stack]

- Max Depth = 104
- Call Chain = svcRtxKernelStart ⇒ osRtxThreadStartup ⇒ svcRtxThreadNew ⇒ osRtxThreadDispatch ⇒ osRtxThreadReadyPut ⇒ osRtxThreadListPut

[Calls]

- >> osRtxThreadSwitch
- >> osRtxThreadStartup
- >> osRtxThreadListGet
- >> OS_Tick_Setup
- >> OS_Tick_GetIRQn
- >> OS_Tick_Enable

[Address Reference Count : 1]

- rtx_kernel.o(.text.osKernelStart)

OUTLINED_FUNCTION_0 (Thumb, 6 bytes, Stack size 0 bytes, rtx_thread.o(.text.OUTLINED_FUNCTION_0))

[Called By]

- >> osThreadYield
- >> osThreadFlagsWait

ThreadFlagsCheck (Thumb, 100 bytes, Stack size 8 bytes, rtx_thread.o(.text.ThreadFlagsCheck))

[Stack]

- Max Depth = 8
- Call Chain = ThreadFlagsCheck

[Called By]

- >> svcRtxThreadFlagsWait
- >> svcRtxThreadFlagsSet
- >> osRtxThreadPostProcess

osRtxThreadBlock (Thumb, 52 bytes, Stack size 8 bytes, rtx_thread.o(.text.osRtxThreadBlock))

[Stack]

- Max Depth = 8
- Call Chain = osRtxThreadBlock

[Called By]

- >> osRtxThreadDispatch

osRtxThreadDelayInsert (Thumb, 124 bytes, Stack size 16 bytes, rtx_thread.o(.text.osRtxThreadDelayInsert))

[Stack]

- Max Depth = 16
- Call Chain = osRtxThreadDelayInsert

[Called By]

- >> osRtxThreadWaitEnter

osRtxThreadDelayRemove (Thumb, 60 bytes, Stack size 0 bytes, rtx_thread.o(.text.osRtxThreadDelayRemove))

[Called By]

- >> osRtxThreadWaitExit

osRtxThreadDestroy (Thumb, 32 bytes, Stack size 0 bytes, rtx_thread.o(.text.osRtxThreadDestroy))

[Stack]

- Max Depth = 24
- Call Chain = osRtxThreadDestroy ⇒ osRtxThreadFree ⇒ osRtxMemoryPoolFree

[Calls]

- >> osRtxThreadFree

[Called By]

- >> svcRtxThreadExit

osRtxThreadFree (Thumb, 84 bytes, Stack size 8 bytes, rtx_thread.o(.text.osRtxThreadFree))

[Stack]

- Max Depth = 24
- Call Chain = osRtxThreadFree ⇒ osRtxMemoryPoolFree

[Calls]

- >> osRtxMemoryPoolFree
- >> osRtxMemoryFree

[Called By]

- >> osRtxThreadDestroy

osRtxThreadJoinWakeup (Thumb, 30 bytes, Stack size 8 bytes, rtx_thread.o(.text.osRtxThreadJoinWakeup))

[Stack]

- Max Depth = 48
- Call Chain = osRtxThreadJoinWakeup ⇒ osRtxThreadWaitExit ⇒ osRtxThreadDispatch ⇒ osRtxThreadReadyPut ⇒ osRtxThreadListPut

[Calls]

- >> osRtxThreadWaitExit

[Called By]

- >> svcRtxThreadExit

osRtxThreadListRoot (Thumb, 12 bytes, Stack size 0 bytes, rtx_thread.o(.text.osRtxThreadListRoot))

[Calls]

- >> osRtxThreadListRoot

[Called By]

- >> osRtxThreadListRoot
- >> osRtxThreadDelayTick

osRtxThreadPostProcess (Thumb, 40 bytes, Stack size 8 bytes, rtx_thread.o(.text.osRtxThreadPostProcess))

[Stack]

- Max Depth = 48
- Call Chain = osRtxThreadPostProcess ⇒ osRtxThreadWaitExit ⇒ osRtxThreadDispatch ⇒ osRtxThreadReadyPut ⇒ osRtxThreadListPut

[Calls]

- >> osRtxThreadWaitExit
- >> ThreadFlagsCheck

[Address Reference Count : 1]

- rtx_thread.o(.text.svcRtxThreadNew)

svcRtxThreadExit (Thumb, 72 bytes, Stack size 16 bytes, rtx_thread.o(.text.svcRtxThreadExit))

[Stack]

- Max Depth = 80
- Call Chain = svcRtxThreadExit ⇒ osRtxMutexOwnerRelease ⇒ osRtxThreadWaitExit ⇒ osRtxThreadDispatch ⇒ osRtxThreadReadyPut ⇒ osRtxThreadListPut

[Calls]

- >> osRtxMutexOwnerRelease
- >> osRtxThreadJoinWakeup
- >> osRtxThreadDestroy

[Address Reference Count : 1]

- rtx_thread.o(.text.osThreadExit)

svcRtxThreadFlagsSet (Thumb, 102 bytes, Stack size 16 bytes, rtx_thread.o(.text.svcRtxThreadFlagsSet))

[Stack]

- Max Depth = 56
- Call Chain = svcRtxThreadFlagsSet ⇒ osRtxThreadWaitExit ⇒ osRtxThreadDispatch ⇒ osRtxThreadReadyPut ⇒ osRtxThreadListPut

[Calls]

- >> osRtxThreadWaitExit
- >> ThreadFlagsCheck

[Address Reference Count : 1]

- rtx_thread.o(.text.osThreadFlagsSet)

svcRtxThreadFlagsWait (Thumb, 72 bytes, Stack size 24 bytes, rtx_thread.o(.text.svcRtxThreadFlagsWait))

[Stack]

- Max Depth = 48
- Call Chain = svcRtxThreadFlagsWait ⇒ osRtxThreadWaitEnter ⇒ osRtxThreadDelayInsert

[Calls]

- >> osRtxThreadWaitEnter
- >> ThreadFlagsCheck

[Address Reference Count : 1]

- rtx_thread.o(.text.osThreadFlagsWait)

svcRtxThreadGetId (Thumb, 8 bytes, Stack size 0 bytes, rtx_thread.o(.text.svcRtxThreadGetId))
[Address Reference Count : 1]

- rtx_thread.o(.text.osThreadGetId)

svcRtxThreadNew (Thumb, 472 bytes, Stack size 48 bytes, rtx_thread.o(.text.svcRtxThreadNew))

[Stack]

- Max Depth = 72
- Call Chain = svcRtxThreadNew ⇒ osRtxThreadDispatch ⇒ osRtxThreadReadyPut ⇒ osRtxThreadListPut

[Calls]

- >> __aeabi_memclr4
- >> osRtxMemoryPoolFree
- >> osRtxMemoryPoolAlloc
- >> osRtxMemoryFree
- >> osRtxMemoryAlloc
- >> osRtxThreadDispatch

[Called By]

- >> osRtxThreadStartup

[Address Reference Count : 1]

- rtx_thread.o(.text.osThreadNew)

svcRtxThreadYield (Thumb, 52 bytes, Stack size 16 bytes, rtx_thread.o(.text.svcRtxThreadYield))

[Stack]

- Max Depth = 24
- Call Chain = svcRtxThreadYield ⇒ osRtxThreadReadyPut ⇒ osRtxThreadListPut

[Calls]

- >> osRtxThreadReadyPut
- >> osRtxThreadListRemove

[Address Reference Count : 1]

- rtx_thread.o(.text.osThreadYield)

svcRtxDelay (Thumb, 22 bytes, Stack size 8 bytes, rtx_delay.o(.text.svcRtxDelay))

[Stack]

- Max Depth = 32
- Call Chain = svcRtxDelay ⇒ osRtxThreadWaitEnter ⇒ osRtxThreadDelayInsert

[Calls]

- >> osRtxThreadWaitEnter

[Address Reference Count : 1]

- rtx_delay.o(.text.osDelay)

TimerInsert (Thumb, 68 bytes, Stack size 16 bytes, rtx_timer.o(.text.TimerInsert))

[Stack]

- Max Depth = 16
- Call Chain = TimerInsert

[Called By]

- >> svcRtxTimerStart
- >> osRtxTimerTick

TimerRemove (Thumb, 36 bytes, Stack size 0 bytes, rtx_timer.o(.text.TimerRemove))

[Called By]

- >> svcRtxTimerStop
- >> svcRtxTimerStart

osRtxTimerTick (Thumb, 108 bytes, Stack size 24 bytes, rtx_timer.o(.text.osRtxTimerTick))

[Stack]

- Max Depth = 64
- Call Chain = osRtxTimerTick ⇒ osMessageQueuePut ⇒ osRtxPostProcess

[Calls]

- >> osRtxKernelErrorNotify
- >> osMessageQueuePut
- >> TimerInsert

[Address Reference Count : 1]

- rtx_timer.o(.text.osRtxTimerSetup)

svcRtxTimerNew (Thumb, 116 bytes, Stack size 24 bytes, rtx_timer.o(.text.svcRtxTimerNew))

[Stack]

- Max Depth = 44
- Call Chain = svcRtxTimerNew ⇒ osRtxMemoryAlloc

[Calls]

- >> osRtxMemoryPoolAlloc
- >> osRtxMemoryAlloc

[Address Reference Count : 1]

- rtx_timer.o(.text.osTimerNew)

svcRtxTimerStart (Thumb, 68 bytes, Stack size 16 bytes, rtx_timer.o(.text.svcRtxTimerStart))

[Stack]

- Max Depth = 32
- Call Chain = svcRtxTimerStart ⇒ TimerInsert

[Calls]

- >> TimerRemove
- >> TimerInsert

[Address Reference Count : 1]

- rtx_timer.o(.text.osTimerStart)

svcRtxTimerStop (Thumb, 40 bytes, Stack size 8 bytes, rtx_timer.o(.text.svcRtxTimerStop))

[Stack]

- Max Depth = 8
- Call Chain = svcRtxTimerStop

[Calls]

- >> TimerRemove

[Address Reference Count : 1]

- rtx_timer.o(.text.osTimerStop)

svcRtxMutexAcquire (Thumb, 140 bytes, Stack size 16 bytes, rtx_mutex.o(.text.svcRtxMutexAcquire))

[Stack]

- Max Depth = 40
- Call Chain = svcRtxMutexAcquire ⇒ osRtxThreadWaitEnter ⇒ osRtxThreadDelayInsert

[Calls]

- >> osRtxThreadWaitEnter
- >> osRtxThreadListSort
- >> osRtxThreadListPut

[Address Reference Count : 1]

- rtx_mutex.o(.text.osMutexAcquire)

svcRtxMutexDelete (Thumb, 172 bytes, Stack size 16 bytes, rtx_mutex.o(.text.svcRtxMutexDelete))

[Stack]

- Max Depth = 56
- Call Chain = svcRtxMutexDelete ⇒ osRtxThreadWaitExit ⇒ osRtxThreadDispatch ⇒ osRtxThreadReadyPut ⇒ osRtxThreadListPut

[Calls]

- >> osRtxThreadWaitExit
- >> osRtxThreadListSort
- >> osRtxMemoryPoolFree
- >> osRtxMemoryFree
- >> osRtxThreadListGet
- >> osRtxThreadDispatch

[Address Reference Count : 1]

- rtx_mutex.o(.text.osMutexDelete)

svcRtxMutexNew (Thumb, 100 bytes, Stack size 16 bytes, rtx_mutex.o(.text.svcRtxMutexNew))

[Stack]

- Max Depth = 36
- Call Chain = svcRtxMutexNew ⇒ osRtxMemoryAlloc

[Calls]

- >> __aeabi_memclr4
- >> osRtxMemoryPoolAlloc
- >> osRtxMemoryAlloc

[Address Reference Count : 1]

- rtx_mutex.o(.text.osMutexNew)

svcRtxMutexRelease (Thumb, 176 bytes, Stack size 16 bytes, rtx_mutex.o(.text.svcRtxMutexRelease))

[Stack]

- Max Depth = 56
- Call Chain = svcRtxMutexRelease ⇒ osRtxThreadWaitExit ⇒ osRtxThreadDispatch ⇒ osRtxThreadReadyPut ⇒ osRtxThreadListPut

[Calls]

- >> osRtxThreadWaitExit
- >> osRtxThreadListGet
- >> osRtxThreadDispatch

[Address Reference Count : 1]

- rtx_mutex.o(.text.osMutexRelease)

MessageQueueGet (Thumb, 64 bytes, Stack size 8 bytes, rtx_msgqueue.o(.text.MessageQueueGet))

[Stack]

- Max Depth = 8
- Call Chain = MessageQueueGet

[Called By]

- >> osMessageQueueGet
- >> svcRtxMessageQueueGet

MessageQueuePut (Thumb, 88 bytes, Stack size 16 bytes, rtx_msgqueue.o(.text.MessageQueuePut))

[Stack]

- Max Depth = 16
- Call Chain = MessageQueuePut

[Called By]

- >> svcRtxMessageQueuePut
- >> svcRtxMessageQueueGet
- >> osRtxMessageQueuePostProcess

MessageQueueRemove (Thumb, 28 bytes, Stack size 0 bytes, rtx_msgqueue.o(.text.MessageQueueRemove))

[Called By]

- >> svcRtxMessageQueueGet
- >> osRtxMessageQueuePostProcess

OUTLINED_FUNCTION_0 (Thumb, 12 bytes, Stack size 0 bytes, rtx_msgqueue.o(.text.OUTLINED_FUNCTION_0))

[Stack]

- Max Depth = 40
- Call Chain = OUTLINED_FUNCTION_0 ⇒ osRtxThreadWaitExit ⇒ osRtxThreadDispatch ⇒ osRtxThreadReadyPut ⇒ osRtxThreadListPut

[Calls]

- >> osRtxThreadWaitExit

[Called By]

- >> osRtxMessageQueuePostProcess

osRtxMessageQueuePostProcess (Thumb, 170 bytes, Stack size 24 bytes, rtx_msgqueue.o(.text.osRtxMessageQueuePostProcess))

[Stack]

- Max Depth = 64
- Call Chain = osRtxMessageQueuePostProcess ⇒ OUTLINED_FUNCTION_0 ⇒ osRtxThreadWaitExit ⇒ osRtxThreadDispatch ⇒ osRtxThreadReadyPut ⇒ osRtxThreadListPut

[Calls]

- >> __aeabi_memcpy
- >> OUTLINED_FUNCTION_0
- >> MessageQueueRemove
- >> MessageQueuePut
- >> osRtxThreadRegPtr
- >> osRtxMemoryPoolFree
- >> osRtxMemoryPoolAlloc
- >> osRtxThreadListGet

[Address Reference Count : 1]

- rtx_msgqueue.o(.text.svcRtxMessageQueueNew)

svcRtxMessageQueueGet (Thumb, 212 bytes, Stack size 24 bytes, rtx_msgqueue.o(.text.svcRtxMessageQueueGet))

[Stack]

- Max Depth = 64
- Call Chain = svcRtxMessageQueueGet ⇒ osRtxThreadWaitExit ⇒ osRtxThreadDispatch ⇒ osRtxThreadReadyPut ⇒ osRtxThreadListPut

[Calls]

- >> __aeabi_memcpy
- >> MessageQueueRemove
- >> MessageQueuePut
- >> MessageQueueGet
- >> osRtxThreadWaitExit
- >> osRtxThreadWaitEnter
- >> osRtxThreadRegPtr
- >> osRtxThreadListPut
- >> osRtxMemoryPoolFree
- >> osRtxMemoryPoolAlloc
- >> osRtxThreadListGet

[Address Reference Count : 1]

- rtx_msgqueue.o(.text.osMessageQueueGet)

svcRtxMessageQueueGetCount (Thumb, 16 bytes, Stack size 0 bytes, rtx_msgqueue.o(.text.svcRtxMessageQueueGetCount))
[Address Reference Count : 1]

- rtx_msgqueue.o(.text.osMessageQueueGetCount)

svcRtxMessageQueueNew (Thumb, 272 bytes, Stack size 40 bytes, rtx_msgqueue.o(.text.svcRtxMessageQueueNew))

[Stack]

- Max Depth = 60
- Call Chain = svcRtxMessageQueueNew ⇒ osRtxMemoryAlloc

[Calls]

- >> __aeabi_memclr
- >> osRtxMemoryPoolFree
- >> osRtxMemoryPoolAlloc
- >> osRtxMemoryFree
- >> osRtxMemoryAlloc
- >> osRtxMemoryPoolInit

[Called By]

- >> osRtxMessageQueueTimerSetup

[Address Reference Count : 1]

- rtx_msgqueue.o(.text.osMessageQueueNew)

svcRtxMessageQueuePut (Thumb, 176 bytes, Stack size 24 bytes, rtx_msgqueue.o(.text.svcRtxMessageQueuePut))

[Stack]

- Max Depth = 64
- Call Chain = svcRtxMessageQueuePut ⇒ osRtxThreadWaitExit ⇒ osRtxThreadDispatch ⇒ osRtxThreadReadyPut ⇒ osRtxThreadListPut

[Calls]

- >> __aeabi_memcpy
- >> MessageQueuePut
- >> osRtxThreadWaitExit
- >> osRtxThreadWaitEnter
- >> osRtxThreadRegPtr
- >> osRtxThreadListPut
- >> osRtxMemoryPoolAlloc
- >> osRtxThreadListGet

[Address Reference Count : 1]

- rtx_msgqueue.o(.text.osMessageQueuePut)

_fadd1 (Thumb, 0 bytes, Stack size unknown bytes, faddsub_clz.o(x$fpl$fadd), UNUSED)

[Called By]

- >> _fsub

_fsub1 (Thumb, 0 bytes, Stack size unknown bytes, faddsub_clz.o(x$fpl$fsub), UNUSED)

[Called By]

- >> _fadd

_fp_digits (Thumb, 432 bytes, Stack size 96 bytes, _printf_fp_dec.o(.text))

[Stack]

- Max Depth = 220
- Call Chain = _fp_digits ⇒ _btod_etento ⇒ _btod_emul ⇒ _e2e

[Calls]

- >> _btod_emul
- >> _btod_ediv
- >> _btod_d2e
- >> _btod_etento
- >> _ll_udiv10

[Called By]

- >> _printf_fp_dec_real

_printf_input_char (Thumb, 10 bytes, Stack size 0 bytes, _printf_char_common.o(.text))
[Address Reference Count : 1]

- _printf_char_common.o(.text)

_freopen_locked (Thumb, 174 bytes, Stack size 32 bytes, fopen_locked.o(.text))

[Stack]

- Max Depth = 140
- Call Chain = _freopen_locked ⇒ _fclose_internal ⇒ _fflush ⇒ _writebuf ⇒ _sys_write ⇒ stdout_putchar

[Calls]

- >> _mutex_release
- >> _mutex_acquire
- >> _sys_open
- >> _fseek
- >> _fclose_internal

[Called By]

- >> _fopen$locked
- >> freopen

Heap1_SizeAdjust (Thumb, 8 bytes, Stack size 0 bytes, h1_alloc_mt.o(.text), UNUSED)

[Called By]

- >> _malloc_internal

### Undefined Global Symbols
