HaoFengChenFu/X02X03X04_Casa_Domotica/Mando/PCB/Emisor/Schematic_MANDO_555_2023-03-28.pdf

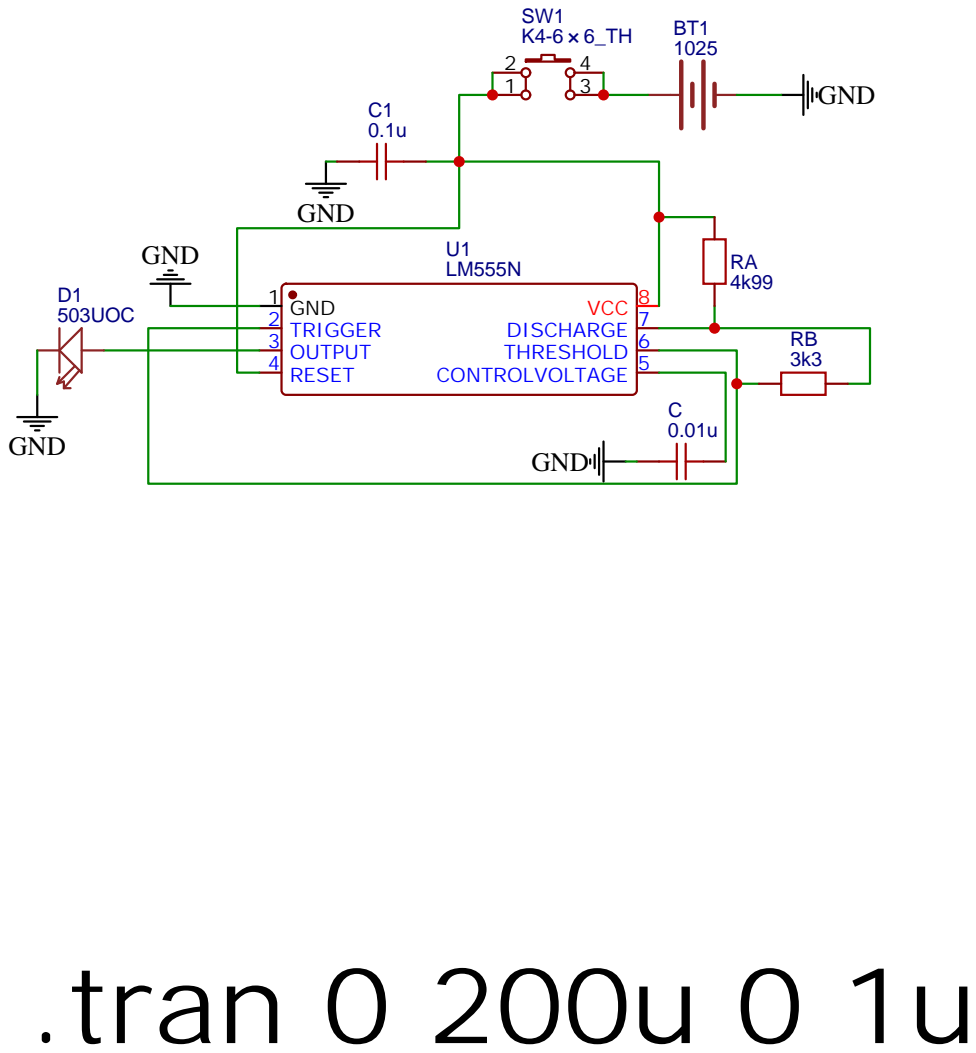
[picture p60: page 1]
