HaoFengChenFu/X02X03X04_Casa_Domotica/Docu/Esquematicos/Mando_Piezo_Alimentacion.pdf

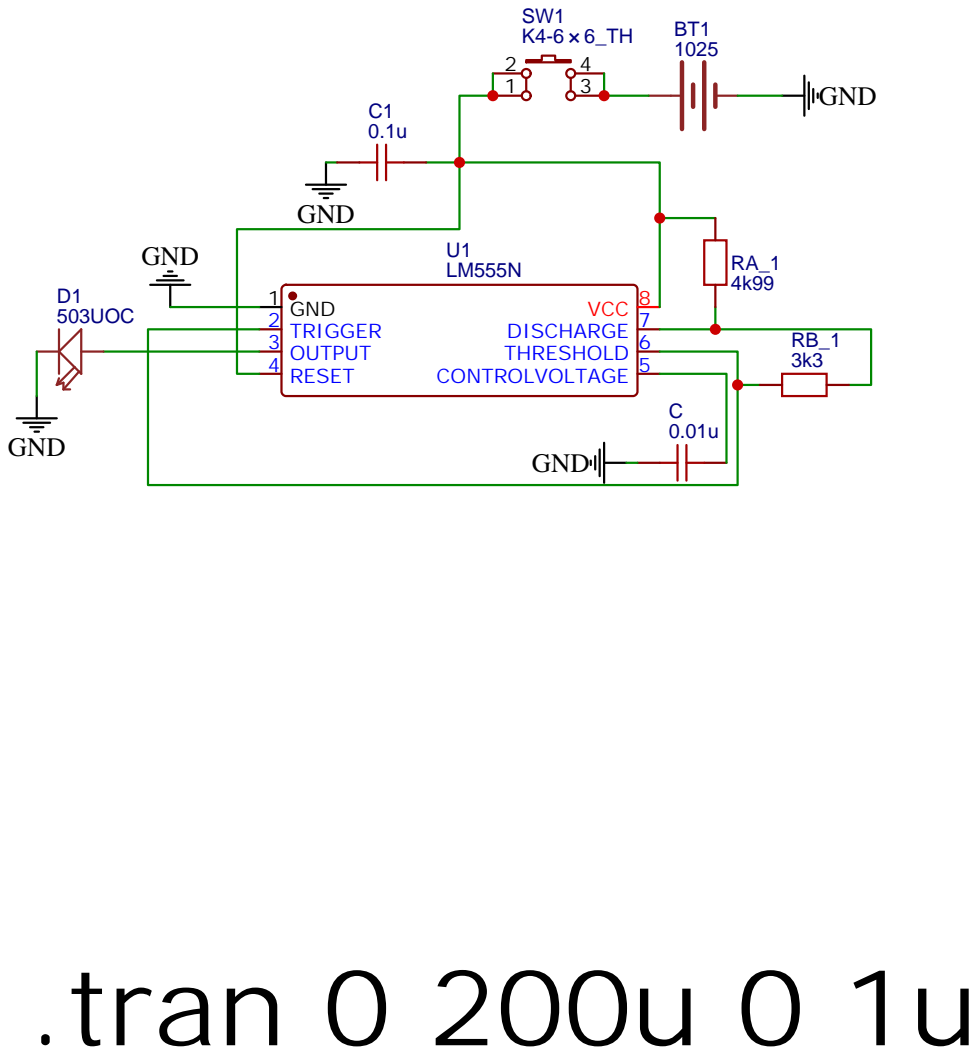
[picture p61: page 1]

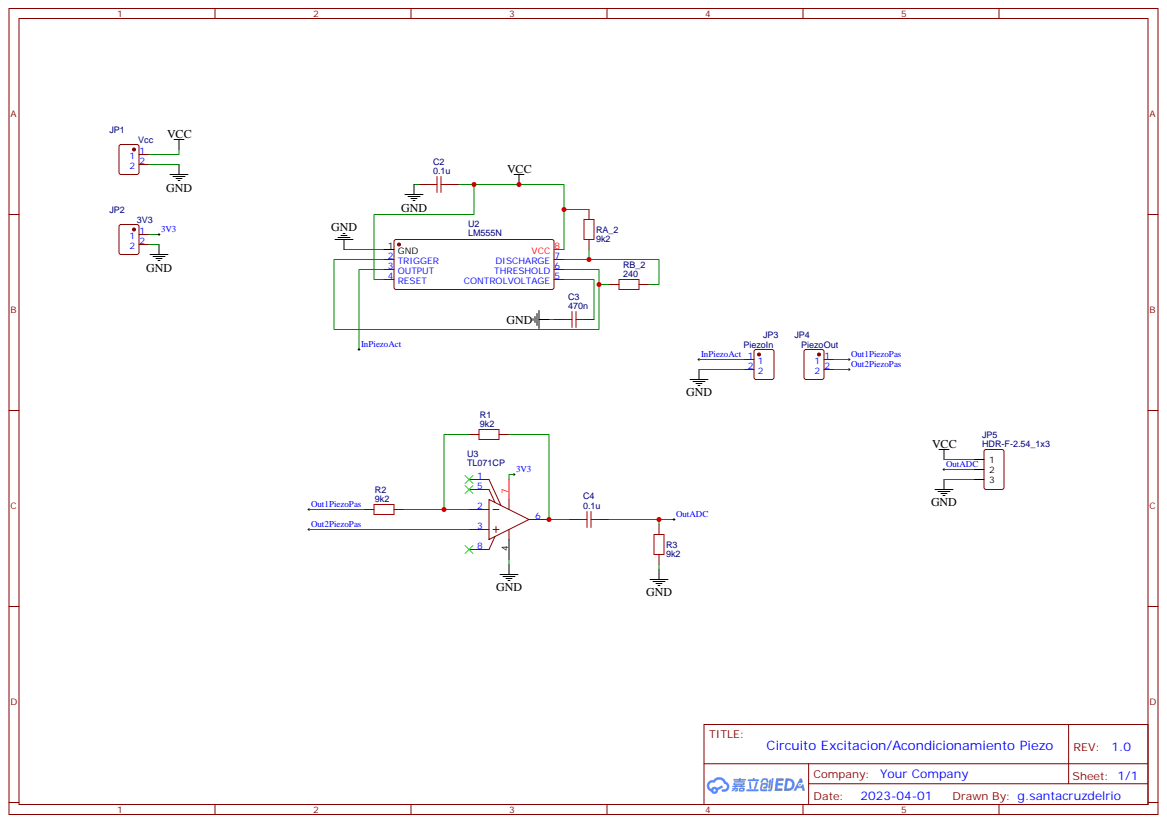
[picture p62: page 2]

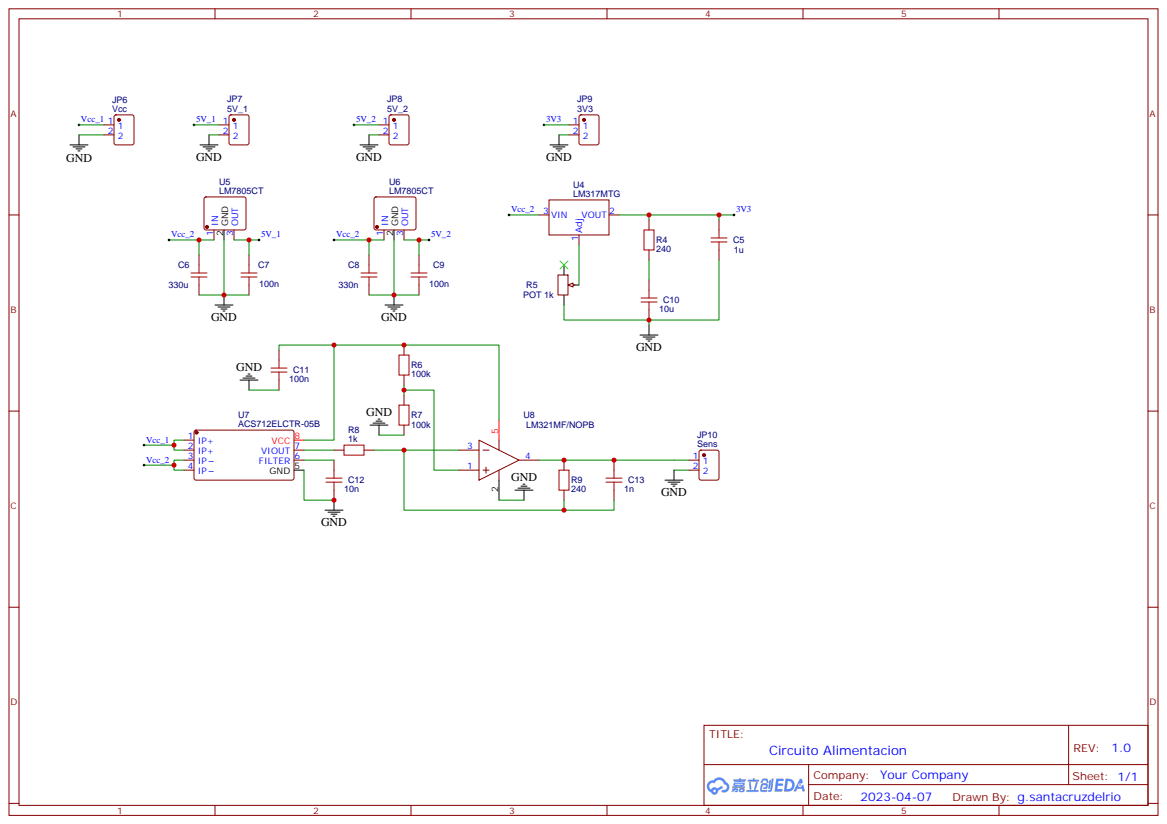
[picture p63: page 3]
