HaoFengChenFu/X02X03X04_Casa_Domotica/Mando/PCB/Emisor/PCB_PCB_MANDO_555_2023-03-28.pdf

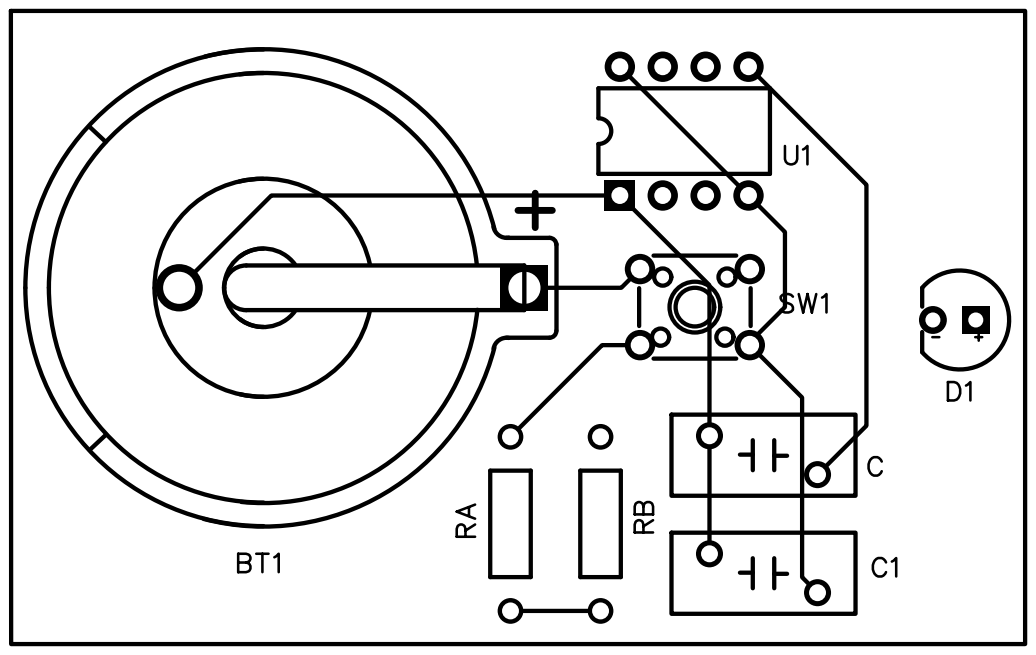
[picture p64: page 1]
