HaoFengChenFu/X02X03X04_Casa_Domotica/Principal_Version2/main.c

/**
  ******************************************************************************
  * @file    Templates/Src/main.c 
  * @author  MCD Application Team
  * @brief   Main program body
  *
  * @note    modified by ARM
  *          The modifications allow to use this file as User Code Template
  *          within the Device Family Pack.
  ******************************************************************************
  * @attention
  *
  * <h2><center>&copy; COPYRIGHT(c) 2017 STMicroelectronics</center></h2>
  *
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
  ******************************************************************************
  */

/* Includes ------------------------------------------------------------------*/
#include "main.h"
#include "Principal.h"


FLASH_OBProgramInitTypeDef *ob;

#ifdef RTE_CMSIS_RTOS2_RTX5
/**
  * Override default HAL_GetTick function
  */
uint32_t HAL_GetTick (void) {
  static uint32_t ticks = 0U;
         uint32_t i;

  if (osKernelGetState () == osKernelRunning) {
    return ((uint32_t)osKernelGetTickCount ());
  }

  /* If Kernel is not running wait approximately 1 ms then increment 
     and return auxiliary tick counter value */
  for (i = (SystemCoreClock >> 14U); i > 0U; i--) {
    __NOP(); __NOP(); __NOP(); __NOP(); __NOP(); __NOP();
    __NOP(); __NOP(); __NOP(); __NOP(); __NOP(); __NOP();
  }
  return ++ticks;
}

#endif

/** @addtogroup STM32F4xx_HAL_Examples
  * @{
  */

/** @addtogroup Templates
  * @{
  */

/* Private typedef -----------------------------------------------------------*/
/* Private define ------------------------------------------------------------*/
/* Private macro -------------------------------------------------------------*/
/* Private variables ---------------------------------------------------------*/
/* Private function prototypes -----------------------------------------------*/
static void SystemClock_Config(void);
static void Error_Handler(void);

/* Private functions ---------------------------------------------------------*/
/**
  * @brief  Main program
  * @param  None
  * @retval None
  */
int main(void)
{

  /* STM32F4xx HAL library initialization:
       - Configure the Flash prefetch, Flash preread and Buffer caches
       - Systick timer is configured by default as source of time base, but user 
             can eventually implement his proper time base source (a general purpose 
             timer for example or other time source), keeping in mind that Time base 
             duration should be kept 1ms since PPP_TIMEOUT_VALUEs are defined and 
             handled in milliseconds basis.
       - Low Level Initialization
     */
  HAL_Init();

  /* Configure the system clock to 168 MHz */
  SystemClock_Config();
  SystemCoreClockUpdate();

  /* Add your application code here
     */
	HAL_FLASHEx_OBGetConfig(ob);

#ifdef RTE_CMSIS_RTOS2
  /* Initialize CMSIS-RTOS2 */
  osKernelInitialize ();

	// Inicializar los pines sin hilos
	Init_All_Pins();


  osThreadNew(app_main, NULL, &app_main_attr);
	
	
	// Inicializar los threads
	Init_ThPrincipal();
	
	
	
  /* Start thread execution */
  osKernelStart();
#endif

  /* Infinite loop */
  while (1)
  {
  }
}


/**
  * @brief  System Clock Configuration
  *         The system Clock is configured as follow :
  *            System Clock source            = PLL (HSE)
  *            SYSCLK(Hz)                     = 168000000
  *            HCLK(Hz)                       = 168000000
  *            AHB Prescaler                  = 1
  *            APB1 Prescaler                 = 4
  *            APB2 Prescaler                 = 2
  *            HSE Frequency(Hz)              = 8000000
  *            PLL_M                          = 25
  *            PLL_N                          = 336
  *            PLL_P                          = 2
  *            PLL_Q                          = 7
  *            VDD(V)                         = 3.3
  *            Main regulator output voltage  = Scale1 mode
  *            Flash Latency(WS)              = 5
  * @param  None
  * @retval None
  */
static void SystemClock_Config(void)
{
  RCC_ClkInitTypeDef RCC_ClkInitStruct;
  RCC_OscInitTypeDef RCC_OscInitStruct;
	RCC_PeriphCLKInitTypeDef PeriphClkInitStruct;

  /* Enable Power Control clock */
  __HAL_RCC_PWR_CLK_ENABLE();

  /* The voltage scaling allows optimizing the power consumption when the device is 
     clocked below the maximum system frequency, to update the voltage scaling value 
     regarding system frequency refer to product datasheet.  */
  __HAL_PWR_VOLTAGESCALING_CONFIG(PWR_REGULATOR_VOLTAGE_SCALE1);

  /* Enable HSE Oscillator and activate PLL with HSE as source */
  RCC_OscInitStruct.OscillatorType = RCC_OSCILLATORTYPE_HSE;
  RCC_OscInitStruct.HSEState = RCC_HSE_ON;
  RCC_OscInitStruct.PLL.PLLState = RCC_PLL_ON;
  RCC_OscInitStruct.PLL.PLLSource = RCC_PLLSOURCE_HSE;
  RCC_OscInitStruct.PLL.PLLM = 4;
  RCC_OscInitStruct.PLL.PLLN = 168;
  RCC_OscInitStruct.PLL.PLLP = RCC_PLLP_DIV2;
  RCC_OscInitStruct.PLL.PLLQ = 7;
  if(HAL_RCC_OscConfig(&RCC_OscInitStruct) != HAL_OK)
  {
    /* Initialization Error */
    Error_Handler();
  }
	/* Enable LSE Oscillator */
	RCC_OscInitStruct.OscillatorType = RCC_OSCILLATORTYPE_LSE;
	RCC_OscInitStruct.LSEState = RCC_LSE_ON;
	if(HAL_RCC_OscConfig(&RCC_OscInitStruct) != HAL_OK)
  {
    /* Initialization Error */
    Error_Handler();
  }
	
  /* Select PLL as system clock source and configure the HCLK, PCLK1 and PCLK2 
     clocks dividers */
  RCC_ClkInitStruct.ClockType = (RCC_CLOCKTYPE_SYSCLK | RCC_CLOCKTYPE_HCLK | RCC_CLOCKTYPE_PCLK1 | RCC_CLOCKTYPE_PCLK2);
  RCC_ClkInitStruct.SYSCLKSource = RCC_SYSCLKSOURCE_PLLCLK;
  RCC_ClkInitStruct.AHBCLKDivider = RCC_SYSCLK_DIV1;
  RCC_ClkInitStruct.APB1CLKDivider = RCC_HCLK_DIV4;  
  RCC_ClkInitStruct.APB2CLKDivider = RCC_HCLK_DIV2;  
  if(HAL_RCC_ClockConfig(&RCC_ClkInitStruct, FLASH_LATENCY_5) != HAL_OK)
  {
    /* Initialization Error */
    Error_Handler();
  }
	PeriphClkInitStruct.PeriphClockSelection = RCC_PERIPHCLK_RTC;
  PeriphClkInitStruct.RTCClockSelection = RCC_RTCCLKSOURCE_LSE;
	if (HAL_RCCEx_PeriphCLKConfig(&PeriphClkInitStruct) != HAL_OK)
	{
		/* Initialization Error */
    Error_Handler();
	}
  /* STM32F405x/407x/415x/417x Revision Z devices: prefetch is supported */
  if (HAL_GetREVID() == 0x1001)
  {
    /* Enable the Flash prefetch */
    __HAL_FLASH_PREFETCH_BUFFER_ENABLE();
  }
}	

/**
  * @brief  This function is executed in case of error occurrence.
  * @param  None
  * @retval None
  */
static void Error_Handler(void)
{
  /* User may add here some code to deal with this error */
  while(1)
  {
  }
}

#ifdef  USE_FULL_ASSERT

/**
  * @brief  Reports the name of the source file and the source line number
  *         where the assert_param error has occurred.
  * @param  file: pointer to the source file name
  * @param  line: assert_param error line source number
  * @retval None
  */
void assert_failed(uint8_t* file, uint32_t line)
{ 
  /* User can add his own implementation to report the file name and line number,
     ex: printf("Wrong parameters value: file %s on line %d\r\n", file, line) */

  /* Infinite loop */
  while (1)
  {
  }
}

#endif

/**
  * @}
  */ 

/**
  * @}
  */ 

/************************ (C) COPYRIGHT STMicroelectronics *****END OF FILE****/
