HaoFengChenFu/X02X03X04_Casa_Domotica/Principal_Version2/Arial12x12.h

#ifndef __arial2x12_h
#define __arial2x12_h
const unsigned char Arial12x12[] = {	// El primer valor indica el offset

        0x07, 0x00, 0x00, 0x00, 0x00, 0x00, 0x00, 0x00, 0x00, 0x00, 0x00, 0x00, 0x00, 0x00, 0x00, 0x00, 0x00, 0x00, 0x00, 0x00, 0x00, 0x00, 0x00, 0x00, 0x00,  // Code for char  
        0x02, 0x00, 0x00, 0x7F, 0x01, 0x00, 0x00, 0x00, 0x00, 0x00, 0x00, 0x00, 0x00, 0x00, 0x00, 0x00, 0x00, 0x00, 0x00, 0x00, 0x00, 0x00, 0x00, 0x00, 0x00,  // Code for char !
        0x03, 0x07, 0x00, 0x00, 0x00, 0x07, 0x00, 0x00, 0x00, 0x00, 0x00, 0x00, 0x00, 0x00, 0x00, 0x00, 0x00, 0x00, 0x00, 0x00, 0x00, 0x00, 0x00, 0x00, 0x00,  // Code for char "
        0x07, 0x24, 0x00, 0xA4, 0x01, 0x7C, 0x00, 0xA7, 0x01, 0x7C, 0x00, 0x27, 0x00, 0x24, 0x00, 0x00, 0x00, 0x00, 0x00, 0x00, 0x00, 0x00, 0x00, 0x00, 0x00,  // Code for char #
        0x06, 0x00, 0x00, 0xCE, 0x00, 0x11, 0x01, 0xFF, 0x03, 0x11, 0x01, 0xE2, 0x00, 0x00, 0x00, 0x00, 0x00, 0x00, 0x00, 0x00, 0x00, 0x00, 0x00, 0x00, 0x00,  // Code for char $
        0x0A, 0x00, 0x00, 0x0E, 0x00, 0x11, 0x00, 0x11, 0x01, 0xCE, 0x00, 0x38, 0x00, 0xE6, 0x00, 0x11, 0x01, 0x10, 0x01, 0xE0, 0x00, 0x00, 0x00, 0x00, 0x00,  // Code for char %
        0x08, 0x00, 0x00, 0xE0, 0x00, 0x1E, 0x01, 0x11, 0x01, 0x29, 0x01, 0xC6, 0x00, 0xA0, 0x00, 0x00, 0x01, 0x00, 0x00, 0x00, 0x00, 0x00, 0x00, 0x00, 0x00,  // Code for char &
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
        0x08, 0x00, 0x00, 0xFE, 0x01, 0x02, 0x01, 0x02, 0x01, 0x02, 0x01, 0x02, 0x01, 0x02, 0x01, 0xFE, 0x01, 0x00, 0x00, 0x00, 0x00, 0x00, 0x00, 0x00, 0x00   // Code for char 
        };
#endif
