HaoFengChenFu/X02X03X04_Casa_Domotica/Principal_Version2/pulsador.c

#include "pulsador.h"
#include "modo_sleep.h"
#include "principal.h"

/*-------------------------------------------------------------------------------
 *      Thread 'ThPulsador': Hilo que gestiona las interrupciones del pulsador
 *-----------------------------------------------------------------------------*/
osThreadId_t tid_ThPulsador;



/*------------------------------------------------------------------
          Funciona que inicializa el pin del pulsador
 -----------------------------------------------------------------*/
void Init_Pin_Pulsador(void)
{  
	GPIO_InitTypeDef GPIO_InitStruct;
  __HAL_RCC_GPIOC_CLK_ENABLE();

  GPIO_InitStruct.Mode = GPIO_MODE_IT_RISING;
  GPIO_InitStruct.Pull = GPIO_PULLDOWN;
  GPIO_InitStruct.Speed = GPIO_SPEED_FREQ_LOW;

  GPIO_InitStruct.Pin = GPIO_PIN_13;                               // Usuario
  HAL_GPIO_Init(GPIOC, &GPIO_InitStruct);                          //Puertos C

  HAL_NVIC_EnableIRQ(EXTI15_10_IRQn);
}
