HaoFengChenFu/X02X03X04_Casa_Domotica/Principal_Version2/PIR.h

#ifndef __PIR_H
#define __PIR_H

	#include "stm32f4xx_hal.h"
	#include "stdio.h"
	#include "cmsis_os2.h"
	#include "stdbool.h"
	
	int Init_ThPIR(void);
	void Init_PIR_Pin(void);
	void desactivacion_PIR(void);
	
	int Init_MsgPIR (void);
	int Init_timer_PIR (void);
#endif
