HaoFengChenFu/X02X03X04_Casa_Domotica/Principal_Version2/Mando.h

#ifndef __MANDO_H
#define __MANDO_H

	#include <stdio.h>
	#include "stm32f4xx_hal.h"
	#include "cmsis_os2.h"                          // CMSIS RTOS header file
	
	int Init_ThMando  (void);
	void	Init_Mando_Pin(void);
	static void Callback_TimerRebotes (void *argument);
	int Init_MsgQueue_Mando(void);	
#endif
