HaoFengChenFu/X02X03X04_Casa_Domotica/Principal_Version2/rtc.h

#ifndef __RTC_H
#define __RTC_H

#include "stm32f4xx_hal.h"
#include "stm32f4xx_hal_rtc.h"
#include "stdint.h"
#include "stdio.h"
#include "string.h"
#include "lcd.h"
#include "cmsis_os2.h"
#include "SNTP.h"
	
	typedef struct{
		uint8_t horas;
		uint8_t minutos;
		uint8_t segundos;
		
		uint8_t anno;
		uint8_t mes;
		uint8_t dia;
	} FechaHora;
	
	void RTC_Init(void);
	void Get_RTC_Time(void);
	void Set_RTC_Time(uint8_t hour, uint8_t minute, uint8_t second);
	void Get_Date_RTC(void);
	void Set_RTC_Date(uint8_t year, uint8_t month, uint8_t week, uint8_t date);
	void Set_Alarm(uint8_t hour, uint8_t minute, uint8_t second);

	void Get_Date_Time(void);
	
	int Init_ThRTC (void);
	int Init_timer_RTC (void);
#endif
