HaoFengChenFu/X02X03X04_Casa_Domotica/Prueba_IWDG/configuracion.c

#include "stm32f4xx_hal.h"
#include "configuracion.h"

void configuracion(){//inicializacion de los leds
	
	static GPIO_InitTypeDef GPIO_InitStruct;
	__HAL_RCC_GPIOB_CLK_ENABLE();
	
	GPIO_InitStruct.Mode = GPIO_MODE_OUTPUT_PP;
	GPIO_InitStruct.Pull = GPIO_PULLUP;
	GPIO_InitStruct.Speed = GPIO_SPEED_FREQ_VERY_HIGH;

	GPIO_InitStruct.Pin = GPIO_PIN_0;
	HAL_GPIO_Init(GPIOB, &GPIO_InitStruct);
	GPIO_InitStruct.Pin = GPIO_PIN_7;
	HAL_GPIO_Init(GPIOB, &GPIO_InitStruct);
	GPIO_InitStruct.Pin = GPIO_PIN_14;
	HAL_GPIO_Init(GPIOB, &GPIO_InitStruct);
	
}

void reset_leds(){//OFF leds
	
	HAL_GPIO_WritePin(GPIOB, GPIO_PIN_14, GPIO_PIN_RESET);
	HAL_GPIO_WritePin(GPIOB, GPIO_PIN_7, GPIO_PIN_RESET);
	HAL_GPIO_WritePin(GPIOB, GPIO_PIN_0, GPIO_PIN_RESET);
	//RGB LEDS
	HAL_GPIO_WritePin(GPIOD, GPIO_PIN_13, GPIO_PIN_SET);
	HAL_GPIO_WritePin(GPIOD, GPIO_PIN_12, GPIO_PIN_SET);
	HAL_GPIO_WritePin(GPIOD, GPIO_PIN_11, GPIO_PIN_SET);
	
	
}

void init_rgb(void){
	__HAL_RCC_GPIOD_CLK_ENABLE();
	
	static GPIO_InitTypeDef GPIO_InitStruct;
	
	GPIO_InitStruct.Mode = GPIO_MODE_OUTPUT_PP;
	GPIO_InitStruct.Pull = GPIO_PULLDOWN;
	GPIO_InitStruct.Speed = GPIO_SPEED_FREQ_VERY_HIGH;

	GPIO_InitStruct.Pin = GPIO_PIN_13;
	HAL_GPIO_Init(GPIOD, &GPIO_InitStruct);
	GPIO_InitStruct.Pin = GPIO_PIN_12;
	HAL_GPIO_Init(GPIOD, &GPIO_InitStruct);
	GPIO_InitStruct.Pin = GPIO_PIN_11;
	HAL_GPIO_Init(GPIOD, &GPIO_InitStruct);
  //RGB OFF
	HAL_GPIO_WritePin(GPIOD, GPIO_PIN_13, GPIO_PIN_SET);
	HAL_GPIO_WritePin(GPIOD, GPIO_PIN_12, GPIO_PIN_SET);
	HAL_GPIO_WritePin(GPIOD, GPIO_PIN_11, GPIO_PIN_SET);
}

void init_user_botton(){
	
	   GPIO_TypeDef* BUTTON_PORT[BUTTONn] = {USER_BUTTON_GPIO_PORT}; 
    const uint16_t BUTTON_PIN[BUTTONn] = {USER_BUTTON_PIN}; 
    const uint8_t BUTTON_IRQn[BUTTONn] = {USER_BUTTON_EXTI_IRQn};
		
	  static GPIO_InitTypeDef GPIO_InitStruct;
	 /* Configure Button pin as input with External interrupt */
    GPIO_InitStruct.Pin = BUTTON_PIN[0];
    GPIO_InitStruct.Pull = GPIO_NOPULL;
    GPIO_InitStruct.Mode = GPIO_MODE_IT_FALLING; 
    HAL_GPIO_Init(BUTTON_PORT[0], &GPIO_InitStruct);
    
    /* Enable and set Button EXTI Interrupt to the lowest priority */
    HAL_NVIC_SetPriority((IRQn_Type)(BUTTON_IRQn[0]), 0x0F, 0x00);
    HAL_NVIC_EnableIRQ((IRQn_Type)(BUTTON_IRQn[0]));
	
}
