HaoFengChenFu/X02X03X04_Casa_Domotica/(commit log)

2023-03-23 Memoria y carpetas de prueba añadidos
2023-03-24 Botones actualizados / Falta acabar de rediseñar lo de dentro
2023-03-25 Inicio Temperatura Humedad
2023-03-25 Codigo del PWM
2023-03-25 Subo carpetas/Words de alimentacion y Mandoa a distancia
2023-03-25 Inicio Sensor PIR
2023-03-27 SE HA ACTUALIZADO ARCHIVO "Mando.docx" tras pruebas de funcionamiento del emisor y receptor con protoboard
2023-03-27 Se ha actualizado el documento de Alimentacion.docxç con los reguladores concretos y la configuración a emplear
2023-03-27 Carpeta Piezo con documentos de apuntes
2023-03-27 Acondicionador de señal TFG piezo
2023-03-27 Actualizando la documentación
2023-03-28 Subo pdf de esquematico y pcb del mando emisor IR
2023-03-28 Carpeta Docu con las memorias en la misma carpeta y editadas
2023-03-29 Pines de la placa
2023-03-30 RTC funcional / Falta testear la temperatura y humedad
2023-03-31 Version Final LCD / Mejora en la lectura del sensor
2023-04-01 Actualizacion de la memoria: Diagrama Hardware / Descripción Pruebas/Módulos / Tablas
2023-04-04 Código referente a la detección de señal del mando a distancia
2023-04-07 Añado datasheets
    Añado los datasheets de los componentes mas interesantes (integrados...) segun el proyecto
2023-04-08 Checkbox de las tareas pendientes
2023-04-09 Pulsador y representa el consumo
2023-04-09 esquemático_reg3v3.jpeg donde se prueba el correcto funcionamiento de la configuración empleada para el regulador LM117 cuya tensión de salida se pretende que sea de 3.3V y análisis térmico.pdf que j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
2023-04-09 Se ha modificado el regulador LM117 por un LM317 con el fin de prescindir del disipador térmico y obtener mejores prestaciones
2023-04-09 version funcional del ventilador con servomotor
2023-04-09 datasheet servomotor
2023-04-14 presupuesto actualizado
    [Presupuesto.xlsx]
2023-04-14 Nueva versión Sensor PIR
2023-04-14 version funcional con sensor PIR
2023-04-14 Codigo problematico/ No deja cambiar los pines del I2C
    [Arial12x12.h, HTTP_Server.c, HTTP_Server_CGI.c, PIR.c, PIR.h, Principal.c, Principal.h, SNTP.c]
2023-04-15 LDR/Iluminacion funcional/Falta gestionar el mando
2023-04-16 diseño de funciones para manejar la flash
2023-04-18 Versión de Prueba para mañana
2023-04-19 Prueba 2 para el termostato
2023-04-19 Aumentando la memoria de los hilos
2023-04-19 Representacion datos / Falta el refresco
2023-04-19 Se han realizado cambios sustanciales en el modulo del mando + garaje quedando este ya funcional
2023-04-20 subo esquemas definitivos y BOM de las 3 pcbs
    [BOM_TODO_2023-04-20.csv]
2023-04-20 Forzado de luz y ventilador desde la web
2023-04-22 Mando con cola de mensajes funcional
2023-04-23 Servidor: RTC y Temperatura funcionando a la vez
2023-04-23 Server: Representacion de datos funcional
2023-04-24 Mando incluido en el principal
2023-04-25 Garaje + Mando con TimeOut de 5 segundos
2023-04-26 Manejo Ventilador desde el servidor
2023-04-27 Tabla de la memoria actualizada
2023-05-05 buffer rx y tx para la flash implementados
2023-05-07 Adaptacion para bajo consumo
2023-05-10 Garaje modificado en Principal para funcionar con TimeOut
2023-05-12 Funciona / Falta comprobar el bajo consumo
2023-05-13 Problemas de los tiempos arreglado
    [Arial12x12.h, Consumo.c, Consumo.h, HTTP_Server.c, HTTP_Server_CGI.c, Iluminacion.c, Iluminacion.h, Interrupciones.c]
2023-05-13 Arreglando problemas de tiempos
2023-05-15 Timer para el LDR
